runeharlyk/SpotMicroESP32-Leika/docs/software_description.md

# Software description

The firmware runs on ESP-IDF and is built through PlatformIO (`framework = espidf` in `platformio.ini`).
It targets the ESP32, ESP32-S3 and ESP32-P4; the environments are listed in `platformio.ini`.
The sensor drivers, the IMU fusion, the PCA9685 driver and the I2C bus layer are part of the repository (`esp32/include/peripherals`), not external libraries.

The external dependencies are:

- ESP-IDF components from the component manager (`esp32/src/idf_component.yml`): `espressif/mdns`, `joltwallet/littlefs`, `espressif/esp-dsp`, `espressif/led_strip`, and `espressif/esp32-camera` on every target except the ESP32-P4
- `esp_wifi_remote`, `esp_hosted` and `esp_cam_sensor` on the ESP32-P4 only, which reaches WiFi through an ESP32-C6 coprocessor and the camera through MIPI CSI
- [nanopb](https://github.com/nanopb/nanopb), a git submodule, for the protobuf messages in `platform_shared/`

#### Structure

The software runs these FreeRTOS tasks.

| Task | Description | Priority | Core |
| --- | --- | --- | --- |
| Control task | Applies controller input, runs the motion state and inverse kinematics, writes the servos, records telemetry. Runs every 10 ms (100 Hz) | 5 | 1 |
| Sensor task | Reads the IMU on every pass and the slower sensors when due. Paced by a 5 ms timer. Also runs bus work queued by the socket, such as an I2C scan or an IMU calibration | 4 | 1 |
| Service task | Starts WiFi, the access point, mDNS, the camera and the web server, then loops every 100 ms: access point management, periodic broadcasts, telemetry batches | 2 | any |
| HTTP server task | The ESP-IDF `esp_http_server` task: serves the web app, the camera stream and the WebSocket. Stack of 16 KiB | 5 | any |
| DNS server task | Captive portal on the access point | 3 | any |
| CSI capture task | Captures JPEG frames from the MIPI CSI camera (ESP32-P4 only) | 6 | 1 |

An mDNS query (priority 3) and the restart sequence (priority 10) each run in a short-lived task of their own.

The tasks share state in three ways, none of which can stall the control loop:

- The socket's handlers and the handheld controller's receiver post controller input, mode and gait to a mutex-guarded inbox (`motion_inbox.h`) that holds only the newest of each. The control task takes it once per tick, so only the control task touches the motion state.
- The sensor task writes its latest readings under a lock that is held only for the copy. The control and service tasks copy them out.
- The control task pushes telemetry ticks into a lock-free single-producer, single-consumer ring (`telemetry/spsc_ring.h`). A full ring refuses the tick and counts it as dropped; the control task never waits.

#### Control loop

Each 10 ms tick of the control task (`SpotControlLoopEntry` in `esp32/src/main.cpp`) does the following.

1. Copies the latest IMU sample.
1. Runs `MotionService::update`: applies the inbox, then steps the active motion state, solves the inverse kinematics and applies the per-joint sign.
1. On a mode change, activates or deactivates the servo board.
1. Runs `ServoController::update`: limits each joint's speed, converts the angles to PWM and writes all channels to the PCA9685 in one I2C burst.
1. Records a telemetry tick, but only while a client is subscribed to the telemetry stream.
1. Waits for the next tick. A tick that overran restarts the schedule instead of catching up.

The motion states, the command smoothing and the gaits are described in [Motion system](motion_system.md), and the kinematics in [Kinematics](kinematics.md).

#### Sensors

All sensors are optional.
The robot walks without any of them, but the stand mode levels the body only with an IMU.

Every driver is built in, and the sensor task probes the I2C bus at boot.
The IMU is the first chip that answers in the order ICM-20948, BNO055, MPU6050: the ICM-20948 and the MPU6050 share address 0x68, and starting an MPU6050 resets whatever chip is there.
A sensor disabled in the peripheral settings is only identified by its address and chip ID, so the app can show it as detected, and is never configured.
A change of what is disabled probes again, which restarts the fusion; other peripheral saves do not.

| Chip | Rate | Compass | Orientation |
| --- | --- | --- | --- |
| MPU6050 | 200 Hz | None; add an HMC5883L | Madgwick filter |
| ICM-20948 | 200 Hz | Built in (AK09916), 100 Hz | Madgwick filter |
| BNO055 | 100 Hz | Built in, 20 Hz | The chip's own NDOF fusion |

The `Imu` class (`peripherals/imu/imu.h`) turns a chip's readings into body-frame samples (x forward, y left, z up):

- The mounting matrix from the peripheral settings rotates the chip frame into the body frame.
- The gyro bias is measured at boot while the robot is still, over 200 samples. If the robot moves, the bias is left at zero.
- For the MPU6050 and the ICM-20948 a Madgwick filter fuses the gyro and the accelerometer, and the compass when a fresh reading exists. Its gain is an IMU setting that defaults to 0.1, and is 2.5 during the first two seconds so that the first estimate is quick. Without a compass the yaw drifts, and the sample says so with the `YAW_DRIFTS` flag.
- Each sample also carries the gyro's z rate integrated over every read since the IMU started (`gyroYaw`), from which the odometry takes the mean rate between the samples two control ticks find.
- The BNO055 reports its own fused quaternion, which is rotated by the mounting. The Madgwick filter is not used for it.
- A separate HMC5883L compass (75 Hz) supplies the compass for a chip without one. Its alignment, hard-iron offset and soft-iron matrix are IMU settings. A compass that has been silent for three of its periods is ignored. A disabled compass is left out of the fusion, the chip's own as well as a separate one; the BNO055's own fusion keeps using its compass.
- The tilt of a still robot can be folded into the stored mounting from the app, so that a robot on a level surface reads level. The tilt must be under 15 degrees.

The other sensors are read when due:

| Chip | Address | Rate | Reports |
| --- | --- | --- | --- |
| PAJ7620U2 gesture sensor | 0x73 | 100 ms | A gesture, which steps the modes |
| BMP180 barometer | 0x77 | 500 ms | Pressure, temperature and altitude |
| INA219 power sensor | 0x41 by default, 0x41 - 0x4F | 100 ms | The servo rail's voltage and current |

The INA219 sits in the servo rail; 0x40 is the PCA9685's, so its A0 is tied high, and its address is a peripheral setting.
Its calibration follows from the shunt resistance and the largest current expected, both settings (0.1 Ohm and 3.2 A by default): the current's resolution is that current over 2^15, and the shunt range the narrowest of 40 - 320 mV that holds it.
The bus voltage is averaged over 8.5 ms so that a dip shows, the shunt over 68 ms so that the current is the mean between reads.
A chip that reset, by a dip on its own supply, is configured again on the next read.
Below the cut-off voltage (a setting, 0 for off by default) for 2 s, the robot deactivates and logs why, and it is held deactivated until the rail rises 0.2 V above the cut-off; the servos going limp take their load off, so only a battery with charge left recovers that far.
A current above the stall current (3 A by default) for the stall time (1 s) sets a stall flag, which is only reported.
The readings stream as `PowerData`, and each telemetry network sample carries the rail's voltage, its lowest voltage since the previous sample and its current, so a recording shows the supply dips.
A gesture steps along the ladder rest - sit - stand (`esp32/include/gesture_control.h`): down from walk stands, down from stand plays the built-in `sit` clip and holds it, down again rests, and up steps back up to stand; left and right select walk.
From stand or walk, forward and backward walk 10 cm and anticlockwise and clockwise turn a full circle, as [goal moves](motion_system.md#goal-moves) on the odometry.
A gesture that arrives while a clip moves the legs or a goal runs is discarded, not queued.

#### Variant

The variant is a robot setting (`robotSettings.pb`), read in `app_main` before any task starts.
A change is accepted only while the robot is deactivated; it is stored and posted to the control task, which switches the motion code and the joint model in one tick and resets the body to the new variant's default pose.
It selects the leg geometry (`KIN_CONFIG_*` in `kinematics.h`) and the joint model (`joint_model.h`) through `variant.h`.
A robot without a variant has neither: the motion service refuses every mode but deactivated, and the servo board stays asleep.

#### Servo output

The twelve joints are driven by a PCA9685 at 50 Hz from a 27 MHz oscillator.
The board starts asleep with every channel off, so that the legs do not jump to the pose a board kept across a reset.
It wakes when a mode that moves the legs (rest, stand, walk) is selected or the app activates the servos.
Selecting a mode without a motion state (deactivated, idle, calibration) puts it back to sleep.

Each joint's PWM follows from three parts:

1. The joint model of the variant (`joint_model.h`): the sign of each joint, the servo angle at which the joint is at its kinematic zero, and the PWM counts per degree (2.0).
1. The robot's own calibration (`servoSettings.pb`): the centre PWM of each joint (306 by default) and, optionally, which PCA9685 channel each joint uses.
1. A clamp to 125 - 600 counts, the range the servos accept.

The joints do not follow their targets directly.
Each moves toward its target by at most 96 % of the MG92B's rated speed at the servo supply stored in the servo settings (`supply_voltage`, 6 V when never set): 720 degrees per second at 6 V, 443 at 4.8 V, linear in between and held at the nearer rating outside (`servoSpeedLimit` in `peripherals/servo_output.h`).
A tick counts as at most 20 ms long so that a stall does not release a jump.
A new supply holds from the next tick, and the control task hands the same limit to the walk, which caps its joints at three quarters of it.
This limit is the only filtering between the motion state's angles and the servos; the smoothing of the commands is done in the motion states.

#### Settings and communication

Services keep their settings as protobuf files in the `/config` directory of the LittleFS partition: WiFi, access point, camera, servo, peripheral (pins, I2C frequency, IMU, disabled sensors, LED strip) and robot (name and variant).
An invalid settings write is refused and leaves the stored settings unchanged.

Apart from the camera stream (`/api/camera/stream`, MJPEG) and the embedded web app, the robot's API is the WebSocket at `/api/ws`, carrying protobuf messages from `platform_shared/message.proto`.
Commands, periodic broadcasts, settings, file transfer and the per-tick telemetry stream all travel over it, see [WebSocket](websocket.md).
The protocol also travels over the serial link, beside the log, see [Serial link](serial.md): all of it on the USB-Serial-JTAG port, and requests only on the console UART.
A `SerialLink` adapter handles both ports, each as one client, and the log goes out through its writer so a line never splits a frame.
The firmware registers every handler on every link and sends each stream to its subscribers on each.
On the S3 boards with PSRAM, a `NimbleLink` adapter serves the app over a Bluetooth LE Nordic UART Service, with the commands, requests and broadcasts of the WebSocket but no telemetry and no file or firmware transfer, see [Bluetooth link](bluetooth.md).
The service task broadcasts the IMU, the sonars, the servo rail and RSSI every 100 ms and the system analytics every 2 s, to the clients that subscribed on any link.
The analytics include every task's least free stack since it started, tightest first (System metrics), which is what a stack can be trimmed by; the serial link's 8 KB read task is the one the heap budget points at.

The telemetry stream is recorded only while a client is subscribed.
The control task puts one sample per tick in a ring of 64 ticks, and the service task sends them in batches of 10, preceded by a header describing the robot's firmware, variant, IMU and settings.

#### Handheld controller

The robot can be driven without the app by the ESP-NOW handheld controller (the separate `esp-now-controller` firmware, shared with the Hexapod).
The receiver is switched on in the peripheral settings (the Sensors page) and is off by default, since it beacons ten times a second.
ESP-NOW broadcasts have no pairing, so the robot obeys the first controller whose frame it hears after the receiver starts and ignores every other sender; switching the receiver off and on lets another controller take over.
The switch applies at once.
The ESP32-P4 has no radio of its own for ESP-NOW, so it builds without the receiver and reports it unsupported (`espnow_controller_supported` in the features).

The controller broadcasts a 14-byte packet (`communication/controller_packet.h`, kept byte-identical with the controller firmware): a version, a button mask and four sticks in -1000 to 1000.
A frame of another length or version is ignored.
`HandheldController` (`communication/handheld_controller.h`) maps it as the Hexapod does:

| Input | Effect |
| --- | --- |
| Sticks | The app's sticks, scaled to -1 to 1 |
| Left stick button | The next mode of deactivated, rest, stand and walk, and from walk back to deactivated; from idle or calibration it selects rest |
| Right stick button | Toggles trot and crawl, except in stand |
| Right stick button held in stand | The right stick's y sets the body height instead of the pitch: centred is the default 0.7, the ends are the lowest and the highest; the height stays when the button is released |
| Both stick buttons | Deactivates, and does nothing else |
| Buttons A, B and C | Not used |

A button acts when it goes down; a press of both that lands one frame apart first acts as the single button.
The controller has no sliders, so the speed and the step height are the app's defaults of 0.5.
The receiver posts to the motion inbox as the socket's handlers do, so the controller is held to the same rules: no mode change during a firmware update, none but deactivated without a variant, and the dead-man stop when it falls silent while a stick is off centre.
It posts the input with every frame while a stick is off centre, and otherwise only when it changes, so an idle controller does not override the app; whichever of the two moved last is followed.

ESP-NOW hears only the channel the radio is on, and one radio serves the station, the access point and ESP-NOW: the channel is the router's while the station is joined and the access point's otherwise.
The robot broadcasts a beacon with its channel every 100 ms, and the controller hunts the channels until it hears it.
The beacon reads the channel at every send, so it follows every join and drop of the station, and the log reports each change.
Unlike the Hexapod, the robot does not pin the radio to a fixed channel, which would move the access point off its configured channel and drop the app.
While the station retries a network it cannot reach, its scans take the radio off the channel for a moment, and the controller may lose frames.

#### Build-time options

One firmware per PlatformIO environment serves every variant and every combination of sensors, and always embeds the web app.
What the board fixes stays a define in the environment's `build_flags`:

| Define | Description |
| --- | --- |
| USE_CAMERA | Camera and its stream, with the camera model's pins (`CAMERA_MODEL_*`); 0 when undefined |
| SDA_PIN, SCL_PIN | Default I2C pins, until the peripheral settings change them |
| WS2812_PIN | Default LED strip pin, until the peripheral settings change it |
| SD_CMD_PIN, SD_CLK_PIN, SD_D0_PIN | A 1-bit SD card slot (the ESP32-S3-EYE's, in `esp32-wroom-camera`); a card that answers at boot is mounted at `/sdcard` beside LittleFS, and a board without one boots as before |

### 📲 Controller

The controller is a SvelteKit app, which main focus is to calibrate and control the robot.

It is made to be included and hosted by the robot.
Therefore there is placed a lot of thought behind the functionality and dependencies.

The app is built three ways (see `app/README.md`).
The build that the robot serves (`pnpm build:embedded`) is embedded in the firmware image as compressed assets, and leaves out the 3D view and the simulation to save flash.
The hosted build (`pnpm build`) includes both.

The pages are:

| Page | Content |
| --- | --- |
| Connection | Finds and selects a robot, by address or by sweeping the local network. Hosted build only |
| Controller | Touch, keyboard (W A S D) and gamepad controls, sliders for body height, speed and step height, mode and gait selection, and a layout of widgets: 3D view, simulation, camera stream and charts |
| Peripherals | I2C scan, camera stream and settings, servo calibration, IMU view and calibration |
| WiFi | Station, access point and mDNS settings |
| System | Status, metrics and the robot's file system |

#### Development dependencies

For the development dependencies I choose the following

| Dependencies | Description |
| --- | --- |
| SvelteKit | SvelteKit is an application framework built on top of Svelte, enhancing it with features like routing, server-side rendering, and static site generation. It streamlines the development process by integrating server-side capabilities with Svelte's client-side benefits. Furthermore it make the development process fast and enjoyable. |
| Vite | Vite is a frontend tool that is used for building fast and optimized web applications. Is serves code local during development and bundles assets for production |
| Typescript | TypeScript's integration of static typing enhances code reliability and maintainability. |
| Tailwind CSS | Tailwind CSS accelerates web development with its utility-first approach, ensuring rapid styling and consistent design. daisyUI supplies the components. |

#### Libraries

For the app functionality I choose the following:

| Dependencies | Description |
| --- | --- |
| [Three](https://www.npmjs.com/package/three) | Easy to use, lightweight, cross-browser, general purpose 3D library. |
| [Urdf-loader](https://www.npmjs.com/package/urdf-loader) | Utilities for loading URDF files into THREE.js and a Web Component that loads and renders the model. |
| [Xacro-parser](https://www.npmjs.com/package/xacro-parser) | Javascript parser and loader for processing the ROS Xacro file format. |
| [MuJoCo](https://www.npmjs.com/package/@mujoco/mujoco) | The MuJoCo physics engine as WebAssembly, for the simulation in the browser. |
| [Protobuf-ES](https://www.npmjs.com/package/@bufbuild/protobuf) | Runtime for the protobuf messages that ts-proto generates from `platform_shared/`. |
| [NippleJS](https://www.npmjs.com/package/nipplejs) | A vanilla virtual joystick for touch capable interfaces. |
| [Uzip](https://www.npmjs.com/package/uzip) | Simple, tiny and fast ZIP library. |
| [ChartJS](https://www.npmjs.com/package/chart.js) | Simple and flexible charting library. |
