runeharlyk/SpotMicroESP32-Leika/docs/media/circuit.png

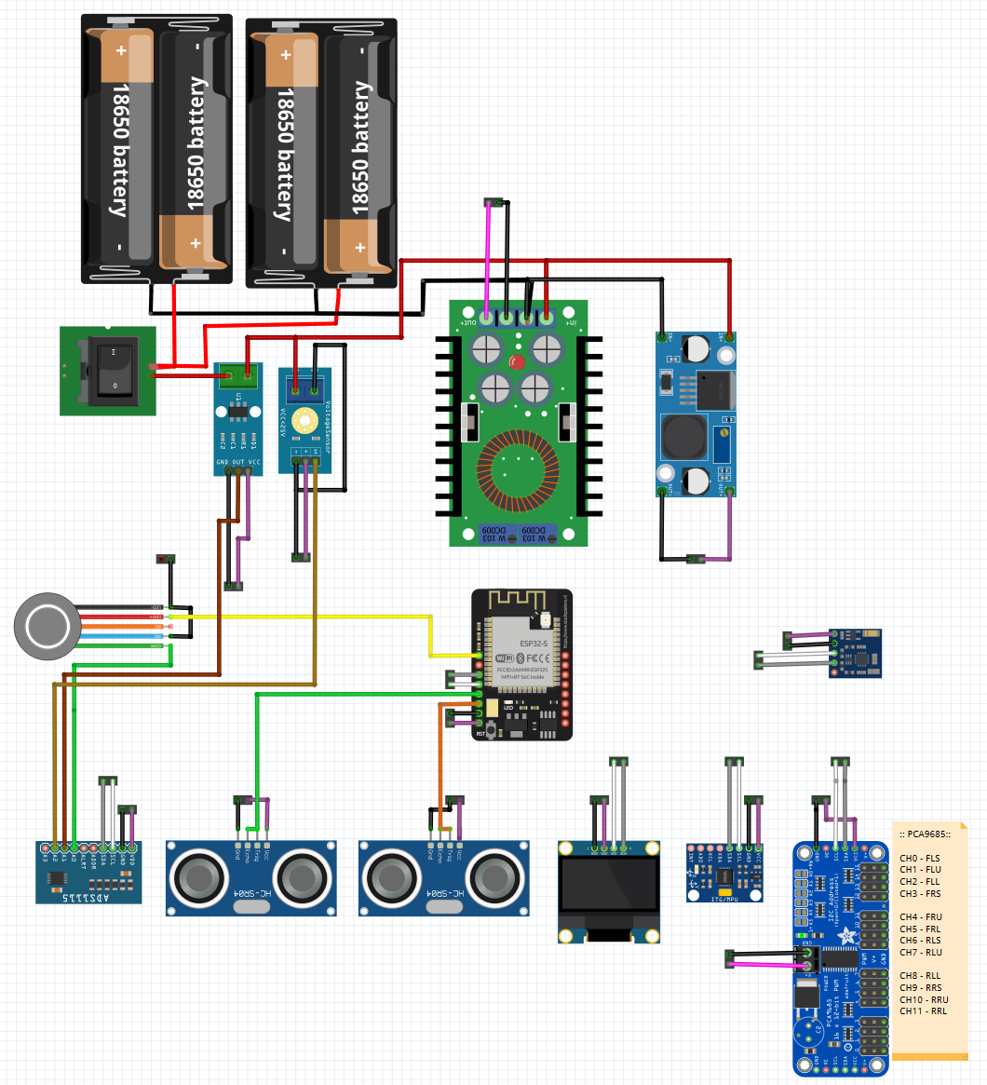
docs/media/circuit.png
