runeharlyk/SpotMicroESP32-Leika/docs/media/controller.png

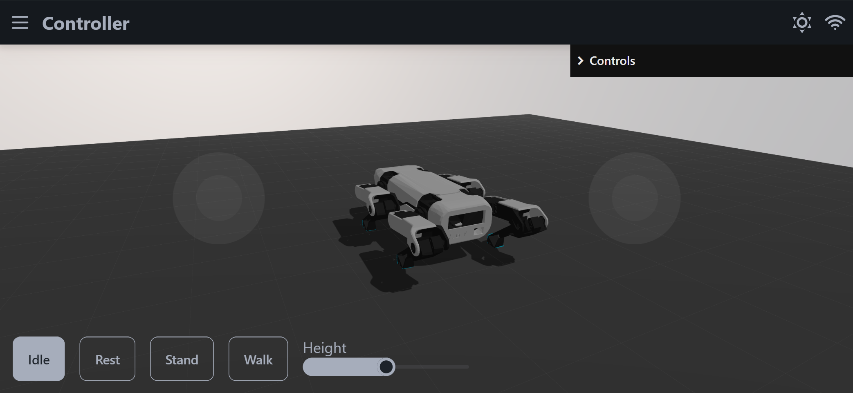
docs/media/controller.png
