runeharlyk/SpotMicroESP32-Leika/docs/media/diagram.png

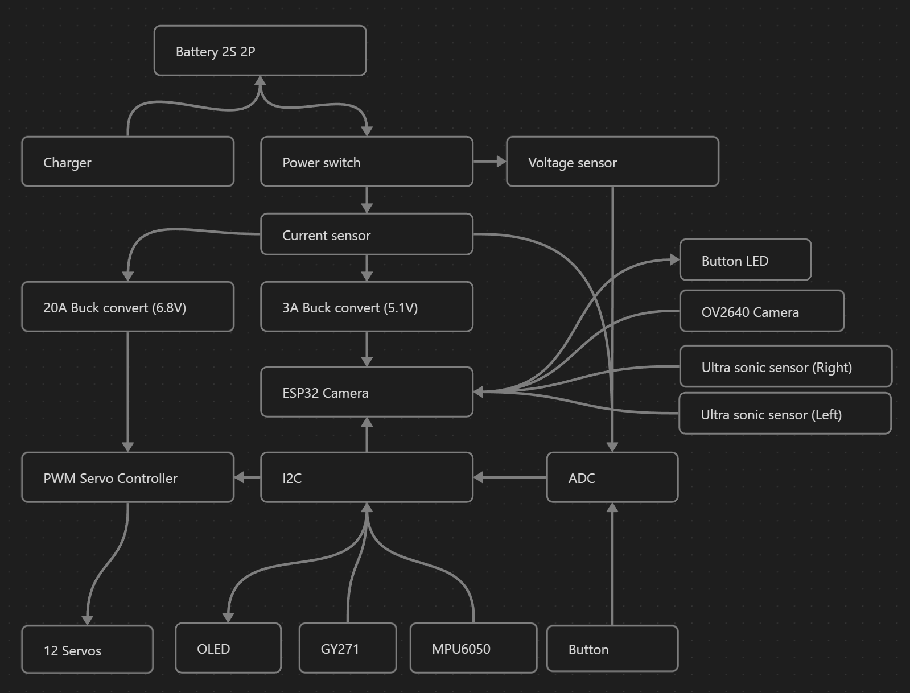
docs/media/diagram.png
