runeharlyk/SpotMicroESP32-Leika/simulation/src/resources/stl/rplidar_main.STL

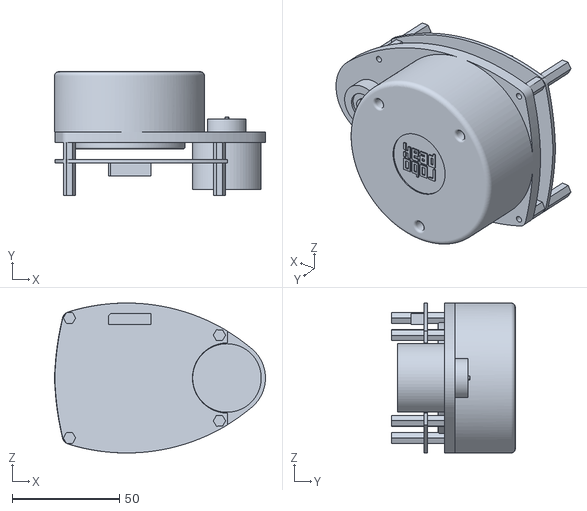
[picture p7: CAD file, 2025-10-10]
simulation/src/resources/stl/rplidar_main.STL
98.5 x 57.7 x 70.0
