runeharlyk/SpotMicroESP32-Leika/simulation/src/resources/stl/mainbody.stl

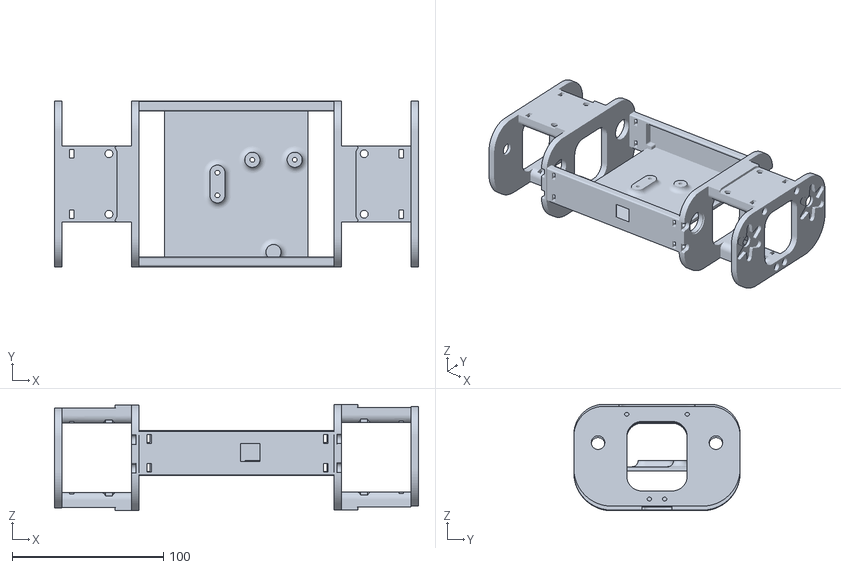
[picture p8: CAD file, 2025-10-10]
simulation/src/resources/stl/mainbody.stl
240.7 x 110.0 x 70.4
