runeharlyk/SpotMicroESP32-Leika/app/static/URDF/tibia.stl

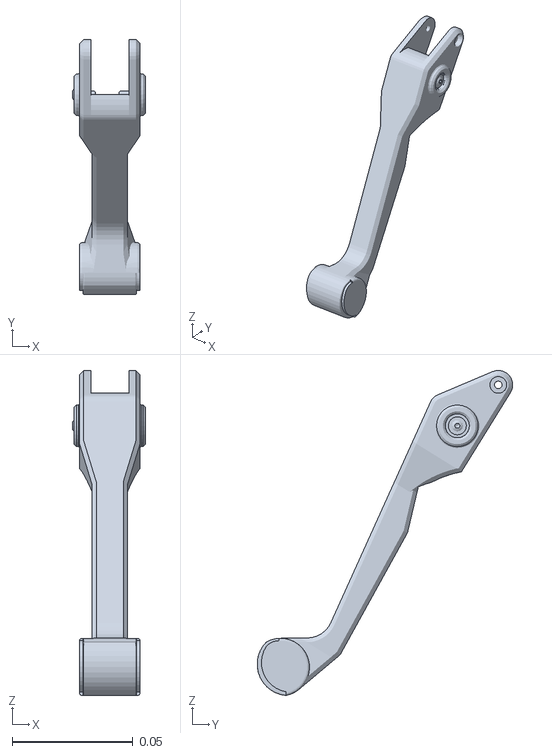
[picture p9: CAD file, 2025-07-11]
app/static/URDF/tibia.stl
0.0304 x 0.106 x 0.135
