runeharlyk/SpotMicroESP32-Leika/hardware/printable/helper_stand/2x_stand_bottom.stl

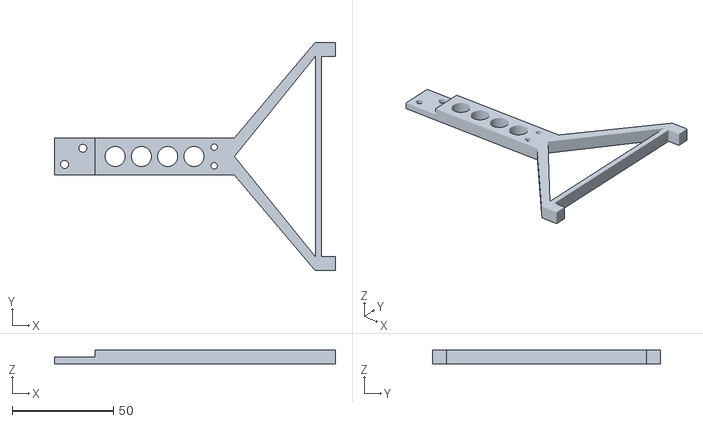
[picture p10: CAD file, 2024-11-04]
hardware/printable/helper_stand/2x_stand_bottom.stl
139.0 x 113.0 x 7.00
