runeharlyk/SpotMicroESP32-Leika/simulation/src/resources/stl/rfoot.stl

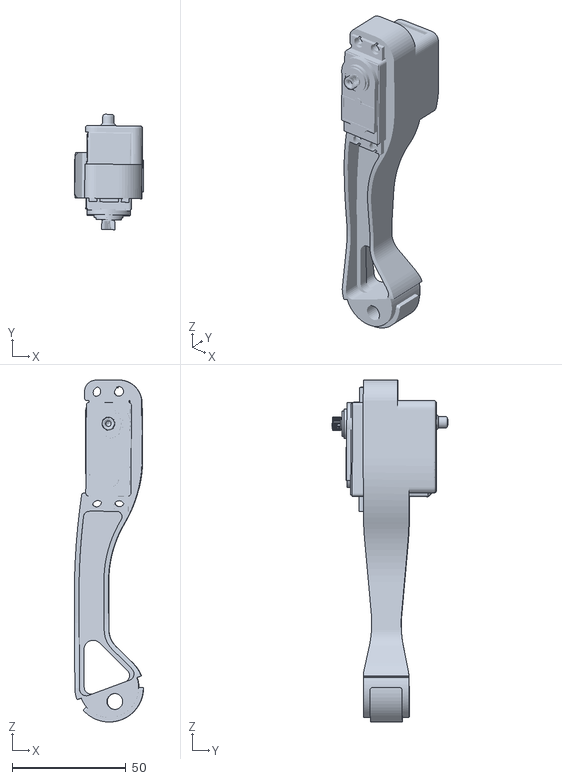
[picture p11: CAD file, 2025-10-10]
simulation/src/resources/stl/rfoot.stl
30.4 x 50.7 x 150.0
