runeharlyk/SpotMicroESP32-Leika/app/static/URDF/lb shoulder.stl

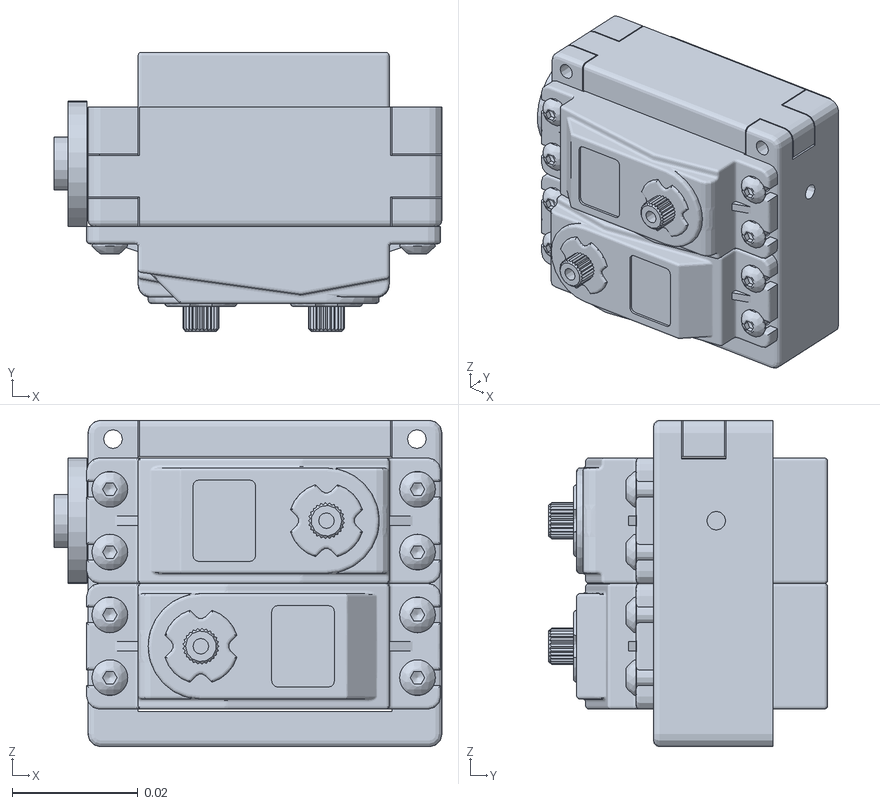
[picture p12: CAD file, 2025-07-11]
app/static/URDF/lb shoulder.stl
0.0618 x 0.0445 x 0.052
