runeharlyk/SpotMicroESP32-Leika/hardware/printable/helper_stand/4x_stand_feet.stl

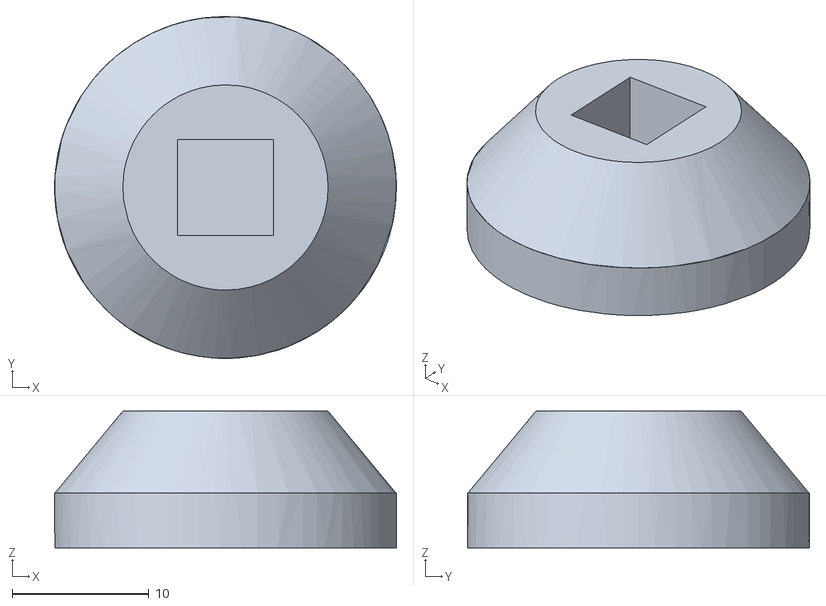
[picture p13: CAD file, 2024-11-04]
hardware/printable/helper_stand/4x_stand_feet.stl
25.0 x 25.0 x 10.0
