runeharlyk/SpotMicroESP32-Leika/simulation/src/resources/stl/larm_cover.stl

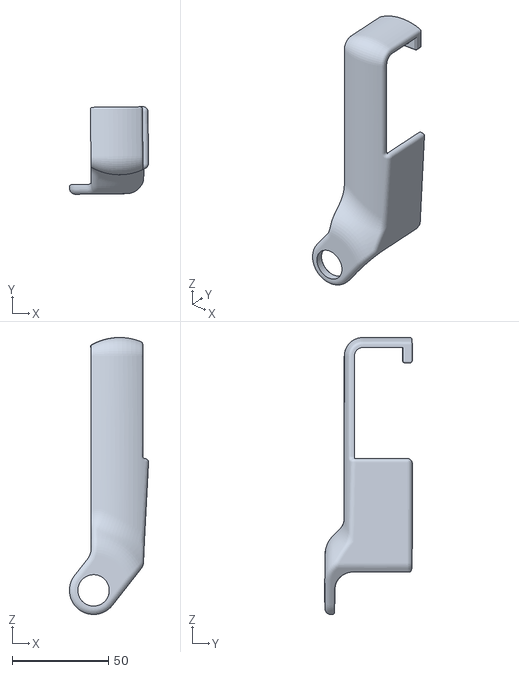
[picture p14: CAD file, 2025-10-10]
simulation/src/resources/stl/larm_cover.stl
41.0 x 45.4 x 143.5
