runeharlyk/SpotMicroESP32-Leika/app/static/URDF/shell.stl

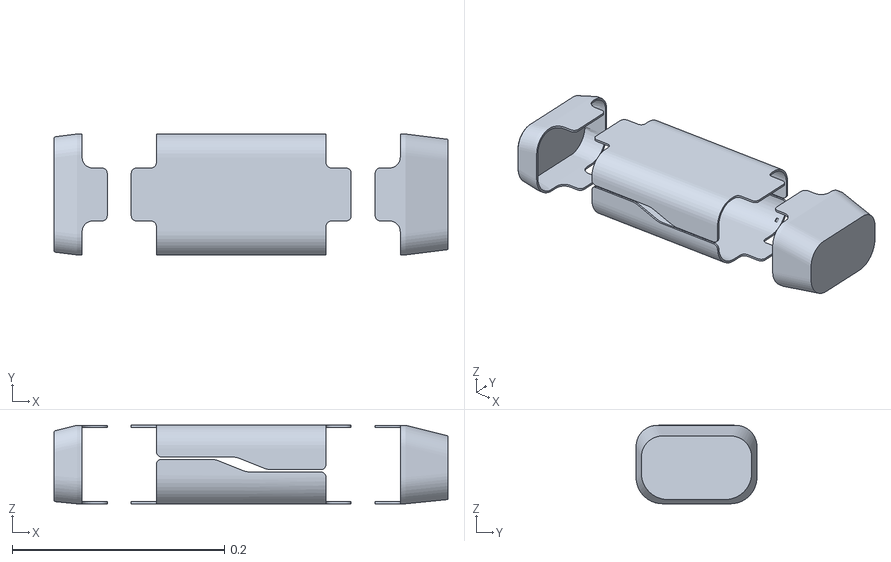
[picture p15: CAD file, 2025-07-11]
app/static/URDF/shell.stl
0.372 x 0.114 x 0.0741
