runeharlyk/SpotMicroESP32-Leika/hardware/printable/helper_stand/2x_stand_top.stl

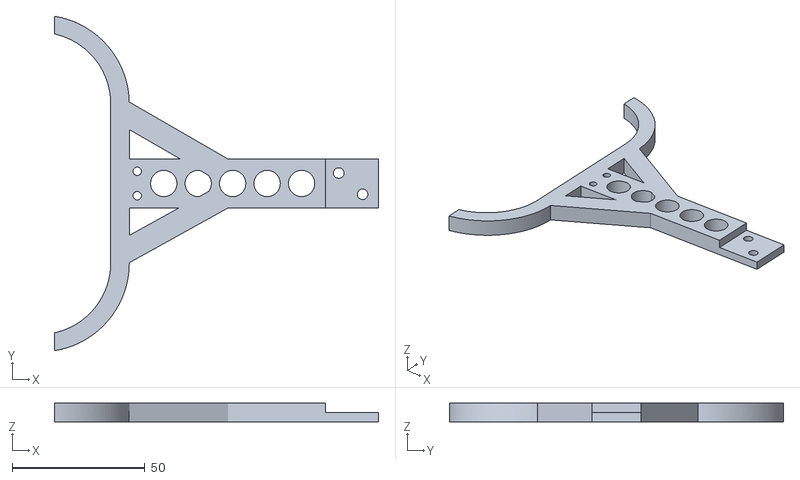
[picture p16: CAD file, 2024-11-04]
hardware/printable/helper_stand/2x_stand_top.stl
122.2 x 126.2 x 7.00
