runeharlyk/SpotMicroESP32-Leika/simulation/src/resources/stl/rarm.stl

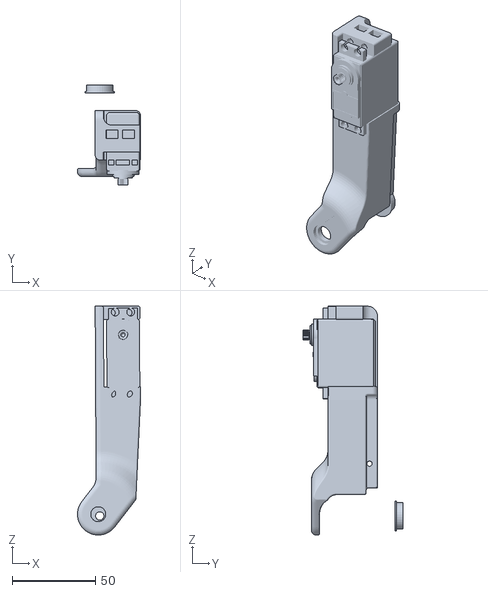
[picture p17: CAD file, 2025-10-10]
simulation/src/resources/stl/rarm.stl
37.9 x 60.2 x 137.5
