runeharlyk/SpotMicroESP32-Leika/app/static/URDF/frame.stl

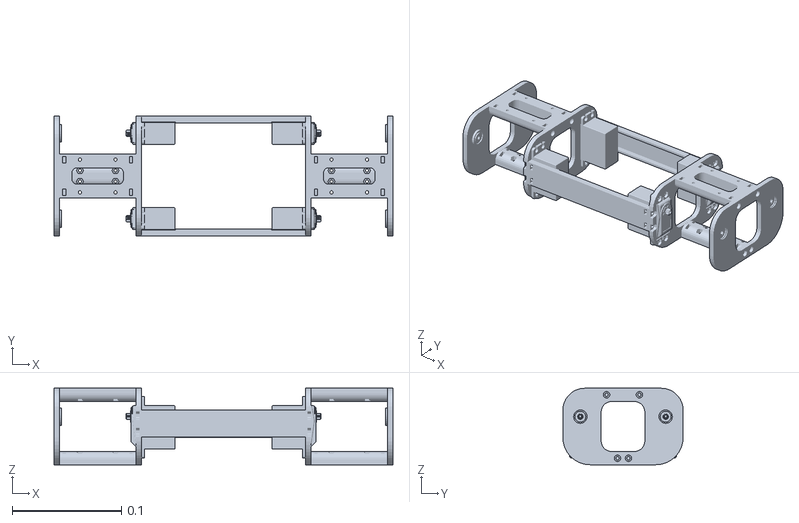
[picture p18: CAD file, 2025-07-11]
app/static/URDF/frame.stl
0.31 x 0.11 x 0.07
