runeharlyk/SpotMicroESP32-Leika/hardware/printable/helper_stand/2x_stand_brace.stl

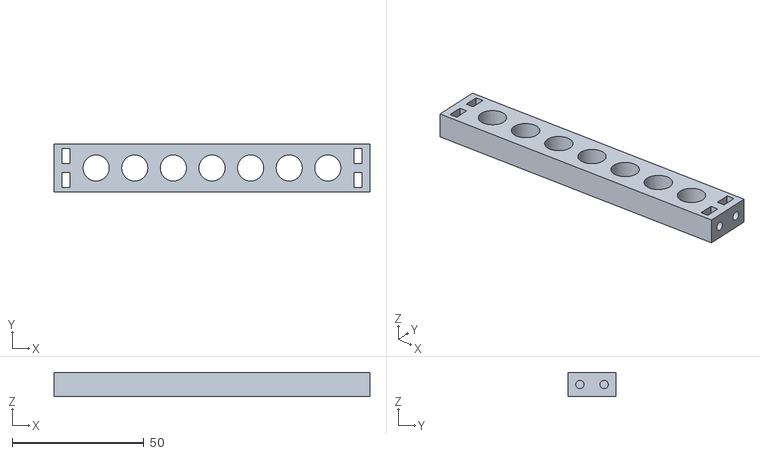
[picture p19: CAD file, 2024-11-04]
hardware/printable/helper_stand/2x_stand_brace.stl
120.0 x 18.4 x 9.20
