runeharlyk/SpotMicroESP32-Leika/simulation/src/resources/stl/lshoulder.stl

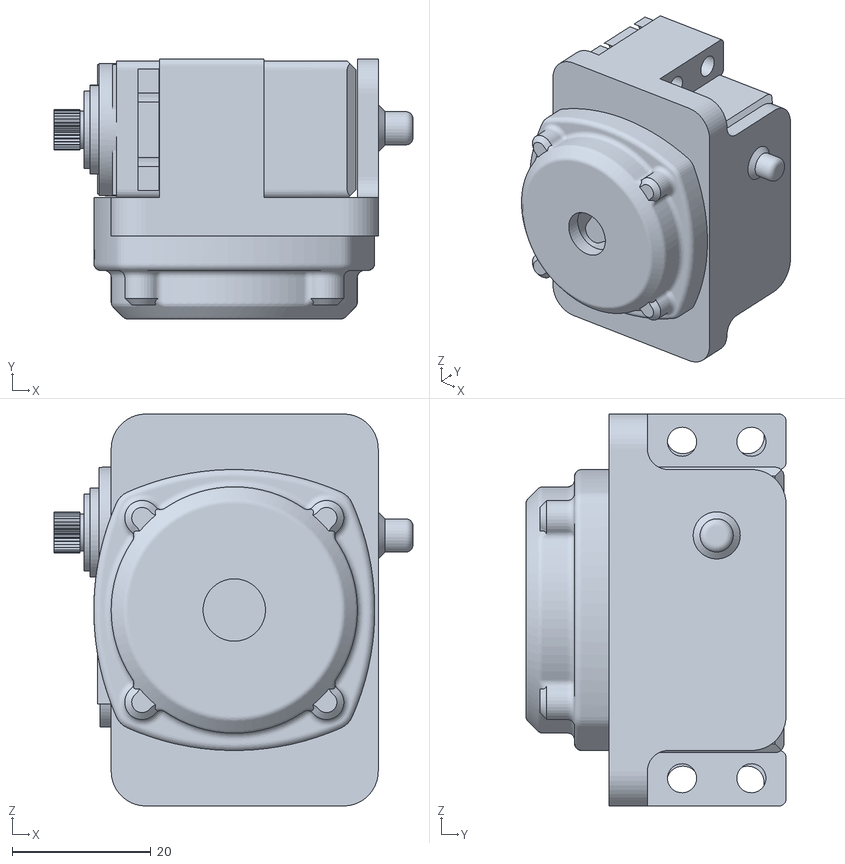
[picture p20: CAD file, 2025-10-10]
simulation/src/resources/stl/lshoulder.stl
51.7 x 37.5 x 56.5
