runeharlyk/SpotMicroESP32-Leika/simulation/src/resources/stl/frontpart.stl

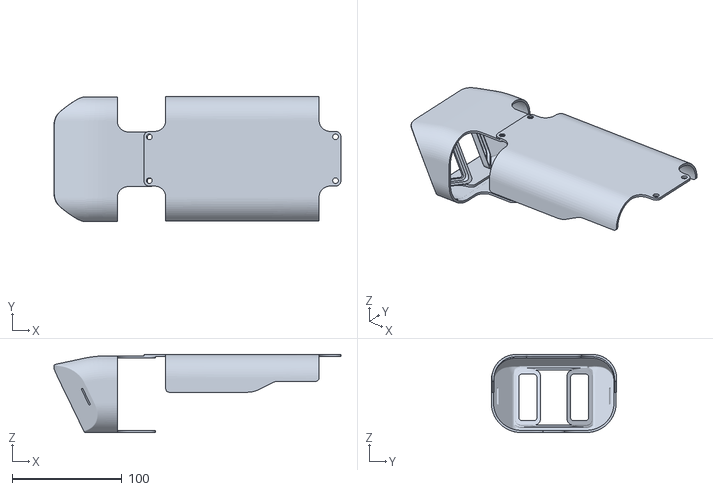
[picture p21: CAD file, 2025-10-10]
simulation/src/resources/stl/frontpart.stl
262.0 x 114.5 x 71.2
