runeharlyk/SpotMicroESP32-Leika/app/static/URDF/femur.stl

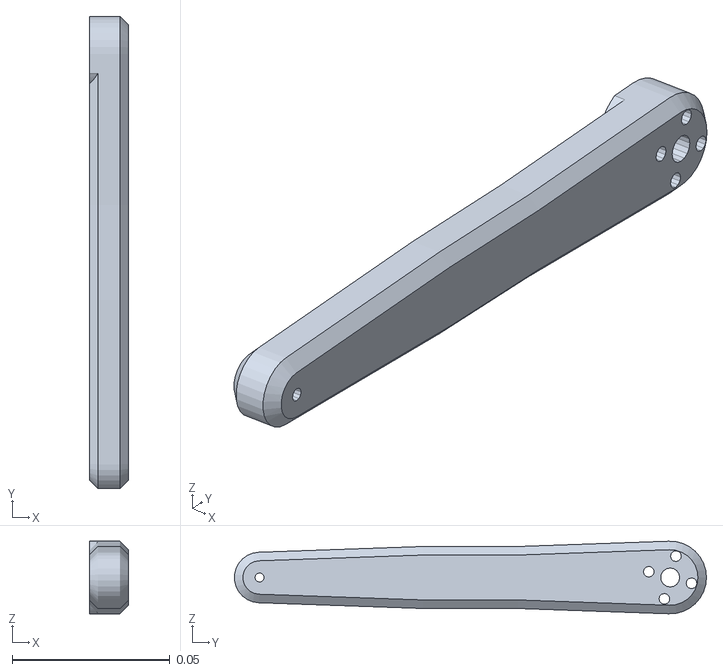
[picture p22: CAD file, 2025-07-11]
app/static/URDF/femur.stl
0.0125 x 0.149 x 0.023
