runeharlyk/SpotMicroESP32-Leika/simulation/src/resources/stl/backpart.stl

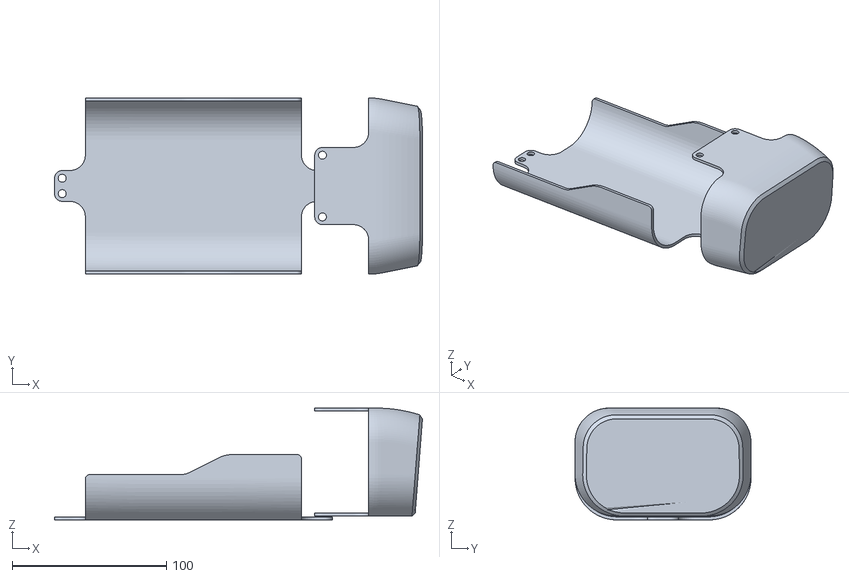
[picture p23: CAD file, 2025-10-10]
simulation/src/resources/stl/backpart.stl
238.4 x 114.1 x 72.5
