runeharlyk/SpotMicroESP32-Leika/simulation/src/resources/stl/foot.stl

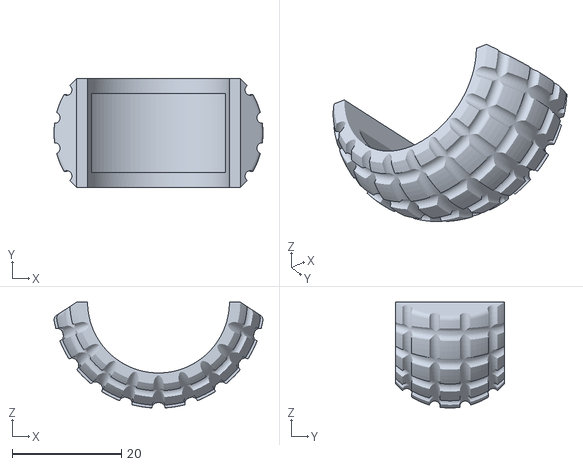
[picture p24: CAD file, 2025-10-10]
simulation/src/resources/stl/foot.stl
38.3 x 20.0 x 19.4
