runeharlyk/SpotMicroESP32-Leika/(list of files, cad)

Other CAD files:
app/static/URDF/lf shoulder.stl
app/static/URDF/rb shoulder.stl
simulation/src/resources/stl/larm.stl
app/static/URDF/rf shoulder.stl
simulation/src/resources/stl/rarm_cover.stl
simulation/src/resources/stl/rshoulder.stl
simulation/src/resources/stl/lfoot.stl
