runeharlyk/SpotMicroESP32-Leika/(threads)

Thread 1 (2023-08-12):

Unable to Test Repository as It Cannot Be Uploaded

robo78, 2023-08-12:
platformio.exe run
Processing esp32cam (board: esp32cam; platform: espressif32; framework: arduino)
------------------------------------------------------------------------------------------------------------------------
Verbose mode can be enabled via `-v, --verbose` option
CONFIGURATION: https://docs.platformio.org/page/boards/espressif32/esp32cam.html
PLATFORM: Espressif 32 (6.3.2) > AI Thinker ESP32-CAM
HARDWARE: ESP32 240MHz, 320KB RAM, 4MB Flash
DEBUG: Current (cmsis-dap) External (cmsis-dap, esp-bridge, esp-prog, iot-bus-jtag, jlink, minimodule, olimex-arm-usb-ocd, olimex-arm-usb-ocd-h, olimex-arm-usb-tiny-h, olimex-jtag-tiny, tumpa)
PACKAGES:
 - framework-arduinoespressif32 @ 3.20009.0 (2.0.9)
 - tool-esptoolpy @ 1.40501.0 (4.5.1)
 - toolchain-xtensa-esp32 @ 8.4.0+2021r2-patch5
LDF: Library Dependency Finder -> https://bit.ly/configure-pio-ldf
LDF Modes: Finder ~ chain, Compatibility ~ soft
Found 47 compatible libraries
Scanning dependencies...
Dependency Graph
|-- ESP Async WebServer @ 1.2.3+sha.f71e3d4
|-- ArduinoJson @ 6.21.3
|-- Bounce2 @ 2.71.0
|-- NewPing @ 1.9.7
|-- Adafruit SSD1306 @ 2.5.7
|-- Adafruit GFX Library @ 1.11.7
|-- Adafruit BusIO @ 1.14.1
|-- Adafruit PWM Servo Driver Library @ 2.4.1
|-- Adafruit ADS1X15 @ 2.4.0
|-- Adafruit HMC5883 Unified @ 1.2.1
|-- Adafruit Unified Sensor @ 1.1.11
|-- UrlEncode @ 1.0.1
|-- MPU6050_light @ 1.1.0
|-- HTTPClient @ 2.0.0
|-- SPIFFS @ 2.0.0
|-- ArduinoOTA @ 2.0.0
|-- DNSServer @ 2.0.0
|-- ESPmDNS @ 2.0.0
|-- WiFi @ 2.0.0
|-- Wire @ 2.0.0
|-- Update @ 2.0.0
Building in release mode
Compiling .pio\build\esp32cam\src\camera.cpp.o
Compiling .pio\build\esp32cam\src\deviceconfig.cpp.o
Compiling .pio\build\esp32cam\src\jsonserializer.cpp.o
Compiling .pio\build\esp32cam\src\main.cpp.o
Compiling .pio\build\esp32cam\src\network.cpp.o
Compiling .pio\build\esp32cam\src\servo.cpp.o
Compiling .pio\build\esp32cam\src\webserver.cpp.o
Compiling .pio\build\esp32cam\lib8da\FS\vfs_api.cpp.o
In file included from src/camera.cpp:2:
include/camera_pins.h:296:2: error: #error "Camera model not selected"
 #error "Camera model not selected"
  ^~~~~
In file included from include/globals.h:80,
                 from include/servo.h:5,
                 from src/camera.cpp:1:
include/webserver.h: In constructor 'CWebServer::CWebServer()':
include/webserver.h:123:19: error: 'HTTP_PORT' was not declared in this scope
         : _server(HTTP_PORT)
                   ^~~~~~~~~
include/webserver.h:123:19: note: suggested alternative: 'HTTP_POST'
         : _server(HTTP_PORT)
                   ^~~~~~~~~
                   HTTP_POST
include/webserver.h:125:15: error: 'WEBSOCKET_PATH' was not declared in this scope
         , _ws(WEBSOCKET_PATH)
               ^~~~~~~~~~~~~~
include/webserver.h:125:15: note: suggested alternative: 'LWIP_SOCKET_POLL'
         , _ws(WEBSOCKET_PATH)
               ^~~~~~~~~~~~~~
               LWIP_SOCKET_POLL
include/webserver.h: In member function 'void CWebServer::begin()':
include/webserver.h:133:56: error: 'HOSTNAME' was not declared in this scope
         DefaultHeaders::Instance().addHeader("Server", HOSTNAME);
                                                        ^~~~~~~~
include/webserver.h:133:56: note: suggested alternative: 'ESTALE'
         DefaultHeaders::Instance().addHeader("Server", HOSTNAME);
                                                        ^~~~~~~~
                                                        ESTALE
src/camera.cpp: In function 'esp_err_t InitializeCamera()':
src/camera.cpp:9:28: error: 'Y2_GPIO_NUM' was not declared in this scope
     camera_config.pin_d0 = Y2_GPIO_NUM;
                            ^~~~~~~~~~~
src/camera.cpp:9:28: note: suggested alternative: 'GPIO_NUM_9'
     camera_config.pin_d0 = Y2_GPIO_NUM;
                            ^~~~~~~~~~~
                            GPIO_NUM_9
src/camera.cpp:10:28: error: 'Y3_GPIO_NUM' was not declared in this scope
     camera_config.pin_d1 = Y3_GPIO_NUM;
                            ^~~~~~~~~~~
src/camera.cpp:10:28: note: suggested alternative: 'GPIO_NUM_9'
     camera_config.pin_d1 = Y3_GPIO_NUM;
                            ^~~~~~~~~~~
                            GPIO_NUM_9
src/camera.cpp:11:28: error: 'Y4_GPIO_NUM' was not declared in this scope
     camera_config.pin_d2 = Y4_GPIO_NUM;
                            ^~~~~~~~~~~
src/camera.cpp:11:28: note: suggested alternative: 'GPIO_NUM_9'
     camera_config.pin_d2 = Y4_GPIO_NUM;
                            ^~~~~~~~~~~
                            GPIO_NUM_9
src/camera.cpp:12:28: error: 'Y5_GPIO_NUM' was not declared in this scope
     camera_config.pin_d3 = Y5_GPIO_NUM;
                            ^~~~~~~~~~~
src/camera.cpp:12:28: note: suggested alternative: 'GPIO_NUM_9'
     camera_config.pin_d3 = Y5_GPIO_NUM;
                            ^~~~~~~~~~~
                            GPIO_NUM_9
src/camera.cpp:13:28: error: 'Y6_GPIO_NUM' was not declared in this scope
     camera_config.pin_d4 = Y6_GPIO_NUM;
                            ^~~~~~~~~~~
src/camera.cpp:13:28: note: suggested alternative: 'GPIO_NUM_9'
     camera_config.pin_d4 = Y6_GPIO_NUM;
                            ^~~~~~~~~~~
                            GPIO_NUM_9
src/camera.cpp:14:28: error: 'Y7_GPIO_NUM' was not declared in this scope
     camera_config.pin_d5 = Y7_GPIO_NUM;
                            ^~~~~~~~~~~
src/camera.cpp:14:28: note: suggested alternative: 'GPIO_NUM_9'
     camera_config.pin_d5 = Y7_GPIO_NUM;
                            ^~~~~~~~~~~
                            GPIO_NUM_9
src/camera.cpp:15:28: error: 'Y8_GPIO_NUM' was not declared in this scope
     camera_config.pin_d6 = Y8_GPIO_NUM;
                            ^~~~~~~~~~~
src/camera.cpp:15:28: note: suggested alternative: 'GPIO_NUM_9'
     camera_config.pin_d6 = Y8_GPIO_NUM;
                            ^~~~~~~~~~~
                            GPIO_NUM_9
src/camera.cpp:16:28: error: 'Y9_GPIO_NUM' was not declared in this scope
     camera_config.pin_d7 = Y9_GPIO_NUM;
                            ^~~~~~~~~~~
src/camera.cpp:16:28: note: suggested alternative: 'GPIO_NUM_9'
     camera_config.pin_d7 = Y9_GPIO_NUM;
                            ^~~~~~~~~~~
                            GPIO_NUM_9
src/camera.cpp:17:30: error: 'XCLK_GPIO_NUM' was not declared in this scope
     camera_config.pin_xclk = XCLK_GPIO_NUM;
                              ^~~~~~~~~~~~~
src/camera.cpp:17:30: note: suggested alternative: 'SPI_CLK_GPIO_NUM'
     camera_config.pin_xclk = XCLK_GPIO_NUM;
                              ^~~~~~~~~~~~~
                              SPI_CLK_GPIO_NUM
src/camera.cpp:18:30: error: 'PCLK_GPIO_NUM' was not declared in this scope
     camera_config.pin_pclk = PCLK_GPIO_NUM;
                              ^~~~~~~~~~~~~
src/camera.cpp:18:30: note: suggested alternative: 'SPI_CLK_GPIO_NUM'
     camera_config.pin_pclk = PCLK_GPIO_NUM;
                              ^~~~~~~~~~~~~
                              SPI_CLK_GPIO_NUM
src/camera.cpp:19:31: error: 'VSYNC_GPIO_NUM' was not declared in this scope
     camera_config.pin_vsync = VSYNC_GPIO_NUM;
                               ^~~~~~~~~~~~~~
In file included from include/servo.h:6,
                 from include/globals.h:72,
                 from src/main.cpp:1:
include/webserver.h: In constructor 'CWebServer::CWebServer()':
include/webserver.h:123:19: error: 'HTTP_PORT' was not declared in this scope
         : _server(HTTP_PORT)
                   ^~~~~~~~~
include/webserver.h:123:19: note: suggested alternative: 'HTTP_POST'
         : _server(HTTP_PORT)
                   ^~~~~~~~~
                   HTTP_POST
include/webserver.h:125:15: error: 'WEBSOCKET_PATH' was not declared in this scope
         , _ws(WEBSOCKET_PATH)
               ^~~~~~~~~~~~~~
In file included from include/servo.h:6,
                 from include/globals.h:72,
                 from src/deviceconfig.cpp:3:
include/webserver.h: In constructor 'CWebServer::CWebServer()':
include/webserver.h:123:19: error: 'HTTP_PORT' was not declared in this scope
         : _server(HTTP_PORT)
                   ^~~~~~~~~
src/camera.cpp:19:31: note: suggested alternative: 'SPI_D_GPIO_NUM'
     camera_config.pin_vsync = VSYNC_GPIO_NUM;
                               ^~~~~~~~~~~~~~
                               SPI_D_GPIO_NUM
src/camera.cpp:20:30: error: 'HREF_GPIO_NUM' was not declared in this scope
     camera_config.pin_href = HREF_GPIO_NUM;
                              ^~~~~~~~~~~~~
include/webserver.h:123:19: note: suggested alternative: 'HTTP_POST'
         : _server(HTTP_PORT)
                   ^~~~~~~~~
                   HTTP_POST
include/webserver.h:125:15: error: 'WEBSOCKET_PATH' was not declared in this scope
         , _ws(WEBSOCKET_PATH)
               ^~~~~~~~~~~~~~
src/camera.cpp:20:30: note: suggested alternative: 'SPI_D_GPIO_NUM'
     camera_config.pin_href = HREF_GPIO_NUM;
                              ^~~~~~~~~~~~~
                              SPI_D_GPIO_NUM
src/camera.cpp:21:19: warning: 'camera_config_t::<unnamed union>::pin_sscb_sda' is deprecated: please use pin_sccb_sda instead [-Wdeprecated-declarations]
     camera_config.pin_sscb_sda = SIOD_GPIO_NUM;
                   ^~~~~~~~~~~~
In file included from include/AsyncJpegStream.h:2,
                 from include/webserver.h:12,
                 from include/globals.h:80,
                 from include/servo.h:5,
                 from src/camera.cpp:1:
C:/Users/rzieb/.platformio/packages/framework-arduinoespressif32/tools/sdk/esp32/include/esp32-camera/driver/include/esp_camera.h:117:87: note: declared here
         int pin_sscb_sda __attribute__((deprecated("please use pin_sccb_sda instead")));           /*!< GPIO pin for camera SDA line (legacy name) */
                                                                                       ^
include/webserver.h:125:15: note: suggested alternative: 'LWIP_SOCKET_POLL'
         , _ws(WEBSOCKET_PATH)
               ^~~~~~~~~~~~~~
               LWIP_SOCKET_POLL
src/camera.cpp:21:19: warning: 'camera_config_t::<unnamed union>::pin_sscb_sda' is deprecated: please use pin_sccb_sda instead [-Wdeprecated-declarations]
     camera_config.pin_sscb_sda = SIOD_GPIO_NUM;
                   ^~~~~~~~~~~~
In file included from include/AsyncJpegStream.h:2,
                 from include/webserver.h:12,
                 from include/globals.h:80,
                 from include/servo.h:5,
                 from src/camera.cpp:1:
C:/Users/rzieb/.platformio/packages/framework-arduinoespressif32/tools/sdk/esp32/include/esp32-camera/driver/include/esp_camera.h:117:87: note: declared here
         int pin_sscb_sda __attribute__((deprecated("please use pin_sccb_sda instead")));           /*!< GPIO pin for camera SDA line (legacy name) */
                                                                                       ^
src/camera.cpp:21:19: warning: 'camera_config_t::<unnamed union>::pin_sscb_sda' is deprecated: please use pin_sccb_sda instead [-Wdeprecated-declarations]
     camera_config.pin_sscb_sda = SIOD_GPIO_NUM;
                   ^~~~~~~~~~~~
In file included from include/AsyncJpegStream.h:2,
                 from include/webserver.h:12,
                 from include/globals.h:80,
                 from include/servo.h:5,
                 from src/camera.cpp:1:
C:/Users/rzieb/.platformio/packages/framework-arduinoespressif32/tools/sdk/esp32/include/esp32-camera/driver/include/esp_camera.h:117:87: note: declared here
         int pin_sscb_sda __attribute__((deprecated("please use pin_sccb_sda instead")));           /*!< GPIO pin for camera SDA line (legacy name) */
                                                                                       ^
src/camera.cpp:21:34: error: 'SIOD_GPIO_NUM' was not declared in this scope
     camera_config.pin_sscb_sda = SIOD_GPIO_NUM;
                                  ^~~~~~~~~~~~~
include/webserver.h:125:15: note: suggested alternative: 'LWIP_SOCKET_POLL'
         , _ws(WEBSOCKET_PATH)
               ^~~~~~~~~~~~~~
               LWIP_SOCKET_POLL
include/webserver.h: In member function 'void CWebServer::begin()':
include/webserver.h:133:56: error: 'HOSTNAME' was not declared in this scope
         DefaultHeaders::Instance().addHeader("Server", HOSTNAME);
                                                        ^~~~~~~~
include/webserver.h: In member function 'void CWebServer::begin()':
include/webserver.h:133:56: error: 'HOSTNAME' was not declared in this scope
         DefaultHeaders::Instance().addHeader("Server", HOSTNAME);
                                                        ^~~~~~~~
include/webserver.h:133:56: note: suggested alternative: 'ESTALE'
         DefaultHeaders::Instance().addHeader("Server", HOSTNAME);
                                                        ^~~~~~~~
                                                        ESTALE
src/camera.cpp:21:34: note: suggested alternative: 'SPI_D_GPIO_NUM'
     camera_config.pin_sscb_sda = SIOD_GPIO_NUM;
                                  ^~~~~~~~~~~~~
                                  SPI_D_GPIO_NUM
src/camera.cpp:22:19: warning: 'camera_config_t::<unnamed union>::pin_sscb_scl' is deprecated: please use pin_sccb_scl instead [-Wdeprecated-declarations]
     camera_config.pin_sscb_scl = SIOC_GPIO_NUM;
                   ^~~~~~~~~~~~
In file included from include/AsyncJpegStream.h:2,
                 from include/webserver.h:12,
                 from include/globals.h:80,
                 from include/servo.h:5,
                 from src/camera.cpp:1:
C:/Users/rzieb/.platformio/packages/framework-arduinoespressif32/tools/sdk/esp32/include/esp32-camera/driver/include/esp_camera.h:121:87: note: declared here
         int pin_sscb_scl __attribute__((deprecated("please use pin_sccb_scl instead")));           /*!< GPIO pin for camera SCL line (legacy name) */
                                                                                       ^
src/camera.cpp:22:19: warning: 'camera_config_t::<unnamed union>::pin_sscb_scl' is deprecated: please use pin_sccb_scl instead [-Wdeprecated-declarations]
     camera_config.pin_sscb_scl = SIOC_GPIO_NUM;
                   ^~~~~~~~~~~~
In file included from include/servo.h:6,
                 from include/globals.h:72,
                 from src/network.cpp:1:
include/webserver.h: In constructor 'CWebServer::CWebServer()':
include/webserver.h:123:19: error: 'HTTP_PORT' was not declared in this scope
         : _server(HTTP_PORT)
                   ^~~~~~~~~
In file included from include/AsyncJpegStream.h:2,
                 from include/webserver.h:12,
                 from include/globals.h:80,
                 from include/servo.h:5,
                 from src/camera.cpp:1:
C:/Users/rzieb/.platformio/packages/framework-arduinoespressif32/tools/sdk/esp32/include/esp32-camera/driver/include/esp_camera.h:121:87: note: declared here
         int pin_sscb_scl __attribute__((deprecated("please use pin_sccb_scl instead")));           /*!< GPIO pin for camera SCL line (legacy name) */
                                                                                       ^
src/camera.cpp:22:19: warning: 'camera_config_t::<unnamed union>::pin_sscb_scl' is deprecated: please use pin_sccb_scl instead [-Wdeprecated-declarations]
     camera_config.pin_sscb_scl = SIOC_GPIO_NUM;
                   ^~~~~~~~~~~~
In file included from include/AsyncJpegStream.h:2,
                 from include/webserver.h:12,
                 from include/globals.h:80,
                 from include/servo.h:5,
                 from src/camera.cpp:1:
C:/Users/rzieb/.platformio/packages/framework-arduinoespressif32/tools/sdk/esp32/include/esp32-camera/driver/include/esp_camera.h:121:87: note: declared here
         int pin_sscb_scl __attribute__((deprecated("please use pin_sccb_scl instead")));           /*!< GPIO pin for camera SCL line (legacy name) */
                                                                                       ^
src/camera.cpp:22:34: error: 'SIOC_GPIO_NUM' was not declared in this scope
     camera_config.pin_sscb_scl = SIOC_GPIO_NUM;
                                  ^~~~~~~~~~~~~
include/webserver.h:133:56: note: suggested alternative: 'ESTALE'
         DefaultHeaders::Instance().addHeader("Server", HOSTNAME);
                                                        ^~~~~~~~
                                                        ESTALE
In file included from include/servo.h:6,
                 from include/globals.h:72,
                 from src/jsonserializer.cpp:1:
include/webserver.h: In constructor 'CWebServer::CWebServer()':
include/webserver.h:123:19: error: 'HTTP_PORT' was not declared in this scope
         : _server(HTTP_PORT)
                   ^~~~~~~~~
include/webserver.h:123:19: note: suggested alternative: 'HTTP_POST'
         : _server(HTTP_PORT)
                   ^~~~~~~~~
                   HTTP_POST
include/webserver.h:125:15: error: 'WEBSOCKET_PATH' was not declared in this scope
         , _ws(WEBSOCKET_PATH)
               ^~~~~~~~~~~~~~
include/webserver.h:123:19: note: suggested alternative: 'HTTP_POST'
         : _server(HTTP_PORT)
                   ^~~~~~~~~
                   HTTP_POST
include/webserver.h:125:15: error: 'WEBSOCKET_PATH' was not declared in this scope
         , _ws(WEBSOCKET_PATH)
               ^~~~~~~~~~~~~~
src/camera.cpp:22:34: note: suggested alternative: 'SPI_D_GPIO_NUM'
     camera_config.pin_sscb_scl = SIOC_GPIO_NUM;
                                  ^~~~~~~~~~~~~
                                  SPI_D_GPIO_NUM
src/camera.cpp:23:30: error: 'PWDN_GPIO_NUM' was not declared in this scope
     camera_config.pin_pwdn = PWDN_GPIO_NUM;
                              ^~~~~~~~~~~~~
src/camera.cpp:23:30: note: suggested alternative: 'SPI_D_GPIO_NUM'
     camera_config.pin_pwdn = PWDN_GPIO_NUM;
                              ^~~~~~~~~~~~~
                              SPI_D_GPIO_NUM
src/camera.cpp:24:31: error: 'RESET_GPIO_NUM' was not declared in this scope
     camera_config.pin_reset = RESET_GPIO_NUM;
                               ^~~~~~~~~~~~~~
In file included from include/globals.h:80,
                 from include/servo.h:5,
                 from src/servo.cpp:1:
include/webserver.h: In constructor 'CWebServer::CWebServer()':
include/webserver.h:123:19: error: 'HTTP_PORT' was not declared in this scope
         : _server(HTTP_PORT)
                   ^~~~~~~~~
include/webserver.h:125:15: note: suggested alternative: 'LWIP_SOCKET_POLL'
         , _ws(WEBSOCKET_PATH)
               ^~~~~~~~~~~~~~
               LWIP_SOCKET_POLL
include/webserver.h:125:15: note: suggested alternative: 'LWIP_SOCKET_POLL'
         , _ws(WEBSOCKET_PATH)
               ^~~~~~~~~~~~~~
               LWIP_SOCKET_POLL
include/webserver.h: In member function 'void CWebServer::begin()':
include/webserver.h:133:56: error: 'HOSTNAME' was not declared in this scope
         DefaultHeaders::Instance().addHeader("Server", HOSTNAME);
                                                        ^~~~~~~~
include/webserver.h: In member function 'void CWebServer::begin()':
include/webserver.h:133:56: error: 'HOSTNAME' was not declared in this scope
         DefaultHeaders::Instance().addHeader("Server", HOSTNAME);
                                                        ^~~~~~~~
include/webserver.h:123:19: note: suggested alternative: 'HTTP_POST'
         : _server(HTTP_PORT)
                   ^~~~~~~~~
                   HTTP_POST
include/webserver.h:125:15: error: 'WEBSOCKET_PATH' was not declared in this scope
         , _ws(WEBSOCKET_PATH)
               ^~~~~~~~~~~~~~
include/webserver.h:133:56: note: suggested alternative: 'ESTALE'
         DefaultHeaders::Instance().addHeader("Server", HOSTNAME);
                                                        ^~~~~~~~
                                                        ESTALE
include/webserver.h:133:56: note: suggested alternative: 'ESTALE'
         DefaultHeaders::Instance().addHeader("Server", HOSTNAME);
                                                        ^~~~~~~~
                                                        ESTALE
src/camera.cpp:24:31: note: suggested alternative: 'SPI_D_GPIO_NUM'
     camera_config.pin_reset = RESET_GPIO_NUM;
                               ^~~~~~~~~~~~~~
                               SPI_D_GPIO_NUM
src/network.cpp: In function 'bool ConnectToWiFi(uint)':
src/network.cpp:18:22: error: 'HOSTNAME' was not declared in this scope
     WiFi.setHostname(HOSTNAME);
                      ^~~~~~~~
include/webserver.h:125:15: note: suggested alternative: 'LWIP_SOCKET_POLL'
         , _ws(WEBSOCKET_PATH)
               ^~~~~~~~~~~~~~
               LWIP_SOCKET_POLL
include/webserver.h: In member function 'void CWebServer::begin()':
include/webserver.h:133:56: error: 'HOSTNAME' was not declared in this scope
         DefaultHeaders::Instance().addHeader("Server", HOSTNAME);
                                                        ^~~~~~~~
src/network.cpp:18:22: note: suggested alternative: 'ESTALE'
     WiFi.setHostname(HOSTNAME);
                      ^~~~~~~~
                      ESTALE
src/network.cpp:61:40: error: 'HTTP_PORT' was not declared in this scope
         MDNS.addService("http", "tcp", HTTP_PORT);
                                        ^~~~~~~~~
src/network.cpp:61:40: note: suggested alternative: 'HTTP_POST'
         MDNS.addService("http", "tcp", HTTP_PORT);
                                        ^~~~~~~~~
                                        HTTP_POST
include/webserver.h:133:56: note: suggested alternative: 'ESTALE'
         DefaultHeaders::Instance().addHeader("Server", HOSTNAME);
                                                        ^~~~~~~~
                                                        ESTALE
In file included from include/servo.h:6,
                 from include/globals.h:72,
                 from src/webserver.cpp:1:
include/webserver.h: In constructor 'CWebServer::CWebServer()':
include/webserver.h:123:19: error: 'HTTP_PORT' was not declared in this scope
         : _server(HTTP_PORT)
                   ^~~~~~~~~
include/webserver.h:123:19: note: suggested alternative: 'HTTP_POST'
         : _server(HTTP_PORT)
                   ^~~~~~~~~
                   HTTP_POST
include/webserver.h:125:15: error: 'WEBSOCKET_PATH' was not declared in this scope
         , _ws(WEBSOCKET_PATH)
               ^~~~~~~~~~~~~~
include/webserver.h:125:15: note: suggested alternative: 'LWIP_SOCKET_POLL'
         , _ws(WEBSOCKET_PATH)
               ^~~~~~~~~~~~~~
               LWIP_SOCKET_POLL
include/webserver.h: In member function 'void CWebServer::begin()':
include/webserver.h:133:56: error: 'HOSTNAME' was not declared in this scope
         DefaultHeaders::Instance().addHeader("Server", HOSTNAME);
                                                        ^~~~~~~~
include/webserver.h:133:56: note: suggested alternative: 'ESTALE'
         DefaultHeaders::Instance().addHeader("Server", HOSTNAME);
                                                        ^~~~~~~~
                                                        ESTALE
*** [.pio\build\esp32cam\src\camera.cpp.o] Error 1
*** [.pio\build\esp32cam\src\deviceconfig.cpp.o] Error 1
*** [.pio\build\esp32cam\src\network.cpp.o] Error 1
*** [.pio\build\esp32cam\src\main.cpp.o] Error 1
*** [.pio\build\esp32cam\src\servo.cpp.o] Error 1
*** [.pio\build\esp32cam\src\jsonserializer.cpp.o] Error 1
*** [.pio\build\esp32cam\src\webserver.cpp.o] Error 1
============================================== [FAILED] Took 7.41 seconds ==============================================

runeharlyk, 2023-08-14:
Hi! Thank you for showing interest in my project.
It seems I forgot to add the example configuration and section in the readme about what to do with it.
I have added both now. To build the project for the first time you have to:
1. Make a copy of *`include/secrets.example.h`* in the same folder
1. Rename the copy to *`secrets.h`*
1. Configure relevant settings

Let me know if you get it to work

robo78, 2023-08-15:
Duplicate data is in config.h and secrets.h. The tile is not visible on the network despite these settings.

runeharlyk, 2023-08-15:
I have remove the duplicated defines 😁
What system are you using? And Is it the device that cant connect to the network or do you mean you cannot see it using the mDNS address?

robo78, 2023-08-15:
npm run dev uruchmia page on localhost but esp32cam does not fire anything and I do not see the connection.I see the IP of the device but I do not know how to connect and on what port, serial monitor does not display any information

robo78, 2023-08-16:
The board was broken, now it works, testing

Closed 2023-09-02.

Thread 2 (2023-08-26):

modules connections

robo78, 2023-08-26:
There are modules in the code:
SSD1306,
ADS1X15,
HMC5883 , MPU6050,
but I can't find my configuration and pin connections, unless the code is incomplete

runeharlyk, 2023-08-27:
The modules you referenced all use I2C for communication. The I2C pins are defined in `include/deviceconfig.h`.
I can section in the readme for connection with a diagram

Closed 2024-03-17.

Thread 12 (2024-02-05):

Captive portal fallback

runeharlyk, 2024-02-05:
# Problem
When the robot can't find or connect to the save wifi, the robot can't be controlled

# Solution
When the robot can't find or connect to wifi, it will start AP and host a captive portal where wifi credentials can be updated. The captive portal can work a fully functional controller interface.

runeharlyk, 2024-04-23:
This will be included when updating to use ESP32SvelteKit template

Closed 2024-04-23.

Thread 13 (2024-02-05):

Stop button

runeharlyk, 2024-02-05:
If the robot is trying to get in an unobtainable position the actuators can be damaged or even burn out.

I want a stop function that disables all servos.

This function should accessible through the API, via websocket and the physical power button. The function should also be called if the power draw limit is exceeded.

The code running the disable function should have the highest priority.

Closed 2024-08-03.

Thread 9 (2024-02-05):

Servo calibration tool

runeharlyk, 2024-02-05:
It can be a very complicated process to assemble and calibrate the robot.
It would be nice to have a tool that can help calibrate the servos to ensure the correct positions of each actuator

I want to be able to control each servo in realtime. I want to control:
* Resolution
* Frequency
* Lower PWN limit
* Upper PWM limit
* Whether a servo is enabled
* Whether a servos direction is inverted

Further i want to find the actual PWN to degree ratio, which make the real robot movement more precise

runeharlyk, 2024-02-05:
I want to be able to control each servo in realtime. I want to control:
* Resolution
* Frequency
* Lower PWN limit
* Upper PWM limit
* Whether a servo is enabled
* Whether a servos direction is inverted

Further i want to find the actual PWN to degree ratio, which make the real robot movement more precise

Closed 2024-09-12.

Thread 24 (2024-02-29):

Camera feed simulation

runeharlyk, 2024-02-29:
When simulation the robot i would like the full experience including see a camera feed.

The camera should be fixed on the robot model if the feature is enabled by the server

runeharlyk, 2024-06-10:
This issue is almost impossible in the current preposed simulation setting as python global interpreter lock makes running the simulation and streaming camera feed to resource intensive. Therefor this issues will be closes for now, and maybe reopened again in the future

Closed 2024-06-10.

Thread 25 (2024-02-29):

Simulation vs visualization

runeharlyk, 2024-02-29:
The app should differentiate between simulation and visualization of the robot.

The user should be able to choose if the robot should be simulated of be a mirror of reality.

For simulation, input should be user generated to test how the robot react.
This includes:
- Camera live feed
- Ultra sonic sensor
- Battery voltage and current draw
- IMU data (Range slider to start, migrate to cannonJS ridged body simulation)

runeharlyk, 2024-07-18:
The app should be purely visualization, as it main function is being a controller. Simulation should be done in an dedicated project/app.

Closed 2024-07-18.

Thread 34 (2024-03-18):

Split robot firmware

runeharlyk, 2024-03-18:
It could be beneficial to split the robot firmware into an interface/planner and a controller. This would give the user a choice for selecting hardware for budgeting etc.

The interface controller could be an esp32(cam), raspberry pi or jetson nano. It purpose would be taking input and planning trajectories.

The controller could be an esp32, teensy 4.0, stm32 or other. The main purpose would be collection sensor data (uss, button, imu, adc etc), calculate inverse kinematics and updating hardware (servos, led, oled)

Ian-cmd-ops, 2024-06-03:
Interesting to see which way you go.

Thread 35 (2024-04-08):

Switch from JSON and uint8 buffers to msgpack

runeharlyk, 2024-04-08:
JSONs overhead is to big for high throughput communication and uint8 buffer are hard to maintain

runeharlyk, 2024-04-17:
JSONs overhead is to big for high throughput communication and uint8 buffer are hard to maintain

runeharlyk, 2024-06-18:
With the new event protocol #57 alot of the overhead has been mitigated. For this reason this issue will be closed, but with the possible of reopening in the future

Closed 2024-06-18.

Thread 36 (2024-04-22):

Issue building with PIO

Ian-cmd-ops, 2024-04-22:
|-- Adafruit SSD1306 @ 2.5.9
|-- Adafruit GFX Library @ 1.11.9
|-- Adafruit BusIO @ 1.16.0
|-- Adafruit PWM Servo Driver Library @ 2.4.1
|-- Adafruit ADS1X15 @ 2.5.0
|-- Adafruit HMC5883 Unified @ 1.2.3
|-- Adafruit Unified Sensor @ 1.1.14
|-- UrlEncode @ 1.0.1
|-- MPU6050_light @ 1.1.0
|-- SPI @ 2.0.0
|-- HTTPClient @ 2.0.0
|-- SPIFFS @ 2.0.0
|-- ArduinoOTA @ 2.0.0
|-- DNSServer @ 2.0.0
|-- ESPmDNS @ 2.0.0
|-- WiFi @ 2.0.0
|-- Wire @ 2.0.0
|-- Update @ 2.0.0
Building in release mode
Compiling .pio\build\esp32cam\src\AsyncJpegStream.cpp.o
Compiling .pio\build\esp32cam\src\camera.cpp.o
Compiling .pio\build\esp32cam\src\deviceconfig.cpp.o
Compiling .pio\build\esp32cam\src\jsonserializer.cpp.o
Compiling .pio\build\esp32cam\src\main.cpp.o
Compiling .pio\build\esp32cam\src\movement.cpp.o
Compiling .pio\build\esp32cam\src\network.cpp.o
Compiling .pio\build\esp32cam\src\servo.cpp.o
Compiling .pio\build\esp32cam\src\webserver.cpp.o
Building .pio\build\esp32cam\bootloader.bin
Generating partitions .pio\build\esp32cam\partitions.bin
esptool.py v4.5.1
Creating esp32 image...
Merged 1 ELF section
Successfully created esp32 image.
Compiling .pio\build\esp32cam\lib81e\AsyncTCP\AsyncTCP.cpp.o
In file included from c:\users\rip_h\.platformio\packages\toolchain-xtensa-esp32@8.4.0+2021r2-patch5\xtensa-esp32-elf\include\sys\reent.h:503,
                 from C:/Users/rip_h/.platformio/packages/framework-arduinoespressif32/tools/sdk/esp32/include/newlib/platform_include/sys/reent.h:17,
                 from c:\users\rip_h\.platformio\packages\toolchain-xtensa-esp32@8.4.0+2021r2-patch5\xtensa-esp32-elf\include\stdio.h:60,
                 from C:/Users/rip_h/.platformio/packages/framework-arduinoespressif32/cores/esp32/Arduino.h:27,
                 from .pio/libdeps/esp32cam/ESP Async WebServer/src/ESPAsyncWebServer.h:24,
                 from include/AsyncJpegStream.h:1,
                 from src/AsyncJpegStream.cpp:1:
C:/Users/rip_h/.platformio/packages/framework-arduinoespressif32/tools/sdk/esp32/include/esp_hw_support/include/soc/spinlock.h: In function 'void spinlock_initialize(spinlock_t*)':
C:/Users/rip_h/.platformio/packages/framework-arduinoespressif32/tools/sdk/esp32/include/esp_hw_support/include/soc/spinlock.h:46:5: error: '__assert_func' was not declared in this scope
     assert(lock);
     ^~~~~~
C:/Users/rip_h/.platformio/packages/framework-arduinoespressif32/tools/sdk/esp32/include/esp_hw_support/include/soc/spinlock.h: In function 'bool spinlock_acquire(spinlock_t*, int32_t)':
C:/Users/rip_h/.platformio/packages/framework-arduinoespressif32/tools/sdk/esp32/include/esp_hw_support/include/soc/spinlock.h:75:5: error: '__assert_func' was not declared in this scope
     assert(lock);
     ^~~~~~
C:/Users/rip_h/.platformio/packages/framework-arduinoespressif32/tools/sdk/esp32/include/esp_hw_support/include/soc/spinlock.h: In function 'void spinlock_release(spinlock_t*)':
C:/Users/rip_h/.platformio/packages/framework-arduinoespressif32/tools/sdk/esp32/include/esp_hw_support/include/soc/spinlock.h:154:5: error: '__assert_func' was not declared in this scope
     assert(lock);
     ^~~~~~
Compiling .pio\build\esp32cam\libc46\FS\FS.cpp.o
Compiling .pio\build\esp32cam\libc46\FS\vfs_api.cpp.o
*** [.pio\build\esp32cam\src\AsyncJpegStream.cpp.o] Error 1
In file included from c:\users\rip_h\.platformio\packages\toolchain-xtensa-esp32@8.4.0+2021r2-patch5\xtensa-esp32-elf\include\sys\reent.h:503,
                 from C:/Users/rip_h/.platformio/packages/framework-arduinoespressif32/tools/sdk/esp32/include/newlib/platform_include/sys/reent.h:17,
                 from c:\users\rip_h\.platformio\packages\toolchain-xtensa-esp32@8.4.0+2021r2-patch5\xtensa-esp32-elf\include\stdio.h:60,
                 from C:/Users/rip_h/.platformio/packages/framework-arduinoespressif32/cores/esp32/Arduino.h:27,
                 from .pio/libdeps/esp32cam/MPU6050_light/src/MPU6050_light.h:16,
                 from src/movement.cpp:3:
C:/Users/rip_h/.platformio/packages/framework-arduinoespressif32/tools/sdk/esp32/include/esp_hw_support/include/soc/spinlock.h: In function 'void spinlock_initialize(spinlock_t*)':
C:/Users/rip_h/.platformio/packages/framework-arduinoespressif32/tools/sdk/esp32/include/esp_hw_support/include/soc/spinlock.h:46:5: error: '__assert_func' was not declared in this scope
     assert(lock);
     ^~~~~~
C:/Users/rip_h/.platformio/packages/framework-arduinoespressif32/tools/sdk/esp32/include/esp_hw_support/include/soc/spinlock.h: In function 'bool spinlock_acquire(spinlock_t*, int32_t)':
C:/Users/rip_h/.platformio/packages/framework-arduinoespressif32/tools/sdk/esp32/include/esp_hw_support/include/soc/spinlock.h:75:5: error: '__assert_func' was not declared in this scope
     assert(lock);
     ^~~~~~
C:/Users/rip_h/.platformio/packages/framework-arduinoespressif32/tools/sdk/esp32/include/esp_hw_support/include/soc/spinlock.h: In function 'void spinlock_release(spinlock_t*)':
C:/Users/rip_h/.platformio/packages/framework-arduinoespressif32/tools/sdk/esp32/include/esp_hw_support/include/soc/spinlock.h:154:5: error: '__assert_func' was not declared in this scope
     assert(lock);
     ^~~~~~
In file included from c:\users\rip_h\.platformio\packages\toolchain-xtensa-esp32@8.4.0+2021r2-patch5\xtensa-esp32-elf\include\sys\reent.h:503,
                 from C:/Users/rip_h/.platformio/packages/framework-arduinoespressif32/tools/sdk/esp32/include/newlib/platform_include/sys/reent.h:17,
                 from c:\users\rip_h\.platformio\packages\toolchain-xtensa-esp32@8.4.0+2021r2-patch5\xtensa-esp32-elf\include\stdio.h:60,
                 from C:/Users/rip_h/.platformio/packages/framework-arduinoespressif32/cores/esp32/Arduino.h:27,
                 from .pio/libdeps/esp32cam/AsyncTCP/src/AsyncTCP.cpp:22:
C:/Users/rip_h/.platformio/packages/framework-arduinoespressif32/tools/sdk/esp32/include/esp_hw_support/include/soc/spinlock.h: In function 'void spinlock_initialize(spinlock_t*)':
C:/Users/rip_h/.platformio/packages/framework-arduinoespressif32/tools/sdk/esp32/include/esp_hw_support/include/soc/spinlock.h:46:5: error: '__assert_func' was not declared in this scope
     assert(lock);
     ^~~~~~
C:/Users/rip_h/.platformio/packages/framework-arduinoespressif32/tools/sdk/esp32/include/esp_hw_support/include/soc/spinlock.h: In function 'bool spinlock_acquire(spinlock_t*, int32_t)':
C:/Users/rip_h/.platformio/packages/framework-arduinoespressif32/tools/sdk/esp32/include/esp_hw_support/include/soc/spinlock.h:75:5: error: '__assert_func' was not declared in this scope
     assert(lock);
     ^~~~~~
C:/Users/rip_h/.platformio/packages/framework-arduinoespressif32/tools/sdk/esp32/include/esp_hw_support/include/soc/spinlock.h: In function 'void spinlock_release(spinlock_t*)':
C:/Users/rip_h/.platformio/packages/framework-arduinoespressif32/tools/sdk/esp32/include/esp_hw_support/include/soc/spinlock.h:154:5: error: '__assert_func' was not declared in this scope
     assert(lock);
     ^~~~~~
*** [.pio\build\esp32cam\src\movement.cpp.o] Error 1
In file included from c:\users\rip_h\.platformio\packages\toolchain-xtensa-esp32@8.4.0+2021r2-patch5\xtensa-esp32-elf\include\sys\reent.h:503,
                 from C:/Users/rip_h/.platformio/packages/framework-arduinoespressif32/tools/sdk/esp32/include/newlib/platform_include/sys/reent.h:17,
                 from c:\users\rip_h\.platformio\packages\toolchain-xtensa-esp32@8.4.0+2021r2-patch5\xtensa-esp32-elf\include\wchar.h:6,
                 from c:\users\rip_h\.platformio\packages\toolchain-xtensa-esp32@8.4.0+2021r2-patch5\xtensa-esp32-elf\include\c++\8.4.0\cwchar:44,
                 from c:\users\rip_h\.platformio\packages\toolchain-xtensa-esp32@8.4.0+2021r2-patch5\xtensa-esp32-elf\include\c++\8.4.0\bits\postypes.h:40,
                 from c:\users\rip_h\.platformio\packages\toolchain-xtensa-esp32@8.4.0+2021r2-patch5\xtensa-esp32-elf\include\c++\8.4.0\iosfwd:40,
                 from c:\users\rip_h\.platformio\packages\toolchain-xtensa-esp32@8.4.0+2021r2-patch5\xtensa-esp32-elf\include\c++\8.4.0\memory:72,
                 from C:/Users/rip_h/.platformio/packages/framework-arduinoespressif32/libraries/HTTPClient/src/HTTPClient.h:34,
                 from src/deviceconfig.cpp:1:
C:/Users/rip_h/.platformio/packages/framework-arduinoespressif32/tools/sdk/esp32/include/esp_hw_support/include/soc/spinlock.h: In function 'void spinlock_initialize(spinlock_t*)':
C:/Users/rip_h/.platformio/packages/framework-arduinoespressif32/tools/sdk/esp32/include/esp_hw_support/include/soc/spinlock.h:46:5: error: '__assert_func' was not declared in this scope
     assert(lock);
     ^~~~~~
C:/Users/rip_h/.platformio/packages/framework-arduinoespressif32/tools/sdk/esp32/include/esp_hw_support/include/soc/spinlock.h: In function 'bool spinlock_acquire(spinlock_t*, int32_t)':
C:/Users/rip_h/.platformio/packages/framework-arduinoespressif32/tools/sdk/esp32/include/esp_hw_support/include/soc/spinlock.h:75:5: error: '__assert_func' was not declared in this scope
     assert(lock);
     ^~~~~~
C:/Users/rip_h/.platformio/packages/framework-arduinoespressif32/tools/sdk/esp32/include/esp_hw_support/include/soc/spinlock.h: In function 'void spinlock_release(spinlock_t*)':
C:/Users/rip_h/.platformio/packages/framework-arduinoespressif32/tools/sdk/esp32/include/esp_hw_support/include/soc/spinlock.h:154:5: error: '__assert_func' was not declared in this scope
     assert(lock);
     ^~~~~~
In file included from c:\users\rip_h\.platformio\packages\toolchain-xtensa-esp32@8.4.0+2021r2-patch5\xtensa-esp32-elf\include\sys\reent.h:503,
                 from C:/Users/rip_h/.platformio/packages/framework-arduinoespressif32/tools/sdk/esp32/include/newlib/platform_include/sys/reent.h:17,
                 from c:\users\rip_h\.platformio\packages\toolchain-xtensa-esp32@8.4.0+2021r2-patch5\xtensa-esp32-elf\include\wchar.h:6,
                 from c:\users\rip_h\.platformio\packages\toolchain-xtensa-esp32@8.4.0+2021r2-patch5\xtensa-esp32-elf\include\c++\8.4.0\cwchar:44,
                 from c:\users\rip_h\.platformio\packages\toolchain-xtensa-esp32@8.4.0+2021r2-patch5\xtensa-esp32-elf\include\c++\8.4.0\bits\postypes.h:40,
                 from c:\users\rip_h\.platformio\packages\toolchain-xtensa-esp32@8.4.0+2021r2-patch5\xtensa-esp32-elf\include\c++\8.4.0\iosfwd:40,
                 from c:\users\rip_h\.platformio\packages\toolchain-xtensa-esp32@8.4.0+2021r2-patch5\xtensa-esp32-elf\include\c++\8.4.0\memory:72,
                 from include/servo.h:3,
                 from src/camera.cpp:1:
C:/Users/rip_h/.platformio/packages/framework-arduinoespressif32/tools/sdk/esp32/include/esp_hw_support/include/soc/spinlock.h: In function 'void spinlock_initialize(spinlock_t*)':
C:/Users/rip_h/.platformio/packages/framework-arduinoespressif32/tools/sdk/esp32/include/esp_hw_support/include/soc/spinlock.h:46:5: error: '__assert_func' was not declared in this scope
     assert(lock);
     ^~~~~~
C:/Users/rip_h/.platformio/packages/framework-arduinoespressif32/tools/sdk/esp32/include/esp_hw_support/include/soc/spinlock.h: In function 'bool spinlock_acquire(spinlock_t*, int32_t)':
C:/Users/rip_h/.platformio/packages/framework-arduinoespressif32/tools/sdk/esp32/include/esp_hw_support/include/soc/spinlock.h:75:5: error: '__assert_func' was not declared in this scope
     assert(lock);
     ^~~~~~
C:/Users/rip_h/.platformio/packages/framework-arduinoespressif32/tools/sdk/esp32/include/esp_hw_support/include/soc/spinlock.h: In function 'void spinlock_release(spinlock_t*)':
C:/Users/rip_h/.platformio/packages/framework-arduinoespressif32/tools/sdk/esp32/include/esp_hw_support/include/soc/spinlock.h:154:5: error: '__assert_func' was not declared in this scope
     assert(lock);
     ^~~~~~
In file included from c:\users\rip_h\.platformio\packages\toolchain-xtensa-esp32@8.4.0+2021r2-patch5\xtensa-esp32-elf\include\sys\reent.h:503,
                 from C:/Users/rip_h/.platformio/packages/framework-arduinoespressif32/tools/sdk/esp32/include/newlib/platform_include/sys/reent.h:17,
                 from c:\users\rip_h\.platformio\packages\toolchain-xtensa-esp32@8.4.0+2021r2-patch5\xtensa-esp32-elf\include\wchar.h:6,
                 from c:\users\rip_h\.platformio\packages\toolchain-xtensa-esp32@8.4.0+2021r2-patch5\xtensa-esp32-elf\include\c++\8.4.0\cwchar:44,
                 from c:\users\rip_h\.platformio\packages\toolchain-xtensa-esp32@8.4.0+2021r2-patch5\xtensa-esp32-elf\include\c++\8.4.0\bits\postypes.h:40,
                 from c:\users\rip_h\.platformio\packages\toolchain-xtensa-esp32@8.4.0+2021r2-patch5\xtensa-esp32-elf\include\c++\8.4.0\iosfwd:40,
                 from c:\users\rip_h\.platformio\packages\toolchain-xtensa-esp32@8.4.0+2021r2-patch5\xtensa-esp32-elf\include\c++\8.4.0\memory:72,
                 from C:/Users/rip_h/.platformio/packages/framework-arduinoespressif32/libraries/FS/src/FS.h:24,
                 from C:/Users/rip_h/.platformio/packages/framework-arduinoespressif32/libraries/SPIFFS/src/SPIFFS.h:17,
                 from include/globals.h:3,
                 from src/jsonserializer.cpp:1:
C:/Users/rip_h/.platformio/packages/framework-arduinoespressif32/tools/sdk/esp32/include/esp_hw_support/include/soc/spinlock.h: In function 'void spinlock_initialize(spinlock_t*)':
C:/Users/rip_h/.platformio/packages/framework-arduinoespressif32/tools/sdk/esp32/include/esp_hw_support/include/soc/spinlock.h:46:5: error: '__assert_func' was not declared in this scope
     assert(lock);
     ^~~~~~
C:/Users/rip_h/.platformio/packages/framework-arduinoespressif32/tools/sdk/esp32/include/esp_hw_support/include/soc/spinlock.h: In function 'bool spinlock_acquire(spinlock_t*, int32_t)':
C:/Users/rip_h/.platformio/packages/framework-arduinoespressif32/tools/sdk/esp32/include/esp_hw_support/include/soc/spinlock.h:75:5: error: '__assert_func' was not declared in this scope
     assert(lock);
     ^~~~~~
C:/Users/rip_h/.platformio/packages/framework-arduinoespressif32/tools/sdk/esp32/include/esp_hw_support/include/soc/spinlock.h: In function 'void spinlock_release(spinlock_t*)':
C:/Users/rip_h/.platformio/packages/framework-arduinoespressif32/tools/sdk/esp32/include/esp_hw_support/include/soc/spinlock.h:154:5: error: '__assert_func' was not declared in this scope
     assert(lock);
     ^~~~~~
In file included from c:\users\rip_h\.platformio\packages\toolchain-xtensa-esp32@8.4.0+2021r2-patch5\xtensa-esp32-elf\include\sys\reent.h:503,
                 from C:/Users/rip_h/.platformio/packages/framework-arduinoespressif32/tools/sdk/esp32/include/newlib/platform_include/sys/reent.h:17,
                 from c:\users\rip_h\.platformio\packages\toolchain-xtensa-esp32@8.4.0+2021r2-patch5\xtensa-esp32-elf\include\wchar.h:6,
                 from c:\users\rip_h\.platformio\packages\toolchain-xtensa-esp32@8.4.0+2021r2-patch5\xtensa-esp32-elf\include\c++\8.4.0\cwchar:44,
                 from c:\users\rip_h\.platformio\packages\toolchain-xtensa-esp32@8.4.0+2021r2-patch5\xtensa-esp32-elf\include\c++\8.4.0\bits\postypes.h:40,
                 from c:\users\rip_h\.platformio\packages\toolchain-xtensa-esp32@8.4.0+2021r2-patch5\xtensa-esp32-elf\include\c++\8.4.0\iosfwd:40,
                 from c:\users\rip_h\.platformio\packages\toolchain-xtensa-esp32@8.4.0+2021r2-patch5\xtensa-esp32-elf\include\c++\8.4.0\memory:72,
                 from C:/Users/rip_h/.platformio/packages/framework-arduinoespressif32/libraries/FS/src/FS.h:24,
                 from C:/Users/rip_h/.platformio/packages/framework-arduinoespressif32/libraries/SPIFFS/src/SPIFFS.h:17,
                 from include/globals.h:3,
                 from src/main.cpp:1:
C:/Users/rip_h/.platformio/packages/framework-arduinoespressif32/tools/sdk/esp32/include/esp_hw_support/include/soc/spinlock.h: In function 'void spinlock_initialize(spinlock_t*)':
C:/Users/rip_h/.platformio/packages/framework-arduinoespressif32/tools/sdk/esp32/include/esp_hw_support/include/soc/spinlock.h:46:5: error: '__assert_func' was not declared in this scope
     assert(lock);
     ^~~~~~
C:/Users/rip_h/.platformio/packages/framework-arduinoespressif32/tools/sdk/esp32/include/esp_hw_support/include/soc/spinlock.h: In function 'bool spinlock_acquire(spinlock_t*, int32_t)':
C:/Users/rip_h/.platformio/packages/framework-arduinoespressif32/tools/sdk/esp32/include/esp_hw_support/include/soc/spinlock.h:75:5: error: '__assert_func' was not declared in this scope
     assert(lock);
     ^~~~~~
C:/Users/rip_h/.platformio/packages/framework-arduinoespressif32/tools/sdk/esp32/include/esp_hw_support/include/soc/spinlock.h: In function 'void spinlock_release(spinlock_t*)':
C:/Users/rip_h/.platformio/packages/framework-arduinoespressif32/tools/sdk/esp32/include/esp_hw_support/include/soc/spinlock.h:154:5: error: '__assert_func' was not declared in this scope
     assert(lock);
     ^~~~~~
In file included from c:\users\rip_h\.platformio\packages\toolchain-xtensa-esp32@8.4.0+2021r2-patch5\xtensa-esp32-elf\include\sys\reent.h:503,
                 from C:/Users/rip_h/.platformio/packages/framework-arduinoespressif32/tools/sdk/esp32/include/newlib/platform_include/sys/reent.h:17,
                 from c:\users\rip_h\.platformio\packages\toolchain-xtensa-esp32@8.4.0+2021r2-patch5\xtensa-esp32-elf\include\wchar.h:6,
                 from c:\users\rip_h\.platformio\packages\toolchain-xtensa-esp32@8.4.0+2021r2-patch5\xtensa-esp32-elf\include\c++\8.4.0\cwchar:44,
                 from c:\users\rip_h\.platformio\packages\toolchain-xtensa-esp32@8.4.0+2021r2-patch5\xtensa-esp32-elf\include\c++\8.4.0\bits\postypes.h:40,
                 from c:\users\rip_h\.platformio\packages\toolchain-xtensa-esp32@8.4.0+2021r2-patch5\xtensa-esp32-elf\include\c++\8.4.0\iosfwd:40,
                 from c:\users\rip_h\.platformio\packages\toolchain-xtensa-esp32@8.4.0+2021r2-patch5\xtensa-esp32-elf\include\c++\8.4.0\memory:72,
                 from C:/Users/rip_h/.platformio/packages/framework-arduinoespressif32/libraries/FS/src/FS.h:24,
                 from C:/Users/rip_h/.platformio/packages/framework-arduinoespressif32/libraries/SPIFFS/src/SPIFFS.h:17,
                 from include/globals.h:3,
                 from src/webserver.cpp:1:
C:/Users/rip_h/.platformio/packages/framework-arduinoespressif32/tools/sdk/esp32/include/esp_hw_support/include/soc/spinlock.h: In function 'void spinlock_initialize(spinlock_t*)':
C:/Users/rip_h/.platformio/packages/framework-arduinoespressif32/tools/sdk/esp32/include/esp_hw_support/include/soc/spinlock.h:46:5: error: '__assert_func' was not declared in this scope
     assert(lock);
     ^~~~~~
C:/Users/rip_h/.platformio/packages/framework-arduinoespressif32/tools/sdk/esp32/include/esp_hw_support/include/soc/spinlock.h: In function 'bool spinlock_acquire(spinlock_t*, int32_t)':
C:/Users/rip_h/.platformio/packages/framework-arduinoespressif32/tools/sdk/esp32/include/esp_hw_support/include/soc/spinlock.h:75:5: error: '__assert_func' was not declared in this scope
     assert(lock);
     ^~~~~~
In file included from c:\users\rip_h\.platformio\packages\toolchain-xtensa-esp32@8.4.0+2021r2-patch5\xtensa-esp32-elf\include\sys\reent.h:503,
                 from C:/Users/rip_h/.platformio/packages/framework-arduinoespressif32/tools/sdk/esp32/include/newlib/platform_include/sys/reent.h:17,
                 from c:\users\rip_h\.platformio\packages\toolchain-xtensa-esp32@8.4.0+2021r2-patch5\xtensa-esp32-elf\include\wchar.h:6,
                 from c:\users\rip_h\.platformio\packages\toolchain-xtensa-esp32@8.4.0+2021r2-patch5\xtensa-esp32-elf\include\c++\8.4.0\cwchar:44,
                 from c:\users\rip_h\.platformio\packages\toolchain-xtensa-esp32@8.4.0+2021r2-patch5\xtensa-esp32-elf\include\c++\8.4.0\bits\postypes.h:40,
                 from c:\users\rip_h\.platformio\packages\toolchain-xtensa-esp32@8.4.0+2021r2-patch5\xtensa-esp32-elf\include\c++\8.4.0\iosfwd:40,
                 from c:\users\rip_h\.platformio\packages\toolchain-xtensa-esp32@8.4.0+2021r2-patch5\xtensa-esp32-elf\include\c++\8.4.0\memory:72,
                 from C:/Users/rip_h/.platformio/packages/framework-arduinoespressif32/libraries/FS/src/FS.h:24,
                 from C:/Users/rip_h/.platformio/packages/framework-arduinoespressif32/libraries/SPIFFS/src/SPIFFS.h:17,
                 from include/globals.h:3,
                 from src/network.cpp:1:
C:/Users/rip_h/.platformio/packages/framework-arduinoespressif32/tools/sdk/esp32/include/esp_hw_support/include/soc/spinlock.h: In function 'void spinlock_initialize(spinlock_t*)':
C:/Users/rip_h/.platformio/packages/framework-arduinoespressif32/tools/sdk/esp32/include/esp_hw_support/include/soc/spinlock.h:46:5: error: '__assert_func' was not declared in this scope
     assert(lock);
     ^~~~~~
C:/Users/rip_h/.platformio/packages/framework-arduinoespressif32/tools/sdk/esp32/include/esp_hw_support/include/soc/spinlock.h: In function 'bool spinlock_acquire(spinlock_t*, int32_t)':
C:/Users/rip_h/.platformio/packages/framework-arduinoespressif32/tools/sdk/esp32/include/esp_hw_support/include/soc/spinlock.h:75:5: error: '__assert_func' was not declared in this scope
     assert(lock);
     ^~~~~~
C:/Users/rip_h/.platformio/packages/framework-arduinoespressif32/tools/sdk/esp32/include/esp_hw_support/include/soc/spinlock.h: In function 'void spinlock_release(spinlock_t*)':
C:/Users/rip_h/.platformio/packages/framework-arduinoespressif32/tools/sdk/esp32/include/esp_hw_support/include/soc/spinlock.h:154:5: error: '__assert_func' was not declared in this scope
     assert(lock);
     ^~~~~~
C:/Users/rip_h/.platformio/packages/framework-arduinoespressif32/tools/sdk/esp32/include/esp_hw_support/include/soc/spinlock.h: In function 'void spinlock_release(spinlock_t*)':
C:/Users/rip_h/.platformio/packages/framework-arduinoespressif32/tools/sdk/esp32/include/esp_hw_support/include/soc/spinlock.h:154:5: error: '__assert_func' was not declared in this scope
     assert(lock);
     ^~~~~~
In file included from c:\users\rip_h\.platformio\packages\toolchain-xtensa-esp32@8.4.0+2021r2-patch5\xtensa-esp32-elf\include\sys\reent.h:503,
                 from C:/Users/rip_h/.platformio/packages/framework-arduinoespressif32/tools/sdk/esp32/include/newlib/platform_include/sys/reent.h:17,
                 from c:\users\rip_h\.platformio\packages\toolchain-xtensa-esp32@8.4.0+2021r2-patch5\xtensa-esp32-elf\include\wchar.h:6,
                 from c:\users\rip_h\.platformio\packages\toolchain-xtensa-esp32@8.4.0+2021r2-patch5\xtensa-esp32-elf\include\c++\8.4.0\cwchar:44,
                 from c:\users\rip_h\.platformio\packages\toolchain-xtensa-esp32@8.4.0+2021r2-patch5\xtensa-esp32-elf\include\c++\8.4.0\bits\postypes.h:40,
                 from c:\users\rip_h\.platformio\packages\toolchain-xtensa-esp32@8.4.0+2021r2-patch5\xtensa-esp32-elf\include\c++\8.4.0\iosfwd:40,
                 from c:\users\rip_h\.platformio\packages\toolchain-xtensa-esp32@8.4.0+2021r2-patch5\xtensa-esp32-elf\include\c++\8.4.0\memory:72,
                 from C:/Users/rip_h/.platformio/packages/framework-arduinoespressif32/libraries/FS/src/FS.h:24,
                 from C:/Users/rip_h/.platformio/packages/framework-arduinoespressif32/libraries/FS/src/FS.cpp:21:
C:/Users/rip_h/.platformio/packages/framework-arduinoespressif32/tools/sdk/esp32/include/esp_hw_support/include/soc/spinlock.h: In function 'void spinlock_initialize(spinlock_t*)':
C:/Users/rip_h/.platformio/packages/framework-arduinoespressif32/tools/sdk/esp32/include/esp_hw_support/include/soc/spinlock.h:46:5: error: '__assert_func' was not declared in this scope
     assert(lock);
     ^~~~~~
C:/Users/rip_h/.platformio/packages/framework-arduinoespressif32/tools/sdk/esp32/include/esp_hw_support/include/soc/spinlock.h: In function 'bool spinlock_acquire(spinlock_t*, int32_t)':
C:/Users/rip_h/.platformio/packages/framework-arduinoespressif32/tools/sdk/esp32/include/esp_hw_support/include/soc/spinlock.h:75:5: error: '__assert_func' was not declared in this scope
     assert(lock);
     ^~~~~~
C:/Users/rip_h/.platformio/packages/framework-arduinoespressif32/tools/sdk/esp32/include/esp_hw_support/include/soc/spinlock.h: In function 'void spinlock_release(spinlock_t*)':
C:/Users/rip_h/.platformio/packages/framework-arduinoespressif32/tools/sdk/esp32/include/esp_hw_support/include/soc/spinlock.h:154:5: error: '__assert_func' was not declared in this scope
     assert(lock);
     ^~~~~~
*** [.pio\build\esp32cam\lib81e\AsyncTCP\AsyncTCP.cpp.o] Error 1
In file included from c:\users\rip_h\.platformio\packages\toolchain-xtensa-esp32@8.4.0+2021r2-patch5\xtensa-esp32-elf\include\sys\reent.h:503,
                 from C:/Users/rip_h/.platformio/packages/framework-arduinoespressif32/tools/sdk/esp32/include/newlib/platform_include/sys/reent.h:17,
                 from c:\users\rip_h\.platformio\packages\toolchain-xtensa-esp32@8.4.0+2021r2-patch5\xtensa-esp32-elf\include\wchar.h:6,
                 from c:\users\rip_h\.platformio\packages\toolchain-xtensa-esp32@8.4.0+2021r2-patch5\xtensa-esp32-elf\include\c++\8.4.0\cwchar:44,
                 from c:\users\rip_h\.platformio\packages\toolchain-xtensa-esp32@8.4.0+2021r2-patch5\xtensa-esp32-elf\include\c++\8.4.0\bits\postypes.h:40,
                 from c:\users\rip_h\.platformio\packages\toolchain-xtensa-esp32@8.4.0+2021r2-patch5\xtensa-esp32-elf\include\c++\8.4.0\iosfwd:40,
                 from c:\users\rip_h\.platformio\packages\toolchain-xtensa-esp32@8.4.0+2021r2-patch5\xtensa-esp32-elf\include\c++\8.4.0\memory:72,
                 from C:/Users/rip_h/.platformio/packages/framework-arduinoespressif32/libraries/FS/src/FS.h:24,
                 from C:/Users/rip_h/.platformio/packages/framework-arduinoespressif32/libraries/FS/src/vfs_api.h:18,
                 from C:/Users/rip_h/.platformio/packages/framework-arduinoespressif32/libraries/FS/src/vfs_api.cpp:15:
C:/Users/rip_h/.platformio/packages/framework-arduinoespressif32/tools/sdk/esp32/include/esp_hw_support/include/soc/spinlock.h: In function 'void spinlock_initialize(spinlock_t*)':
C:/Users/rip_h/.platformio/packages/framework-arduinoespressif32/tools/sdk/esp32/include/esp_hw_support/include/soc/spinlock.h:46:5: error: '__assert_func' was not declared in this scope
     assert(lock);
     ^~~~~~
C:/Users/rip_h/.platformio/packages/framework-arduinoespressif32/tools/sdk/esp32/include/esp_hw_support/include/soc/spinlock.h: In function 'bool spinlock_acquire(spinlock_t*, int32_t)':
C:/Users/rip_h/.platformio/packages/framework-arduinoespressif32/tools/sdk/esp32/include/esp_hw_support/include/soc/spinlock.h:75:5: error: '__assert_func' was not declared in this scope
     assert(lock);
     ^~~~~~
C:/Users/rip_h/.platformio/packages/framework-arduinoespressif32/tools/sdk/esp32/include/esp_hw_support/include/soc/spinlock.h: In function 'void spinlock_release(spinlock_t*)':
C:/Users/rip_h/.platformio/packages/framework-arduinoespressif32/tools/sdk/esp32/include/esp_hw_support/include/soc/spinlock.h:154:5: error: '__assert_func' was not declared in this scope
     assert(lock);
     ^~~~~~
In file included from c:\users\rip_h\.platformio\packages\toolchain-xtensa-esp32@8.4.0+2021r2-patch5\xtensa-esp32-elf\include\sys\reent.h:503,
                 from C:/Users/rip_h/.platformio/packages/framework-arduinoespressif32/tools/sdk/esp32/include/newlib/platform_include/sys/reent.h:17,
                 from c:\users\rip_h\.platformio\packages\toolchain-xtensa-esp32@8.4.0+2021r2-patch5\xtensa-esp32-elf\include\wchar.h:6,
                 from c:\users\rip_h\.platformio\packages\toolchain-xtensa-esp32@8.4.0+2021r2-patch5\xtensa-esp32-elf\include\c++\8.4.0\cwchar:44,
                 from c:\users\rip_h\.platformio\packages\toolchain-xtensa-esp32@8.4.0+2021r2-patch5\xtensa-esp32-elf\include\c++\8.4.0\bits\postypes.h:40,
                 from c:\users\rip_h\.platformio\packages\toolchain-xtensa-esp32@8.4.0+2021r2-patch5\xtensa-esp32-elf\include\c++\8.4.0\iosfwd:40,
                 from c:\users\rip_h\.platformio\packages\toolchain-xtensa-esp32@8.4.0+2021r2-patch5\xtensa-esp32-elf\include\c++\8.4.0\memory:72,
                 from include/servo.h:3,
                 from src/servo.cpp:1:
C:/Users/rip_h/.platformio/packages/framework-arduinoespressif32/tools/sdk/esp32/include/esp_hw_support/include/soc/spinlock.h: In function 'void spinlock_initialize(spinlock_t*)':
C:/Users/rip_h/.platformio/packages/framework-arduinoespressif32/tools/sdk/esp32/include/esp_hw_support/include/soc/spinlock.h:46:5: error: '__assert_func' was not declared in this scope
     assert(lock);
     ^~~~~~
C:/Users/rip_h/.platformio/packages/framework-arduinoespressif32/tools/sdk/esp32/include/esp_hw_support/include/soc/spinlock.h: In function 'bool spinlock_acquire(spinlock_t*, int32_t)':
C:/Users/rip_h/.platformio/packages/framework-arduinoespressif32/tools/sdk/esp32/include/esp_hw_support/include/soc/spinlock.h:75:5: error: '__assert_func' was not declared in this scope
     assert(lock);
     ^~~~~~
C:/Users/rip_h/.platformio/packages/framework-arduinoespressif32/tools/sdk/esp32/include/esp_hw_support/include/soc/spinlock.h: In function 'void spinlock_release(spinlock_t*)':
C:/Users/rip_h/.platformio/packages/framework-arduinoespressif32/tools/sdk/esp32/include/esp_hw_support/include/soc/spinlock.h:154:5: error: '__assert_func' was not declared in this scope
     assert(lock);
     ^~~~~~
*** [.pio\build\esp32cam\libc46\FS\FS.cpp.o] Error 1
*** [.pio\build\esp32cam\libc46\FS\vfs_api.cpp.o] Error 1
src/main.cpp: In function 'void setup()':
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

Thread 37 (2024-04-26):

ESP32 Cam not working

Ian-cmd-ops, 2024-04-26:
I can't get the my ESP32 cam to stream or view after I got my ESP32 Uploaded with via PIO.

Ian-cmd-ops, 2024-04-26:
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
do I need the other modules attached first before it runs

Ian-cmd-ops, 2024-04-26:
#define USE_PSRAM true

#define USE_WIFI true

#define WAIT_FOR_WIFI false

#define USE_WEBSERVER true

#define USE_WEBSERVER_SSL false

#define USE_WEBSOCKET true

#define USE_OAT false

#define USE_NTP false

#define USE_MDNS true

#define USE_DNS_SERVER false

#define USE_REMOTE_SERIAL false

#define USE_LOW_POWER false

#define USE_CAMERA true

#define USE_MPU true

#define USE_POWER_BUTTON true

#define USE_USS true

runeharlyk, 2024-04-30:
The camera stream should work out of the box. Is there anything in the browser console log?

Ian-cmd-ops, 2024-05-22:
Bad ESP32 Cam

Closed 2024-05-22.

Thread 42 (2024-05-22):

Documentation for New Built

Ian-cmd-ops, 2024-05-22:
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

Got this error while trying to built the latest update.

runeharlyk, 2024-05-22:
Thank for notifying me about the problem. I have added a pre build step to ensure the data folder exist. Let me know if it fixes the problem and if you experience other problems

Ian-cmd-ops, 2024-05-23:
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

Ian-cmd-ops, 2024-05-23:
Also can you update the documentation for this new version?

Ian-cmd-ops, 2024-05-23:
```

Processing esp32dev (board: esp32dev; platform: espressif32 @ 6.6.0; framework: arduino)
----------------------------------------------------------------------------------------------------------------------------------------------------
Verbose mode can be enabled via `-v, --verbose` option
running: build_app.py
Newest file: 2024-05-22 21:53:23.498062, output file: 2024-05-22 22:01:20.297650
SSL Cert Store: Certificate bundle downloaded to: ssl_certs\cacert.pem
SSL Cert Store: Parsing certificates from ssl_certs\cacert.pem
SSL Cert Store: Successfully added 48 certificates
SSL Cert Store: Successfully added 48 certificates in total
SSL Cert Store: Successfully created src\certs\x509_crt_bundle.bin
CONFIGURATION: https://docs.platformio.org/page/boards/espressif32/esp32dev.html
PLATFORM: Espressif 32 (6.6.0) > Espressif ESP32 Dev Module
HARDWARE: ESP32 240MHz, 320KB RAM, 4MB Flash
DEBUG: Current (cmsis-dap) External (cmsis-dap, esp-bridge, esp-prog, iot-bus-jtag, jlink, minimodule, olimex-arm-usb-ocd, olimex-arm-usb-ocd-h, olimex-arm-usb-tiny-h, olimex-jtag-tiny, tumpa)
PACKAGES:
 - framework-arduinoespressif32 @ 3.20014.231204 (2.0.14)
 - tool-esptoolpy @ 1.40501.0 (4.5.1)
 - tool-mklittlefs @ 1.203.210628 (2.3)
 - toolchain-xtensa-esp32 @ 8.4.0+2021r2-patch5
LDF: Library Dependency Finder -> https://bit.ly/configure-pio-ldf
LDF Modes: Finder ~ chain, Compatibility ~ strict
Found 46 compatible libraries
Scanning dependencies...
Dependency Graph
|-- ArduinoJson @ 7.0.4
|-- PsychicMqttClient @ 0.1.0+sha.1a26bd1
|-- NewPing @ 1.9.7
|-- Adafruit SSD1306 @ 2.5.10
|-- Adafruit GFX Library @ 1.11.9
|-- Adafruit BusIO @ 1.16.1
|-- MPU6050_light @ 1.1.0
|-- SPI @ 2.0.0
|-- ESP32-sveltekit
|-- PsychicHttp @ 1.0.1
Building in release mode
Building FS image from 'data' directory to .pio\build\esp32dev\littlefs.bin
/connections/mqtt.html
/connections/ntp.html
/connections.html
/controller/stream.html
/controller.html
/favicon.ico
/index.html
/logo512.png
/manifest.json
/peripherals/camera.html
/peripherals.html
/settings.html
/spot_micro.urdf.xacro
/stl.zip
/sw.js
/system/filesystem.html
/system/metrics.html
/system/status.html
/system/update.html
/system.html
/user.html
/wifi/ap.html
/wifi/sta.html
/wifi.html
/_app/env.js
/_app/immutable/assets/0.css
/_app/immutable/assets/20.css
/_app/immutable/assets/logo512.png
/_app/immutable/assets/_layout.css
/_app/immutable/assets/_page.css
/_app/immutable/chunks/24-hours.js
/_app/immutable/chunks/alert-triangle.js
/_app/immutable/chunks/analytics.js
/_app/immutable/chunks/api.js
/_app/immutable/chunks/buffer-utilities.js
/_app/immutable/chunks/camera-outline.js
/_app/immutable/chunks/Collapsible.js
/_app/immutable/chunks/compareVersions.js
/_app/immutable/chunks/ConfirmDialog.js
/_app/immutable/chunks/each.js
/_app/immutable/chunks/entry.js
/_app/immutable/chunks/file-service.js
/_app/immutable/chunks/folder-outline.js
/_app/immutable/chunks/home.js
/_app/immutable/chunks/index.js
/_app/immutable/chunks/index2.js
/_app/immutable/chunks/index3.js
/_app/immutable/chunks/InfoDialog.js
/_app/immutable/chunks/InputPassword.js
/_app/immutable/chunks/model-store.js
/_app/immutable/chunks/model-utilities.js
/_app/immutable/chunks/notifications.js
/_app/immutable/chunks/pencil.js
/_app/immutable/chunks/preload-helper.js
/_app/immutable/chunks/reload.js
/_app/immutable/chunks/result.js
/_app/immutable/chunks/RSSIIndicator.js
/_app/immutable/chunks/scheduler.js
/_app/immutable/chunks/SettingsCard.js
/_app/immutable/chunks/socket.js
/_app/immutable/chunks/Spinner.js
/_app/immutable/chunks/spread.js
/_app/immutable/chunks/stores.js
/_app/immutable/chunks/string-utilities.js
/_app/immutable/chunks/topology-star-3.js
/_app/immutable/chunks/Visualization.js
/_app/immutable/chunks/_commonjsHelpers.js
/_app/immutable/entry/app.js
/_app/immutable/entry/start.js
/_app/immutable/nodes/0.js
/_app/immutable/nodes/1.js
/_app/immutable/nodes/10.js
/_app/immutable/nodes/11.js
/_app/immutable/nodes/12.js
/_app/immutable/nodes/13.js
/_app/immutable/nodes/14.js
/_app/immutable/nodes/15.js
/_app/immutable/nodes/16.js
/_app/immutable/nodes/17.js
/_app/immutable/nodes/18.js
/_app/immutable/nodes/19.js
lfs warn:475: No more free space 520
lfs_write error(-28): File system is full.
/_app/version.json

error adding file!
Error for adding content from nodes!
=========================================================== [SUCCESS] Took 2.89 seconds ===========================================================

Environment    Status    Duration
-------------  --------  ------------
esp32dev       SUCCESS   00:00:02.887
=========================================================== 1 succeeded in 00:00:02.887 ===========================================================
 *  Terminal will be reused by tasks, press any key to close it.
```

made some progress but I keep getting this error

runeharlyk, 2024-05-23:
In the new version the data folder is supposed to be *empty and the app is embedded in the firmware to make OAT easier to manage.
Are you using the default build settings?

Ian-cmd-ops, 2024-05-23:
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
I just cleared the data folder. How do I compile it with Build or with Build Filesystem?

Ian-cmd-ops, 2024-05-25:
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

Ian-cmd-ops, 2024-05-25:
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

runeharlyk, 2024-05-25:
Found a problem with the build output and have merged the fix (#44).
You should now be able to upload the newest firmware with the built app

Ian-cmd-ops, 2024-05-25:
How long should it take to build the file?

Ian-cmd-ops, 2024-05-25:
Got the ESP32CAM broadcast the SSID
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

and I'm able to connect when connecting to 192.168.4.1,
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

I get this error.

Ian-cmd-ops, 2024-05-26:
I got it to work but only after using verbose Build and  verbose Upload

runeharlyk, 2024-05-26:
The camera settings and livestream is accessible from `/peripherals/camera`

Ian-cmd-ops, 2024-05-27:
I'll close this issue. But I need to open another one about assembly and pinouts for the esp32cam pinout

Closed 2024-05-27.

Thread 45 (2024-05-27):

Pin Out documentation

Ian-cmd-ops, 2024-05-27:
I'm looking for better documentation for pin out and better electronics schematics/layout for assembly. Might need an additional part for I2C bus expansion.

Ian-cmd-ops, 2024-05-28:
Also /peripherals/cams doesn't work and I can't connect to my local network. Only the AP works
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

runeharlyk, 2024-05-28:
I have added some [documentation](https://github.com/runeharlyk/SpotMicroESP32-Leika/tree/master/docs) as well as a [circuit digram](https://github.com/runeharlyk/SpotMicroESP32-Leika/blob/master/docs/2_assembly.md) on how to get started. Its still a bit rough, but should contain some useful information.

As for you problems, what does the serial monitor say? Does the esp32 try to connect? Have you added your wifi from `/wifi/sta`?

Ian-cmd-ops, 2024-05-29:
I got the wifi to work. My latest issue is that I get this.
Also Peripherals on the main page have a drop down.
I noticed that you don't have a calibration down or have a settings to PCA9685 for calibration the servos
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

Ian-cmd-ops, 2024-05-31:
> I have added some [documentation](https://github.com/runeharlyk/SpotMicroESP32-Leika/tree/master/docs) as well as a [circuit digram](https://github.com/runeharlyk/SpotMicroESP32-Leika/blob/master/docs/2_assembly.md) on how to get started. Its still a bit rough, but should contain some useful information.
>
> As for you problems, what does the serial monitor say? Does the esp32 try to connect? Have you added your wifi from `/wifi/sta`?

i added it and got it the SSID to connect.

Ian-cmd-ops, 2024-06-02:
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
Still having issues with the camera on this latest build. Using a ESP32 Cam.

Ian-cmd-ops, 2024-06-03:
Marking issue as closed. Didn’t use the correct build environment.

Closed 2024-06-03.

Thread 51 (2024-06-06):

I2C Issues

Ian-cmd-ops, 2024-06-06:
```
--- Available filters and text transformations: colorize, debug, default, direct, esp32_exception_decoder, hexlify, log2file, nocontrol, printable, send_on_enter, time
--- More details at https://bit.ly/pio-monitor-filters
--- Quit: Ctrl+C | Menu: Ctrl+T | Help: Ctrl+T followed by Ctrl+H
[   486][I][esp32-hal-psram.c:96] psramInit(): PSRAM enabled
[   499][I][ESP32SvelteKit.cpp:77] begin(): [Running Firmware Version: %s] 0.0.1
[   729][I][EventSocket.cpp:190] onSubscribe(): [EventSocket] onSubscribe for event: WiFiSettings
[   772][I][EventSocket.cpp:190] onSubscribe(): [EventSocket] onSubscribe for event: angles
[   772][I][CameraService.cpp:86] InitializeCamera(): Initializing camera
[  1007][I][EventSocket.cpp:190] onSubscribe(): [EventSocket] onSubscribe for event: CameraSettings
[  1009][I][EventSocket.cpp:190] onSubscribe(): [EventSocket] onSubscribe for event: ConfigurationSettings
[  1049][I][esp32-hal-i2c.c:75] i2cInit(): Initialising I2C Master: sda=14 scl=15 freq=100000
[  2051][E][Wire.cpp:513] requestFrom(): i2cRead returned Error 263
[  3052][E][Wire.cpp:513] requestFrom(): i2cRead returned Error 263
[  4053][E][Wire.cpp:513] requestFrom(): i2cRead returned Error 263
[  5054][E][Wire.cpp:513] requestFrom(): i2cRead returned Error 263
[  6055][E][Wire.cpp:513] requestFrom(): i2cRead returned Error 263
[  7056][E][Wire.cpp:513] requestFrom(): i2cRead returned Error 263
[  8158][E][Wire.cpp:513] requestFrom(): i2cRead returned Error 263
[  9262][E][Wire.cpp:513] requestFrom(): i2cRead returned Error 263
[  9262][E][IMUService.h:36] begin(): [IMUService] MPU initialize failed
[ 10264][E][Wire.cpp:513] requestFrom(): i2cRead returned Error 263
[ 11265][E][Wire.cpp:513] requestFrom(): i2cRead returned Error 263
[ 12266][E][Wire.cpp:513] requestFrom(): i2cRead returned Error 263
[ 13267][E][Wire.cpp:513] requestFrom(): i2cRead returned Error 263
[ 14268][E][Wire.cpp:513] requestFrom(): i2cRead returned Error 263
[ 14268][E][IMUService.h:52] begin(): [IMUService] BMP initialize failed
[ 14947][E][Wire.cpp:499] requestFrom(): i2cWriteReadNonStop returned Error -1
[ 15447][E][Wire.cpp:499] requestFrom(): i2cWriteReadNonStop returned Error -1
[ 15948][E][Wire.cpp:499] requestFrom(): i2cWriteReadNonStop returned Error -1
[ 16449][E][Wire.cpp:499] requestFrom(): i2cWriteReadNonStop returned Error -1
[ 16952][E][Wire.cpp:499] requestFrom(): i2cWriteReadNonStop returned Error -1
[ 17452][E][Wire.cpp:499] requestFrom(): i2cWriteReadNonStop returned Error -1
[ 17953][E][Wire.cpp:499] requestFrom(): i2cWriteReadNonStop returned Error -1
[ 18454][E][Wire.cpp:499] requestFrom(): i2cWriteReadNonStop returned Error -1
[ 18957][E][Wire.cpp:499] requestFrom(): i2cWriteReadNonStop returned Error -1
[ 19458][E][Wire.cpp:499] requestFrom(): i2cWriteReadNonStop returned Error -1
[ 19959][E][Wire.cpp:499] requestFrom(): i2cWriteReadNonStop returned Error -1
[ 20460][E][Wire.cpp:499] requestFrom(): i2cWriteReadNonStop returned Error -1
[ 20963][E][Wire.cpp:499] requestFrom(): i2cWriteReadNonStop returned Error -1
[ 21464][E][Wire.cpp:499] requestFrom(): i2cWriteReadNonStop returned Error -1
[ 21965][E][Wire.cpp:499] requestFrom(): i2cWriteReadNonStop returned Error -1
[ 22466][E][Wire.cpp:499] requestFrom(): i2cWriteReadNonStop returned Error -1
[ 22969][E][Wire.cpp:499] requestFrom(): i2cWriteReadNonStop returned Error -1
[ 23469][E][Wire.cpp:499] requestFrom(): i2cWriteReadNonStop returned Error -1
[ 23971][E][Wire.cpp:499] requestFrom(): i2cWriteReadNonStop returned Error -1
[ 24471][E][Wire.cpp:499] requestFrom(): i2cWriteReadNonStop returned Error -1
```
I went I upload and monitor, I get this. I've also been getting issues trying to connect I2C to connect to the MPU and GPY.
Do you think adding the multiplexer would help clean up some of the wiring.
[Adafruit TCA9548A I2C Multiplexer](https://www.amazon.com/Adafruit-TCA9548A-I2C-Multiplexer-ADA2717/dp/B017C09ETS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)

Ian-cmd-ops, 2024-06-06:
My other suggest besides the Multiplex I showed is this, https://www.amazon.com/Breakout-Serial-Wombat-PCB_0012-Expansion/dp/B0BW9WVMPV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
I think it should be added to the BOM

Ian-cmd-ops, 2024-06-09:
Got I2C output. It's a breadboard issue. Appreciate the hell out you for your commitment to this project.

Closed 2024-06-10.

Thread 53 (2024-06-10):

GPS and Having Second ESP32 for Sensors,

Ian-cmd-ops, 2024-06-10:
I have enjoyed working with you on this project and having your assistance in making this leg of SpotMicro project a reality. I enjoy the challenge of trying to troubleshoot issues. As I was reading the goal you have outlined, a idea dawned on me about have GPS integrations could be done with the use of ESP32 LoRA  modules for sensor management. They have GPS, ESP32, LoRA for future development (a small mesh of Leika could communicate) . If you need assistance, I can make CAD models for addition ESP32 modules. Cheers Mate

runeharlyk, 2024-06-18:
I'm currently looking on how to connect a neo 6m GPS module to the ESP32 cam, but as most pins are already is in use it poses some issues. Would you like to have the ESP32 Lora module be the main controller or talk to another? I have through about splitting the firmware #34 to make the robots more customizable.

Ian-cmd-ops, 2024-06-22:
An ESP32 LoRA module for controller would be cool. I could look into having the work together and navigate, If it's easier and simpler for you.

Ian-cmd-ops, 2024-06-26:
I think creating a platform to build off would be great. Controlling the robot via the ESP32 have it future capabilities for controlled Pi  control having an ARM and LIDAR would be nice.

Thread 54 (2024-06-11):

Sluggish and Non responsive site.

Ian-cmd-ops, 2024-06-11:
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
I'm having trouble have the latest build load webpages. It's a bit sluggish and slow to respond. I've posted the output for the serial monitor to you.

```
--- Terminal on COM5 | 115200 8-N-1
--- Available filters and text transformations: colorize, debug, default, direct, esp32_exception_decoder, hexlify, log2file, nocontrol, printable, send_on_enter, time
--- More details at https://bit.ly/pio-monitor-filters
--- Quit: Ctrl+C | Menu: Ctrl+T | Help: Ctrl+T followed by Ctrl+H
[332215][I][PsychicHttpServer.cpp:235] openCallback(): [psychic] New client connected 56
[332263][I][PsychicHttpServer.cpp:261] closeCallback(): [psychic] Client disconnected 54
[332263][E][PsychicClient.cpp:67] remoteIP(): [psychic] Error getting client IP
[332263][I][EventSocket.cpp:48] onWSClose(): [EventSocket] ws[0.0.0.0][54] disconnect
[332464][I][PsychicHttpServer.cpp:235] openCallback(): [psychic] New client connected 54
[332469][I][EventSocket.cpp:39] onWSOpen(): [EventSocket] ws[192.168.4.2][54] connect
[345455][I][PsychicHttpServer.cpp:235] openCallback(): [psychic] New client connected 57
[345515][I][PsychicHttpServer.cpp:261] closeCallback(): [psychic] Client disconnected 57
[355922][I][PsychicHttpServer.cpp:261] closeCallback(): [psychic] Client disconnected 54
[355922][I][EventSocket.cpp:48] onWSClose(): [EventSocket] ws[192.168.4.2][54] disconnect
[356935][I][PsychicHttpServer.cpp:235] openCallback(): [psychic] New client connected 54
[356939][I][EventSocket.cpp:39] onWSOpen(): [EventSocket] ws[192.168.4.2][54] connect
[365096][I][PsychicHttpServer.cpp:235] openCallback(): [psychic] New client connected 57
[365106][I][PsychicHttpServer.cpp:235] openCallback(): [psychic] New client connected 58
[365108][I][PsychicHttpServer.cpp:261] closeCallback(): [psychic] Client disconnected 54
[365111][I][EventSocket.cpp:48] onWSClose(): [EventSocket] ws[192.168.4.2][54] disconnect
[365130][I][PsychicHttpServer.cpp:235] openCallback(): [psychic] New client connected 54
[365160][I][PsychicHttpServer.cpp:261] closeCallback(): [psychic] Client disconnected 57
[365164][I][PsychicHttpServer.cpp:235] openCallback(): [psychic] New client connected 57
[365177][I][PsychicHttpServer.cpp:261] closeCallback(): [psychic] Client disconnected 58
[365182][I][PsychicHttpServer.cpp:235] openCallback(): [psychic] New client connected 58
[365197][I][PsychicHttpServer.cpp:261] closeCallback(): [psychic] Client disconnected 54
[365224][I][PsychicHttpServer.cpp:261] closeCallback(): [psychic] Client disconnected 57
[365237][I][PsychicHttpServer.cpp:261] closeCallback(): [psychic] Client disconnected 58
[365387][I][PsychicHttpServer.cpp:235] openCallback(): [psychic] New client connected 54
[365392][I][EventSocket.cpp:39] onWSOpen(): [EventSocket] ws[192.168.4.2][54] connect
[376086][I][PsychicHttpServer.cpp:235] openCallback(): [psychic] New client connected 57
[376092][I][EventSocket.cpp:39] onWSOpen(): [EventSocket] ws[192.168.4.2][57] connect
[376102][I][PsychicHttpServer.cpp:261] closeCallback(): [psychic] Client disconnected 54
[376102][I][EventSocket.cpp:48] onWSClose(): [EventSocket] ws[192.168.4.2][54] disconnect
[386096][E][PsychicResponse.cpp:117] send(): [psychic] Send response failed (ESP_ERR_HTTPD_RESP_SEND)
[386096][I][PsychicHttpServer.cpp:261] closeCallback(): [psychic] Client disconnected 56
[386104][I][PsychicHttpServer.cpp:235] openCallback(): [psychic] New client connected 54
[386114][I][EventSocket.cpp:39] onWSOpen(): [EventSocket] ws[192.168.4.2][54] connect
[386123][I][PsychicHttpServer.cpp:235] openCallback(): [psychic] New client connected 56
[386131][I][PsychicHttpServer.cpp:261] closeCallback(): [psychic] Client disconnected 57
[386133][I][EventSocket.cpp:48] onWSClose(): [EventSocket] ws[192.168.4.2][57] disconnect
[397100][I][PsychicHttpServer.cpp:235] openCallback(): [psychic] New client connected 57
[397107][E][PsychicResponse.cpp:117] send(): [psychic] Send response failed (ESP_ERR_HTTPD_RESP_SEND)
[397107][I][PsychicHttpServer.cpp:261] closeCallback(): [psychic] Client disconnected 57
[397116][I][PsychicHttpServer.cpp:261] closeCallback(): [psychic] Client disconnected 54
[397121][E][PsychicClient.cpp:67] remoteIP(): [psychic] Error getting client IP
[397121][I][EventSocket.cpp:48] onWSClose(): [EventSocket] ws[0.0.0.0][54] disconnect
[420832][I][PsychicHttpServer.cpp:235] openCallback(): [psychic] New client connected 54
[420843][I][PsychicHttpServer.cpp:235] openCallback(): [psychic] New client connected 57
[420850][I][PsychicHttpServer.cpp:235] openCallback(): [psychic] New client connected 58
[446022][D][WiFiGeneric.cpp:1039] _eventCallback(): Arduino Event: 13 - AP_STADISCONNECTED
[456090][E][WiFiUdp.cpp:185] endPacket(): could not send data: -1
[468090][E][WiFiUdp.cpp:185] endPacket(): could not send data: -1
[480090][E][WiFiUdp.cpp:185] endPacket(): could not send data: -1
[492090][E][WiFiUdp.cpp:185] endPacket(): could not send data: -1
[504090][E][WiFiUdp.cpp:185] endPacket(): could not send data: -1
[516090][E][WiFiUdp.cpp:185] endPacket(): could not send data: -1
```

Closed 2024-06-14.

Thread 58 (2024-06-19):

No I2C communication along with Connectivity Issues

Ian-cmd-ops, 2024-06-19:
```
--- Terminal on COM8 | 115200 8-N-1
--- Available filters and text transformations: colorize, debug, default, direct, esp32_exception_decoder, hexlify, log2file, nocontrol, printable, send_on_enter, time
--- More details at https://bit.ly/pio-monitor-filters
--- Quit: Ctrl+C | Menu: Ctrl+T | Help: Ctrl+T followed by Ctrl+H
�x�x�����xx����␀��x␀���xx�x␀�x�x�x�����xx����␀��x␀���xx�x␀�x�x�x�����xx����␀��x␀���xx�x␀�x�x�x�����xx����␀��x␀���xx�x␀�x�x�x�����xx����␀��x␀���xx�x␀�x�x�x�����xx����␀��x␀���xx�x␀�x�x�x�����xx����␀��x␀���xx�x␀�x�x�x�����xx����␀��x␀���xx�x␀�x�x�x�����xx����␀��x␀���xx�x␀�x�x�x�����xx����␀��x␀���xx�x␀�x�x�x�����xx����␀��x␀���xx�x␀�x�x�x�����xx����␀��x␀���xx�x␀�x�x�x�����xx����␀��x␀���xx�x␀�x�x�x�����xx����␀��x␀���xx�x␀�x�x�x�����xx����␀��x␀���xx�x␀�x�x�x�����xx����␀��x␀���xx�x␀�x�x�x�����xx����␀��x␀���xx�x␀�x�x�x�����xx����␀��x␀���xx�x␀�x�x�x�����xx����␀��x␀���xx�x␀�x�x�x�����xx����␀��x␀���xx�x␀�x�x�x�����xx����␀��x␀���xx�x␀�x�x�x�����xx����␀��x␀���xx�x␀�x�x�x�����xx����␀��x␀���xx�x␀�x�x�x�����xx����␀��x␀���xx�x␀�x�x�x�����xx����␀��x␀���xx�x␀�x�x�x�����xx����␀��x␀���xx�x␀�x�x�x�����xx����␀��x␀���xx�x␀�x�x�x�����xx����␀��x␀���xx�x␀�x�x�x�����xx����␀��x␀���xx�x␀�x�x�x�����xx����␀��x␀���xx�x␀�x�x�x�����xx����␀��x␀���xx�x␀�x�x�x�����xx����␀��x␀���xx�x␀�x�x�x�����xx����␀��x␀���xx�x␀�x�x�x�����xx����␀��x␀���xx�x␀�x�x�x�����xx����␀��x␀���xx�x␀�x�x�x�����xx����␀��x␀���xx�x␀�x�x�x�����xx����␀��x␀���xx�x␀�x�x�x�����xx����␀��x␀���xx�x␀�x�x�x�����xx����␀��x␀���xx�x␀�x�x�x�����xx����␀��x␀���xx�x␀�x�x�x�����xx����␀��x␀���xx�x␀�x�x�x�����xx����␀��x␀���xx�x␀�x�x�x�����xx����␀��x␀���xx�x␀�x�x�x�����xx����␀��x␀���xx�x␀�x�x�x�����xx����␀��x␀���xx�x␀�x�x�x�����xx����␀��x␀���xx�x␀�x�x�x�����xx����␀��x␀���xx�x␀�x�x�x�����xx����␀��x␀���xx�x␀�x�x�x�����xx����␀��x␀���xx�x␀�x�x�x�����xx����␀��x␀���xx�x␀�x�x�x�����xx����␀��x␀���xx�x␀�x�x�x�����xx����␀��x␀���xx�x␀�x�x�x�����xx����␀��x␀���xx�x␀�x�x�x�����xx����␀��x␀���xx�x␀�x�x�x�����xx����␀��x␀���xx�x␀�x�x�x�����xx����␀��x␀���xx�x␀�x�x�x�����xx����␀��x␀���xx�x␀�x�x�x�����xx����␀��x␀���xx�x␀�x�x�x�����xx����␀��x␀���xx�x␀�x�x�x�����xx����␀��x␀���xx�x␀�x�x�x�����xx����␀��x␀���xx�x␀�x�x�x�����xx����␀��x␀���xx�x␀�x�x�x�����xx����␀��x␀���xx�x␀�x�x�x�����xx����␀��x␀���xx�x␀�x�x�x�����xx����␀��x␀���xx�x␀�x�x�x�����xx����␀��x␀���xx�x␀�x�x�x�����xx����␀��x␀���xx�x␀�x�x�x�����xx����␀��x␀���xx�x␀�x�x�x�����xx����␀��x␀���xx�x␀�x�x�x�����xx����␀��x␀���xx�x␀�x�x�x�����xx����␀��x␀���xx�x␀�x�x�x�����xx����␀��x␀���xx�x␀�x�x�x�����xx����␀��x␀���xx�x␀�x�x�x�����xx����␀��x␀���xx�x␀�x�x�x�����xx����␀��x␀���xx�x␀�x�x�x�����xx����␀��x␀���xx�x␀�x�x�x�����xx����␀��x␀���xx�x␀�x�x�x�����xx����␀��x␀���xx�x␀�x�x�x�����xx����␀��x␀���xx�x␀�x�x�x�����xx����␀��x␀���xx

rst:ets Jul 29 2019 12:21:46

rst:ets Jul 29 2019 12:21:46

rst:ets Jul 29 2019 12:21:46

rst:ets Jul 29 2019 12:21:46

rst:ets Jul 29 2019 12:21:46

rst:ets Jul 29 2019 12:21:46

rst:ets Jul 29 2019 12:21:46

rst:ets Jul 29 2019 12:21:46

rst:ets Jul 29 2019 12:21:46

rst:ets Jul 29 2019 12:21:46

rst:ets Jul 29 2019 12:21:46

rst:ets Jul 29 2019 12:21:46

rst:ets Jul 29 2019 12:21:46

rst:ets Jul 29 2019 12:21:46

rst:ets Jul 29 2019 12:21:46

rst:ets Jul 29 2019 12:21:46

rst:ets Jul 29 2019 12:21:46

rst:ets Jul 29 2019 12:21:46

rst:ets Jul 29 2019 12:21:46

rst:ets Jul 29 2019 12:21:46

rst:ets Jul 29 2019 12:21:46

rst:ets Jul 29 2019 12:21:46

rst:ets Jul 29 2019 12:21:46

rst:ets Jul 29 2019 12:21:46

rst:ets Jul 29 2019 12:21:46

rst:ets Jul 29 2019 12:21:46

rst:ets Jul 29 2019 12:21:46

rst:ets Jul 29 2019 12:21:46

rst:ets Jul 29 2019 12:21:46

rst:ets Jul 29 2019 12:21:46

rst:ets Jul 29 2019 12:21:46

rst:ets Jul 29 2019 12:21:46

rst:ets Jul 29 2019 12:21:46

rst:ets Jul 29 2019 12:21:46

rst:ets Jul 29 2019 12:21:46

rst:ets Jul 29 2019 12:21:46

rst:0x1 (POWERON_RESET),boot:0x13 (S0x1 (POWERON_RESET),boot:0x13 (S0x1 (POWERON_RESET),boot:0x13 (S0x1 (POWERON_RESET),boot:0x13 (S0x1 (POWERON_RESET),boot:0x13 (S0x1 (POWERON_RESET),boot:0x13 (S0x1 (POWERON_RESET),boot:0x13 (S0x1 (POWERON_RESET),boot:0x13 (S0x1 (POWERON_RESET),boot:0x13 (S0x1 (POWERON_RESET),boot:0x13 (S0x1 (POWERON_RESET),boot:0x13 (S0x1 (POWERON_RESET),boot:0x13 (S0x1 (POWERON_RESET),boot:0x13 (S0x1 (POWERON_RESET),boot:0x13 (S0x1 (POWERON_RESET),boot:0x13 (S0x1 (POWERON_RESET),boot:0x13 (S0x1 (POWERON_RESET),boot:0x13 (S0x1 (POWERON_RESET),boot:0x13 (S0x1 (POWERON_RESET),boot:0x13 (S0x1 (POWERON_RESET),boot:0x13 (S0x1 (POWERON_RESET),boot:0x13 (S0x1 (POWERON_RESET),boot:0x13 (S0x1 (POWERON_RESET),boot:0x13 (S0x1 (POWERON_RESET),boot:0x13 (S0x1 (POWERON_RESET),boot:0x13 (S0x1 (POWERON_RESET),boot:0x13 (S0x1 (POWERON_RESET),boot:0x13 (S0x1 (POWERON_RESET),boot:0x13 (S0x1 (POWERON_RESET),boot:0x13 (S0x1 (POWERON_RESET),boot:0x13 (S0x1 (POWERON_RESET),boot:0x13 (S0x1 (POWERON_RESET),boot:0x13 (S0x1 (POWERON_RESET),boot:0x13 (SPI_FAST_FLASH_BOOT)
configsip: 0, SPIWP:0xee
clk_drv:0x00,q_drv:0x00,d_drv:0x00,cs0_drv:0x00,hd_drv:0x00,wp_drv:0x00
mode:DIO, clock div:2
load:0x3fff0030,len:1184
load:0x40078000,len:13232
load:0x40080400,len:3028
entry 0x400805e4
[     9][D][esp32-hal-cpu.c:244] setCpuFrequencyMhz(): PLL: 480 / 2 = 240 Mhz, APB: 80000000 Hz
[    23][I][ESP32SvelteKit.cpp:81] begin(): [Running Firmware Version: %s] 0.0.1
[    38][D][WiFiGeneric.cpp:1039] _eventCallback(): Arduino Event: 0 - WIFI_READY
[   117][D][WiFiGeneric.cpp:1039] _eventCallback(): Arduino Event: 2 - STA_START
[   153][D][WiFiGeneric.cpp:1039] _eventCallback(): Arduino Event: 3 - STA_STOP
[   245][D][EventSocket.cpp:203] onSubscribe(): [EventSocket] onSubscribe for event: WiFiSettings
[   275][D][EventSocket.cpp:203] onSubscribe(): [EventSocket] onSubscribe for event: angles
[   276][D][EventSocket.cpp:203] onSubscribe(): [EventSocket] onSubscribe for event: ConfigurationSettings
[   300][I][esp32-hal-i2c.c:75] i2cInit(): Initialising I2C Master: sda=14 scl=15 freq=100000
[  1303][E][Wire.cpp:513] requestFrom(): i2cRead returned Error 263
[  2304][E][Wire.cpp:513] requestFrom(): i2cRead returned Error 263
[  3305][E][Wire.cpp:513] requestFrom(): i2cRead returned Error 263
[  4306][E][Wire.cpp:513] requestFrom(): i2cRead returned Error 263
[  5307][E][Wire.cpp:513] requestFrom(): i2cRead returned Error 263
[  6308][E][Wire.cpp:513] requestFrom(): i2cRead returned Error 263
[  7410][E][Wire.cpp:513] requestFrom(): i2cRead returned Error 263
[  8514][E][Wire.cpp:513] requestFrom(): i2cRead returned Error 263
[  8514][E][IMUService.h:35] begin(): [IMUService] MPU initialize failed
[  9516][E][Wire.cpp:513] requestFrom(): i2cRead returned Error 263
[ 10517][E][Wire.cpp:513] requestFrom(): i2cRead returned Error 263
[ 11518][E][Wire.cpp:513] requestFrom(): i2cRead returned Error 263
[ 12519][E][Wire.cpp:513] requestFrom(): i2cRead returned Error 263
[ 12520][W][Wire.cpp:301] begin(): Bus already started in Master Mode.
[ 13532][E][Wire.cpp:513] requestFrom(): i2cRead returned Error 263
[ 13539][D][EventSocket.cpp:203] onSubscribe(): [EventSocket] onSubscribe for event: servoConfiguration
[ 14569][E][Wire.cpp:513] requestFrom(): i2cRead returned Error 263
[ 15577][E][Wire.cpp:513] requestFrom(): i2cRead returned Error 263
[ 15583][I][ServoController.h:169] configure(): [ServoController] Configured with oscillator frequency 27000000 and PWM frequency 50
[ 15585][I][APSettingsService.cpp:89] startAP(): [APSettingsService] Starting software access point
[ 15600][D][WiFiGeneric.cpp:1039] _eventCallback(): Arduino Event: 0 - WIFI_READY
[ 15605][D][WiFiGeneric.cpp:1039] _eventCallback(): Arduino Event: 10 - AP_START
[ 16178][D][WiFiGeneric.cpp:1039] _eventCallback(): Arduino Event: 11 - AP_STOP
[ 16178][D][WiFiGeneric.cpp:1039] _eventCallback(): Arduino Event: 10 - AP_START
[ 16181][I][APSettingsService.cpp:98] startAP(): [APSettingsService] Starting captive portal on 192.168.4.1
[ 29979][D][WiFiGeneric.cpp:1039] _eventCallback(): Arduino Event: 12 - AP_STACONNECTED
[ 30085][D][WiFiGeneric.cpp:1039] _eventCallback(): Arduino Event: 14 - AP_STAIPASSIGNED
[ 52308][I][PsychicHttpServer.cpp:235] openCallback(): [psychic] New client connected 52
[ 52376][I][PsychicHttpServer.cpp:261] closeCallback(): [psychic] Client disconnected 52
[ 52408][I][PsychicHttpServer.cpp:235] openCallback(): [psychic] New client connected 52
[ 52478][I][PsychicHttpServer.cpp:261] closeCallback(): [psychic] Client disconnected 52
[ 66240][I][PsychicHttpServer.cpp:235] openCallback(): [psychic] New client connected 52
[ 66298][I][PsychicHttpServer.cpp:261] closeCallback(): [psychic] Client disconnected 52
[ 67796][I][PsychicHttpServer.cpp:235] openCallback(): [psychic] New client connected 52
[ 67858][I][PsychicHttpServer.cpp:261] closeCallback(): [psychic] Client disconnected 52
[ 68103][I][PsychicHttpServer.cpp:235] openCallback(): [psychic] New client connected 52
[ 68163][I][PsychicHttpServer.cpp:261] closeCallback(): [psychic] Client disconnected 52
[ 73209][I][PsychicHttpServer.cpp:235] openCallback(): [psychic] New client connected 52
[ 73295][I][PsychicHttpServer.cpp:261] closeCallback(): [psychic] Client disconnected 52
[ 73974][I][PsychicHttpServer.cpp:235] openCallback(): [psychic] New client connected 52
[ 74120][I][PsychicHttpServer.cpp:235] openCallback(): [psychic] New client connected 53
[ 75150][I][PsychicHttpServer.cpp:235] openCallback(): [psychic] New client connected 54
[ 75152][I][PsychicHttpServer.cpp:235] openCallback(): [psychic] New client connected 55
[ 75496][I][PsychicHttpServer.cpp:235] openCallback(): [psychic] New client connected 56
[ 75504][I][EventSocket.cpp:69] onWSOpen(): [EventSocket] ws[192.168.4.2][56] connect

abort() was called at PC 0x4015a737 on core 1

Backtrace: 0x4008390d:0x3ffbc160 0x4008ee35:0x3ffbc180 0x40094401:0x3ffbc1a0 0x4015a737:0x3ffbc220 0x4015a77e:0x3ffbc240 0x4015a6df:0x3ffbc260 0x400e2fe3:0x3ffbc280 0x400e4067:0x3ffbc2a0 0x40189575:0x3ffbc390 0x400d9726:0x3ffbc3b0 0x400d9f39:0x3ffbc470 0x401175c1:0x3ffbc4f0 0x40117e56:0x3ffbc590 0x40116b24:0x3ffbc5b0 0x4018a782:0x3ffbc5d0 0x40116c49:0x3ffbc5f0

  #0  0x4008390d:0x3ffbc160 in panic_abort at /Users/ficeto/Desktop/ESP32/ESP32S2/esp-idf-public/components/esp_system/panic.c:408
  #1  0x4008ee35:0x3ffbc180 in esp_system_abort at /Users/ficeto/Desktop/ESP32/ESP32S2/esp-idf-public/components/esp_system/esp_system.c:137
  #2  0x40094401:0x3ffbc1a0 in abort at /Users/ficeto/Desktop/ESP32/ESP32S2/esp-idf-public/components/newlib/abort.c:46
  #3  0x4015a737:0x3ffbc220 in __cxxabiv1::__terminate(void (*)()) at /builds/idf/crosstool-NG/.build/HOST-x86_64-w64-mingw32/xtensa-esp32-elf/src/gcc/libstdc++-v3/libsupc++/eh_terminate.cc:47
  #4  0x4015a77e:0x3ffbc240 in std::terminate() at /builds/idf/crosstool-NG/.build/HOST-x86_64-w64-mingw32/xtensa-esp32-elf/src/gcc/libstdc++-v3/libsupc++/eh_terminate.cc:57
  #5  0x4015a6df:0x3ffbc260 in __cxa_throw at /builds/idf/crosstool-NG/.build/HOST-x86_64-w64-mingw32/xtensa-esp32-elf/src/gcc/libstdc++-v3/libsupc++/eh_throw.cc:95
  #6  0x400e2fe3:0x3ffbc280 in char_to_message_type(char) at lib/ESP32-sveltekit/EventSocket.cpp:13 (discriminator 2)
  #7  0x400e4067:0x3ffbc2a0 in EventSocket::onFrame(PsychicWebSocketRequest*, httpd_ws_frame*) at lib/ESP32-sveltekit/EventSocket.cpp:91
  #8  0x40189575:0x3ffbc390 in int std::__invoke_impl<int, int (EventSocket::*&)(PsychicWebSocketRequest*, httpd_ws_frame*), EventSocket*&, PsychicWebSocketRequest*, httpd_ws_frame*>(std::__invoke_memfun_deref, int (EventSocket::*&)(PsychicWebSocketRequest*, httpd_ws_frame*), EventSocket*&, PsychicWebSocketRequest*&&, httpd_ws_frame*&&) at c:\users\rip_h\.platformio\packages\toolchain-xtensa-esp32\xtensa-esp32-elf\include\c++\8.4.0\bits/invoke.h:73
      (inlined by) std::__invoke_result<int (EventSocket::*&)(PsychicWebSocketRequest*, httpd_ws_frame*), EventSocket*&, PsychicWebSocketRequest*, httpd_ws_frame*>::type std::__invoke<int (EventSocket::*&)(PsychicWebSocketRequest*, httpd_ws_frame*), EventSocket*&, PsychicWebSocketRequest*, httpd_ws_frame*>(int (EventSocket::*&)(PsychicWebSocketRequest*, httpd_ws_frame*), EventSocket*&, PsychicWebSocketRequest*&&, httpd_ws_frame*&&) at c:\users\rip_h\.platformio\packages\toolchain-xtensa-esp32\xtensa-esp32-elf\include\c++\8.4.0\bits/invoke.h:95
      (inlined by) int std::_Bind<int (EventSocket::*(EventSocket*, std::_Placeholder<1>, std::_Placeholder<2>))(PsychicWebSocketRequest*, httpd_ws_frame*)>::__call<int, PsychicWebSocketRequest*&&, httpd_ws_frame*&&, 0u, 1u, 2u>(std::tuple<PsychicWebSocketRequest*&&, httpd_ws_frame*&&>&&, std::_Index_tuple<0u, 1u, 2u>) at c:\users\rip_h\.platformio\packages\toolchain-xtensa-esp32\xtensa-esp32-elf\include\c++\8.4.0/functional:400
      (inlined by) int std::_Bind<int (EventSocket::*(EventSocket*, std::_Placeholder<1>, std::_Placeholder<2>))(PsychicWebSocketRequest*, httpd_ws_frame*)>::operator()<PsychicWebSocketRequest*, httpd_ws_frame*, int>(PsychicWebSocketRequest*&&, httpd_ws_frame*&&) at c:\users\rip_h\.platformio\packages\toolchain-xtensa-esp32\xtensa-esp32-elf\include\c++\8.4.0/functional:484
      (inlined by) std::_Function_handler<int (PsychicWebSocketRequest*, httpd_ws_frame*), std::_Bind<int (EventSocket::*(EventSocket*, std::_Placeholder<1>, std::_Placeholder<2>))(PsychicWebSocketRequest*, httpd_ws_frame*)> >::_M_invoke(std::_Any_data const&, PsychicWebSocketRequest*&&, httpd_ws_frame*&&) at c:\users\rip_h\.platformio\packages\toolchain-xtensa-esp32\xtensa-esp32-elf\include\c++\8.4.0\bits/std_function.h:282
  #9  0x400d9726:0x3ffbc3b0 in std::function<int (PsychicWebSocketRequest*, httpd_ws_frame*)>::operator()(PsychicWebSocketRequest*, httpd_ws_frame*) const at c:\users\rip_h\.platformio\packages\toolchain-xtensa-esp32\xtensa-esp32-elf\include\c++\8.4.0\bits/std_function.h:687
      (inlined by) PsychicWebSocketHandler::handleRequest(PsychicRequest*) at lib/PsychicHttp/src/PsychicWebSocket.cpp:208
  #10 0x400d9f39:0x3ffbc470 in PsychicEndpoint::requestCallback(httpd_req*) at lib/PsychicHttp/src/PsychicEndpoint.cpp:72
  #11 0x401175c1:0x3ffbc4f0 in httpd_req_new at /Users/ficeto/Desktop/ESP32/ESP32S2/esp-idf-public/components/esp_http_server/src/httpd_parse.c:776
  #12 0x40117e56:0x3ffbc590 in httpd_sess_process at /Users/ficeto/Desktop/ESP32/ESP32S2/esp-idf-public/components/esp_http_server/src/httpd_sess.c:419 (discriminator 15)
  #13 0x40116b24:0x3ffbc5b0 in httpd_process_session at /Users/ficeto/Desktop/ESP32/ESP32S2/esp-idf-public/components/esp_http_server/src/httpd_main.c:178
      (inlined by) httpd_process_session at /Users/ficeto/Desktop/ESP32/ESP32S2/esp-idf-public/components/esp_http_server/src/httpd_main.c:163
  #14 0x4018a782:0x3ffbc5d0 in httpd_sess_enum at /Users/ficeto/Desktop/ESP32/ESP32S2/esp-idf-public/components/esp_http_server/src/httpd_sess.c:50 (discriminator 1)
  #15 0x40116c49:0x3ffbc5f0 in httpd_server at /Users/ficeto/Desktop/ESP32/ESP32S2/esp-idf-public/components/esp_http_server/src/httpd_main.c:228
      (inlined by) httpd_thread at /Users/ficeto/Desktop/ESP32/ESP32S2/esp-idf-public/components/esp_http_server/src/httpd_main.c:250

ELF file SHA256: a047969d52ee0992

Rebooting...
ets Jul 29 2019 12:21:46

rst:0xc (SW_CPU_RESET),boot:0x13 (SPI_FAST_FLASH_BOOT)
configsip: 0, SPIWP:0xee
clk_drv:0x00,q_drv:0x00,d_drv:0x00,cs0_drv:0x00,hd_drv:0x00,wp_drv:0x00
mode:DIO, clock div:2
load:0x3fff0030,len:1184
load:0x40078000,len:13232
load:0x40080400,len:3028
entry 0x400805e4
[    36][D][esp32-hal-cpu.c:244] setCpuFrequencyMhz(): PLL: 480 / 2 = 240 Mhz, APB: 80000000 Hz
[    50][I][ESP32SvelteKit.cpp:81] begin(): [Running Firmware Version: %s] 0.0.1
[    65][D][WiFiGeneric.cpp:1039] _eventCallback(): Arduino Event: 0 - WIFI_READY
[   144][D][WiFiGeneric.cpp:1039] _eventCallback(): Arduino Event: 2 - STA_START
[   180][D][WiFiGeneric.cpp:1039] _eventCallback(): Arduino Event: 3 - STA_STOP
[   271][D][EventSocket.cpp:203] onSubscribe(): [EventSocket] onSubscribe for event: WiFiSettings
[   301][D][EventSocket.cpp:203] onSubscribe(): [EventSocket] onSubscribe for event: angles
[   303][D][EventSocket.cpp:203] onSubscribe(): [EventSocket] onSubscribe for event: ConfigurationSettings
[   326][I][esp32-hal-i2c.c:75] i2cInit(): Initialising I2C Master: sda=14 scl=15 freq=100000
[  1329][E][Wire.cpp:513] requestFrom(): i2cRead returned Error 263
[  2330][E][Wire.cpp:513] requestFrom(): i2cRead returned Error 263
[  3331][E][Wire.cpp:513] requestFrom(): i2cRead returned Error 263
[  4332][E][Wire.cpp:513] requestFrom(): i2cRead returned Error 263
[  5333][E][Wire.cpp:513] requestFrom(): i2cRead returned Error 263
[  6334][E][Wire.cpp:513] requestFrom(): i2cRead returned Error 263
[  7436][E][Wire.cpp:513] requestFrom(): i2cRead returned Error 263
[  8540][E][Wire.cpp:513] requestFrom(): i2cRead returned Error 263
[  8541][E][IMUService.h:35] begin(): [IMUService] MPU initialize failed
[  9542][E][Wire.cpp:513] requestFrom(): i2cRead returned Error 263
[ 10543][E][Wire.cpp:513] requestFrom(): i2cRead returned Error 263
[ 11544][E][Wire.cpp:513] requestFrom(): i2cRead returned Error 263
[ 12545][E][Wire.cpp:513] requestFrom(): i2cRead returned Error 263
[ 12546][W][Wire.cpp:301] begin(): Bus already started in Master Mode.
[ 13558][E][Wire.cpp:513] requestFrom(): i2cRead returned Error 263
[ 13565][D][EventSocket.cpp:203] onSubscribe(): [EventSocket] onSubscribe for event: servoConfiguration
[ 14596][E][Wire.cpp:513] requestFrom(): i2cRead returned Error 263
[ 15603][E][Wire.cpp:513] requestFrom(): i2cRead returned Error 263
[ 15609][I][ServoController.h:169] configure(): [ServoController] Configured with oscillator frequency 27000000 and PWM frequency 50
[ 15611][I][APSettingsService.cpp:89] startAP(): [APSettingsService] Starting software access point
[ 15626][D][WiFiGeneric.cpp:1039] _eventCallback(): Arduino Event: 0 - WIFI_READY
[ 15631][D][WiFiGeneric.cpp:1039] _eventCallback(): Arduino Event: 10 - AP_START
[ 16204][D][WiFiGeneric.cpp:1039] _eventCallback(): Arduino Event: 11 - AP_STOP
[ 16205][D][WiFiGeneric.cpp:1039] _eventCallback(): Arduino Event: 10 - AP_START
[ 16208][I][APSettingsService.cpp:98] startAP(): [APSettingsService] Starting captive portal on 192.168.4.1
```
I wanted to let know that the AP connectivity is a bit dodgy. I can't get the I2C communication for any number of reasons but I think I was suppose to put the 4.7k resistor inline for the SDA and SCL connections.

runeharlyk, 2024-06-19:
I will look into the connectivity. For the I2C, there should not be anything between SCL and SDA connections.

Ian-cmd-ops, 2024-06-20:
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

> I will look into the connectivity. For the I2C, there should not be anything between SCL and SDA connections.

https://a.co/d/037ObbSe
I'm using this serial wombat as an I2C bus. I can't get read any serial data off the board when it's connected. do you have diagram to read the info from the board if I have a USB to TTL adapter.

runeharlyk, 2024-06-20:
The Serial Wombat you linked to is not a device in of it self, the description mentions *Board contains no electronics*. Its only made to make it simpler to hook up other devices - like a breadboard. You have to connect the board to the esp32, and then the I2C devices (MPU6050, PCA9685 etc) to the "Serial Wombat".

Ian-cmd-ops, 2024-06-20:
For clarification, I have connected that i2c and connected the pins in the same order as the silk screen. I'm unable to verify i2c data when it was connected. I had no comms with IMU when connected to the AP with the IMU connected to the Serial Wombat. Additional I couldn't verify comms with PCA9685. I thought it was my wiring was the issue but I triple checked it. I've exhausted most possible troubleshooting issues from my end. I'll attempt to see it the issue continues on my breadboard. Cheers mate.

runeharlyk, 2024-07-18:
Does the issue persist or can i close it?

Closed 2024-07-30.

Thread 98 (2024-10-15):

.Rebooting...

Mark11200, 2024-10-15:
rst:0xc (SW_CPU_RESET),boot:0x13 (SPI_FAST_FLASH_BOOT)
configsip: 0, SPIWP:0xee
clk_drv:0x00,q_drv:0x00,d_drv:0x00,cs0_drv:0x00,hd_drv:0x00,wp_drv:0x00
mode:DIO, clock div:2
load:0x3fff0030,len:1184
load:0x40078000,len:13232
load:0x40080400,len:3028
entry 0x400805e4
[    32][D][esp32-hal-cpu.c:244] setCpuFrequencyMhz(): PLL: 480 / 2 = 240 Mhz, APB: 80000000 Hz
[   481][I][esp32-hal-psram.c:96] psramInit(): PSRAM enabled
[   512][I][ESP32SvelteKit.cpp:67] begin(): [Running Firmware Version: %s] 0.0.1
[   535][D][WiFiGeneric.cpp:1039] _eventCallback(): Arduino Event: 0 - WIFI_READY
[   602][D][WiFiGeneric.cpp:1039] _eventCallback(): Arduino Event: 2 - STA_START
[   633][D][WiFiGeneric.cpp:1039] _eventCallback(): Arduino Event: 3 - STA_STOP
[   633][I][wifi_service.cpp:202] onStationModeStop(): [WiFiStatus] WiFi Connected.
[   794][I][esp32-hal-i2c.c:75] i2cInit(): Initialising I2C Master: sda=15 scl=13 freq=100000
[   796][W][Wire.cpp:301] begin(): Bus already started in Master Mode.
[  1813][E][Wire.cpp:513] requestFrom(): i2cRead returned Error 263
[  2826][E][Wire.cpp:513] requestFrom(): i2cRead returned Error 263
[  3839][E][Wire.cpp:513] requestFrom(): i2cRead returned Error 263
[  4849][E][Wire.cpp:513] requestFrom(): i2cRead returned Error 263
[  5853][E][Wire.cpp:513] requestFrom(): i2cRead returned Error 263
[  6857][E][Wire.cpp:513] requestFrom(): i2cRead returned Error 263
[  7861][E][Wire.cpp:513] requestFrom(): i2cRead returned Error 263
[  8865][E][Wire.cpp:513] requestFrom(): i2cRead returned Error 263
[  9868][E][Wire.cpp:513] requestFrom(): i2cRead returned Error 263
[ 10973][E][Wire.cpp:513] requestFrom(): i2cRead returned Error 263
[ 12091][E][Wire.cpp:513] requestFrom(): i2cRead returned Error 263
[ 12091][E][Peripherals.h:157] begin(): [IMUService] MPU initialize failed
[ 13096][E][Wire.cpp:513] requestFrom(): i2cRead returned Error 263
[ 14100][E][Wire.cpp:513] requestFrom(): i2cRead returned Error 263
[ 15104][E][Wire.cpp:513] requestFrom(): i2cRead returned Error 263
[ 16108][E][Wire.cpp:513] requestFrom(): i2cRead returned Error 263
[ 16109][W][Wire.cpp:301] begin(): Bus already started in Master Mode.
[ 17112][E][Wire.cpp:513] requestFrom(): i2cRead returned Error 263
[ 17113][E][Peripherals.h:173] begin(): [IMUService] BMP initialize failed
[ 17202][I][ServoController.h:64] update(): [ServoController] Updating servo data
[ 17205][I][CameraService.cpp:84] InitializeCamera(): Initializing camera
E (17222) camera: Camera probe failed with error 0x105(ESP_ERR_NOT_FOUND)
[ 17253][E][CameraService.cpp:89] InitializeCamera(): [CameraService] Camera probe failed with error 0x105
Guru Meditation Error: Core  1 panic'ed (LoadProhibited). Exception was unhandled.

Core  1 register dump:
PC      : 0x400e3fc2  PS      : 0x00060330  A0      : 0x800e410a  A1      : 0x3ffb2210
A2      : 0x3ffc0838  A3      : 0x3ffc18ac  A4      : 0xd16497a4  A5      : 0x00000001
A6      : 0x00000000  A7      : 0x3f401cc0  A8      : 0x800e3fc2  A9      : 0x3ffb21f0
A10     : 0x00000000  A11     : 0xd16497a4  A12     : 0x3ffc6b88  A13     : 0x3ffc09bc
A14     : 0x3f40184d  A15     : 0x400e82ac  SAR     : 0x00000012  EXCCAUSE: 0x0000001c
EXCVADDR: 0x00000008  LBEG    : 0x4008be7c  LEND    : 0x4008be87  LCOUNT  : 0xffffffff

Backtrace: 0x400e3fbf:0x3ffb2210 0x400e4107:0x3ffb2230 0x400d2e9f:0x3ffb2260 0x400f0b96:0x3ffb2290

ELF file SHA256: 8e35e413a967a0f2
.Rebooting...
ets Jul 29 2019 12:21:46

Closed 2024-10-15.

Thread 117 (2025-01-05):

[QUESTION] How to calibrate servos?

kami4ka, 2025-01-05:
I've build a spot micro and decided to start with ESP32 firmware first. Still, I can't find out how to calibrate servos. I'm using 120 degrees ones, so I would appreciate any information on this topic.

Closed 2025-01-05.

Thread 119 (2025-01-07):

Servo switch button has inverted action

runeharlyk, 2025-01-07:

Closed 2025-01-07.

Thread 132 (2025-03-21):

HTTP over websocket

runeharlyk, 2025-03-21:
The http request seem to be pretty slow on the esp32, especially when hosting an AP. By fetching dynamic svelte components over the already active websocket connection, we can speed up the initial load time.

There need to be done some testing and the issue of caching need to be done correctly.

The event socket command pallet has to be expanded for the new command type, which be include a binary buffer
