runeharlyk/SpotMicroESP32-Leika/esp32/include/motion_states/walk_state.h

#pragma once

#include <motion_states/state.h>
#include <odometry.h>
#include <peripherals/servo_output.h>
#include <utils/math_utils.h>
#include <algorithm>
#include <array>
#include <functional>
#include <optional>

struct gait_state_t {
    float step_height {0};
    float step_x {0};
    float step_z {0};
    float step_angle {0};
    float step_velocity {0.5};
    float step_depth {0};
};

// A degree-11 Bezier curve with these control points, at this phase.
constexpr float bezierAt(const float (&points)[12], const float phase) {
    float value = 0;
    for (int i = 0; i < 12; i++) {
        float b = combinatorial_constexpr(11, i);
        for (int power = 0; power < i; power++) b *= phase;
        for (int power = 0; power < 11 - i; power++) b *= 1 - phase;
        value += b * points[i];
    }
    return value;
}

// The furthest the curve gets from zero, sampled.
constexpr float bezierPeak(const float (&points)[12]) {
    constexpr int SAMPLES = 1024;
    float peak = 0;
    for (int sample = 0; sample <= SAMPLES; sample++) {
        const float value = bezierAt(points, float(sample) / SAMPLES);
        peak = std::max(peak, value < 0 ? -value : value);
    }
    return peak;
}

// The curve at SAMPLES + 1 evenly spaced phases.
template <int SAMPLES>
constexpr std::array<float, SAMPLES + 1> bezierSamples(const float (&points)[12]) {
    std::array<float, SAMPLES + 1> samples {};
    for (int sample = 0; sample <= SAMPLES; sample++) samples[sample] = bezierAt(points, float(sample) / SAMPLES);
    return samples;
}

enum class WALK_GAIT { TROT, CRAWL };

// The two schedules: each gait's clock rate factor and the share of the cycle a foot stands. A stance sweeps the foot
// through the stroke, so a stroke walks the body at stroke x factor / duty per cycle of the clock.
inline constexpr float CRAWL_FACTOR = 0.5f, CRAWL_DUTY = 0.85f, TROT_FACTOR = 2, TROT_DUTY = 0.75f;

// AUTO asks the body for the stick's share of the trot's top speed, whichever gait walks it: the crawl walks
// AUTO_CRAWL_STROKE (about 4.5) times the stroke the stick asks, where at the same stroke the crawl walked that much
// slower and AUTO's swap changed the speed by as much. AUTO picks the gait from that share, the larger of the stroke and
// the turn a full stick asks: the crawl up to AUTO_CRAWL_MAX, its own full stroke, and the trot above. The trot in
// force keeps its band AUTO_HYSTERESIS further down, so a stick held at the boundary does not swap the schedules back
// and forth.
inline constexpr float AUTO_CRAWL_STROKE = (TROT_FACTOR / TROT_DUTY) / (CRAWL_FACTOR / CRAWL_DUTY);
inline constexpr float AUTO_CRAWL_MAX = 1 / AUTO_CRAWL_STROKE, AUTO_HYSTERESIS = 0.06f;
constexpr WALK_GAIT selectAutoGait(float demand, WALK_GAIT current) {
    const float crawl_max = current == WALK_GAIT::CRAWL ? AUTO_CRAWL_MAX : AUTO_CRAWL_MAX - AUTO_HYSTERESIS;
    return demand <= crawl_max ? WALK_GAIT::CRAWL : WALK_GAIT::TROT;
}

class WalkState : public MotionState {
  private:
    WALK_GAIT mode = WALK_GAIT::TROT;
    std::optional<WALK_GAIT> requested_gait; // chosen mid-stride, taken at the next standstill (select_gait)
    bool auto_gait = false;
    float auto_settled_s = 0; // how long AUTO has held a standstill against a command
    float phase_time = 0.0f;
    float phase_offset[4] = {0.f, 0.5f, 0.5f, 0.f};
    float stand_offset = TROT_DUTY;
    float speed_factor = TROT_FACTOR;
    gait_state_t gait_state;
    gait_state_t target_gait_state;

    struct GaitDampers {
        CriticalDamper step_x, step_z, step_angle, step_depth, step_height;
    } gait_dampers;

    struct ShiftState {
        float start_x = 0.0f;
        float start_z = 0.0f;
        float target_x = 0.0f;
        float target_z = 0.0f;
        float start_time = 0.0f;
        int current_shift_leg = -1;
    } shift_state;

    struct LegStates {
        std::array<int, 4> stance;
        std::array<int, 4> swing;
        int stance_count = 0;
        int swing_count = 0;
        int next_swing = -1;
        float time_to_lift = INFINITY;
    };

    static constexpr uint8_t BEZIER_POINTS = 12;
    static constexpr std::array<float, BEZIER_POINTS> COMBINATORIAL_VALUES = {
        combinatorial_constexpr(11, 0),  // 1
        combinatorial_constexpr(11, 1),  // 11
        combinatorial_constexpr(11, 2),  // 55
        combinatorial_constexpr(11, 3),  // 165
        combinatorial_constexpr(11, 4),  // 330
        combinatorial_constexpr(11, 5),  // 462
        combinatorial_constexpr(11, 6),  // 462
        combinatorial_constexpr(11, 7),  // 330
        combinatorial_constexpr(11, 8),  // 165
        combinatorial_constexpr(11, 9),  // 55
        combinatorial_constexpr(11, 10), // 11
        combinatorial_constexpr(11, 11)  // 1
    };

    alignas(32) static constexpr float BEZIER_STEPS[12] = {-1.0f, -1.4f, -1.5f, -1.5f, -1.5f, 0.0f,
                                                           0.0f,  0.0f,  1.5f,  1.5f,  1.4f,  1.0f};

    alignas(32) static constexpr float BEZIER_HEIGHTS[12] = {0.0f, 0.0f, 0.9f, 0.9f, 0.9f, 0.9f,
                                                             0.9f, 1.1f, 1.1f, 1.1f, 0.0f, 0.0f};

    // The swing's furthest reach along the stroke, in half strokes: its control points overshoot the stroke's ends, so
    // it reaches 1.37. And the swing at SWING_SAMPLES + 1 phases: how far along the stroke, in half strokes, and how
    // high, in step heights.
    static constexpr float SWING_OVERSHOOT = bezierPeak(BEZIER_STEPS);
    static constexpr int SWING_SAMPLES = 64;
    static constexpr auto SWING_ALONG = bezierSamples<SWING_SAMPLES>(BEZIER_STEPS);
    static constexpr auto SWING_LIFT = bezierSamples<SWING_SAMPLES>(BEZIER_HEIGHTS);

    // Per variant, from its leg (configure): the squared distances from a leg's mount within which a foot is reachable
    // with the knee bent at least MIN_KNEE_BEND_DEG, and beyond which with it bent at most MAX_KNEE_BEND_DEG; and how
    // far the crawl shifts the body.
    float reach_out_sq = 0, reach_in_sq = 0, crawl_shift = 0;
    // This tick's share of the commanded stroke and crawl shift, and its step height, that keep every foot in reach.
    float reach_scale = 1, swing_height = 0;
    float max_joint_speed_deg_s = MAX_JOINT_SPEED_DEG_S;

  public:
    WalkState() = default;

    void configure(const KinConfig &config) override {
        MotionState::configure(config);
        gait_state.step_height = target_gait_state.step_height = config.default_step_height;
        gait_state.step_depth = target_gait_state.step_depth = config.default_step_depth;
        // Kinematics::legIK's femur sits coxa_offset along the leg's plane, which lies coxa from the mount, so the
        // femur-to-foot distance H keeps sqrt(|foot - mount|^2 - coxa^2) - coxa_offset <= H <= sqrt(|foot - mount|^2 -
        // coxa^2), the upper bound while the foot lies more than half the coxa offset along that plane, as a standing
        // leg's does: these spheres bound the reach on the safe side, and exactly where coxa_offset is 0. The crawl
        // shifts the body to the middle of three feet: a third of the way from the centre away from the fourth.
        const auto femur_to_foot = [&](float knee_bend_deg) {
            return std::sqrt(config.femur * config.femur + config.tibia * config.tibia +
                             2 * config.femur * config.tibia * std::cos(knee_bend_deg * DEG2RAD_F));
        };
        const float outer = femur_to_foot(MIN_KNEE_BEND_DEG);
        const float inner = femur_to_foot(MAX_KNEE_BEND_DEG) + config.coxa_offset;
        reach_out_sq = config.coxa * config.coxa + outer * outer;
        reach_in_sq = config.coxa * config.coxa + inner * inner;
        crawl_shift = 0;
        for (int leg = 0; leg < 4; leg++)
            crawl_shift = std::max(crawl_shift, std::hypot(config.default_feet_positions[leg][0],
                                                           config.default_feet_positions[leg][2]) / 3);
    }

    void resetSmoothing() override {
        MotionState::resetSmoothing();
        gait_dampers = {};
    }
    const char *name() const override { return "Bezier"; }

    // A walk starts from the stand's feet, every one down on its spot: with no stroke, at the start of the cycle.
    void begin() override {
        MotionState::begin();
        gait_state.step_x = gait_state.step_z = gait_state.step_angle = 0;
        restartCycle();
        if (requested_gait) takeRequestedGait();
    }

    void set_mode_crawl(float duty = CRAWL_DUTY, std::array<int, 4> order = {3, 0, 2, 1}) {
        std::array<float, 4> offsets;
        const float base[4] = {0.f, 0.25f, 0.5f, 0.75f};
        for (int i = 0; i < 4; ++i) offsets[order[i]] = base[i];
        schedule(WALK_GAIT::CRAWL, CRAWL_FACTOR, duty, offsets);
    }

    void set_mode_trot(float duty = TROT_DUTY, std::array<float, 4> offsets = {0.f, 0.5f, 0.5f, 0.f}) {
        for (float &offset : offsets) offset = std::fmod(std::fabs(offset), 1.f);
        schedule(WALK_GAIT::TROT, TROT_FACTOR, duty, offsets);
    }

    /**
     * AUTO: the walk picks its gait from the command (selectAutoGait). It swaps the schedule only at a standstill on
     * all four feet, since a swap reassigns every leg's phase, which mid-stride lifts a loaded foot or drops a swinging
     * one; a command that leaves the band of the gait in force mid-walk brings the walk to a stop first, and it walks
     * on in the other gait. A start waits AUTO_SETTLE_S, as a stick pushed from the centre passes through the crawl's
     * band on its way.
     */
    void set_auto_gait(bool on) {
        auto_gait = on;
        if (on) requested_gait.reset();
    }

    /**
     * The gait the app chose: taken at once while every foot is down and the stroke is zero, and otherwise, for the
     * same reason as AUTO's swap, the walk comes to a stop on all four feet first, takes it and walks on. The gait in
     * force chosen again keeps the step and drops a swap still waiting.
     * Whichever way the trot was chosen, it centres the body and walks only once it is within TROT_CENTRED_M: the
     * crawl leaves the body over three feet, and the trot's reach bound leaves no room for a shift.
     */
    void select_gait(WALK_GAIT gait) {
        requested_gait = gait;
        if (gait == mode || standsStill()) takeRequestedGait();
    }
    static constexpr float AUTO_SETTLE_S = 0.25f, TROT_CENTRED_M = 0.001f;
    /** The schedule the legs walk, also the one AUTO picked. */
    WALK_GAIT gait() const { return mode; }

    /**
     * The gait's phase, 0 to 1, its steps after the command smoothing, and the share of the stroke and the step height
     * the legs' reach left this tick.
     */
    float phase() const { return phase_time; }
    const gait_state_t &steps() const { return gait_state; }
    float strokeShare() const { return reach_scale; }
    float swingHeight() const { return swing_height; }

    /** Which feet are in stance at the current phase, so on the floor. */
    std::array<bool, 4> stance() const { return stanceAt(phase_time); }

    /** Whether the walk stands still: no stroke, and every foot down. It holds its phase from then on. */
    bool standsStill() const { return !moving(gait_state) && !swinging(phase_time); }

    // The period the stop is stepped ahead at, and the longest stop it follows: the host test's trots stop in 0.9 s.
    static constexpr float STOP_PREDICTION_DT_S = 0.02f;
    static constexpr int STOP_PREDICTION_STEPS = 100;

    /**
     * The step the body would still take, in the frame it faces now, were the sticks centred now: the stroke eases out
     * through the gait's dampers and the cycle walks on until the walk stands still, as advance() would take them,
     * stepped ahead every STOP_PREDICTION_DT_S, and the odometry's fit of the feet on the floor gives the body's
     * motion. A planted foot slides home with the stroke as it eases out, and carries the body back with it; one that
     * lifts before the walk stands steps on. The stroke keeps within the length the legs' reach allows it now, as
     * boundToReach() keeps one that eases out the way it points; the body's own shift, the crawl's sway, is left out.
     */
    BodyStep stopStep(const body_state_t &body) const {
        GaitDampers dampers = gait_dampers;
        gait_state_t gait = gait_state;
        float phase = phase_time;
        body_state_t feet = body;
        const auto longest = [&] {
            float stroke = 0;
            for (int leg = 0; leg < 4; leg++) {
                const auto [stroke_x, stroke_z] = strokeOf(gait, leg);
                stroke = std::max(stroke, std::hypot(stroke_x, stroke_z));
            }
            return stroke;
        };
        const float reach = reach_scale * longest();
        const auto planted = [&] {
            const std::array<bool, 4> down = stanceAt(phase);
            const float stroke = longest(), scale = stroke > reach ? reach / stroke : 1;
            for (int leg = 0; leg < 4; leg++) {
                if (!down[leg]) continue;
                const auto [stroke_x, stroke_z] = strokeOf(gait, leg);
                const float along = scale * (0.5f - std::fmod(phase + phase_offset[leg], 1.0f) / stand_offset);
                feet.feet[leg][0] = kin->default_feet_positions[leg][0] + along * stroke_x;
                feet.feet[leg][1] = kin->default_feet_positions[leg][1];
                feet.feet[leg][2] = kin->default_feet_positions[leg][2] + along * stroke_z;
            }
            return down;
        };
        KinematicOdometry odometry;
        odometry.update(feet, planted());
        const float dt = STOP_PREDICTION_DT_S;
        for (int i = 0; i < STOP_PREDICTION_STEPS && (moving(gait) || swinging(phase)); i++) {
            gait.step_x = dampers.step_x.step(gait.step_x, 0, dt, smoothing_omega);
            gait.step_z = dampers.step_z.step(gait.step_z, 0, dt, smoothing_omega);
            gait.step_angle = dampers.step_angle.step(gait.step_angle, 0, dt, smoothing_omega);
            if (moving(gait) || swinging(phase))
                phase = std::fmod(phase + dt * std::max(gait.step_velocity, 0.5f) * speed_factor, 1.0f);
            odometry.update(feet, planted());
        }
        const OdometryEstimate &rest = odometry.estimate();
        return {rest.x, rest.y, rest.yaw};
    }

    /**
     * Stances per second at the command's speed `s`. A stance sweeps a foot through the whole stroke, so a full stick
     * moves the body max_step_length per stance, and turns it by about a radian.
     */
    float stanceRate(float s) const { return std::max(s, 0.5f) * speed_factor / stand_offset; }

    // The fastest the walk turns a joint: a quarter below the servos' limit, which follows their supply
    // (servo_output.h). The MG92B's ratings are unloaded; it slows under load, and the steps must not hit the servos'
    // own limit. MAX_JOINT_SPEED_DEG_S is the cap at the default supply, which the walk keeps until told another.
    static constexpr float JOINT_SPEED_SHARE = 0.75f;
    static constexpr float MAX_JOINT_SPEED_DEG_S = JOINT_SPEED_SHARE * SERVO_MAX_SPEED_DEG_S;

    /** Caps the joints at JOINT_SPEED_SHARE of the servos' speed limit (deg/s); from the next tick on. */
    void useServoSpeedLimit(float limit) { max_joint_speed_deg_s = JOINT_SPEED_SHARE * limit; }
    float maxJointSpeed() const { return max_joint_speed_deg_s; }

    // The bends the walk keeps every knee between: short of straight, where the kinematics clamp a foot beyond reach,
    // and a degree short of the full-size robot's tibia folding onto its femur (its URDF's 2.6 rad, 149 degrees), the
    // tightest knee of the variants.
    static constexpr float MIN_KNEE_BEND_DEG = 10, MAX_KNEE_BEND_DEG = 148;

    /**
     * One tick of the walk, slowed where it would turn a joint faster than maxJointSpeed(): the walk's own clock
     * (its phase and its command smoothing) then runs only the most 64ths of the tick the joints can follow, found by
     * bisection. A long or high step so keeps its shape and takes longer, while a step the servos can follow is walked
     * as commanded. A jump that even a 64th of the tick does not keep under the limit (a foot lifted to its hip) is
     * walked at full time: creeping up to it would freeze the walk.
     */
    void step(body_state_t &body_state, float dt = 0.02f) override {
        if (!holdsForGait(body_state, dt)) return limitedStep(body_state, dt);
        const gait_state_t commanded = target_gait_state;
        target_gait_state.step_x = target_gait_state.step_z = target_gait_state.step_angle = 0;
        limitedStep(body_state, dt);
        target_gait_state.step_x = commanded.step_x;
        target_gait_state.step_z = commanded.step_z;
        target_gait_state.step_angle = commanded.step_angle;
    }

  protected:
    static constexpr int SLOWDOWN_PARTS = 64;

    void limitedStep(body_state_t &body_state, float dt) {
        Kinematics kinematics(*kin);
        float before[12];
        kinematics.calculate_inverse_kinematics(body_state, before);
        const WalkState start = *this;
        const body_state_t start_body = body_state;
        const auto followable = [&](int parts) {
            *this = start;
            body_state = start_body;
            advance(body_state, dt * parts / SLOWDOWN_PARTS);
            float after[12];
            kinematics.calculate_inverse_kinematics(body_state, after);
            for (int joint = 0; joint < 12; joint++)
                if (std::fabs(after[joint] - before[joint]) > max_joint_speed_deg_s * dt) return false;
            return true;
        };
        if (followable(SLOWDOWN_PARTS)) return;
        int fast_enough = 0, too_fast = SLOWDOWN_PARTS;
        while (too_fast - fast_enough > 1) {
            const int parts = (fast_enough + too_fast) / 2;
            (followable(parts) ? fast_enough : too_fast) = parts;
        }
        followable(fast_enough > 0 ? fast_enough : SLOWDOWN_PARTS);
    }

    // A new schedule restarts the cycle: the phase the walk held, read with the new offsets, can put a foot in the air,
    // which then went up in one tick. The same schedule again keeps its phase.
    void schedule(WALK_GAIT gait, float factor, float duty, const std::array<float, 4> &offsets) {
        const bool changed =
            gait != mode || duty != stand_offset || !std::equal(offsets.begin(), offsets.end(), phase_offset);
        mode = gait;
        speed_factor = factor;
        stand_offset = duty;
        std::copy(offsets.begin(), offsets.end(), phase_offset);
        if (changed) restartCycle();
    }

    // Phase 0 has every foot of either gait down (no offset passes its duty), and no crawl shift is under way.
    void restartCycle() {
        phase_time = 0;
        shift_state = {};
    }

    void advance(body_state_t &body_state, float dt) {
        follow(body_dampers.ym, body_state.ym, target_body_state.ym, dt);
        if (mode != WALK_GAIT::CRAWL) {
            follow(body_dampers.xm, body_state.xm, 0, dt);
            follow(body_dampers.zm, body_state.zm, 0, dt);
        }
        follow(body_dampers.psi, body_state.psi, target_body_state.psi, dt);
        followStepHeight(dt);
        const float stroke = auto_gait && mode == WALK_GAIT::CRAWL ? AUTO_CRAWL_STROKE : 1;
        follow(gait_dampers.step_x, gait_state.step_x, stroke * target_gait_state.step_x, dt);
        follow(gait_dampers.step_z, gait_state.step_z, stroke * target_gait_state.step_z, dt);
        gait_state.step_velocity = target_gait_state.step_velocity;
        follow(gait_dampers.step_angle, gait_state.step_angle, stroke * target_gait_state.step_angle, dt);
        follow(gait_dampers.step_depth, gait_state.step_depth, target_gait_state.step_depth, dt);

        updatePhase(dt);
        boundToReach(body_state.ym);
        updateBodyPosition(body_state, dt);
        updateFeetPositions(body_state);
    }

    // A new step height moves only the feet in the air: taken in one tick, it moved a raised foot by the whole change,
    // so it eases while one is up, and is taken at once while every foot is down.
    void followStepHeight(float dt) {
        if (getLegStates().swing_count > 0)
            return follow(gait_dampers.step_height, gait_state.step_height, target_gait_state.step_height, dt);
        gait_state.step_height = target_gait_state.step_height;
        gait_dampers.step_height = {};
    }

    // A foot's stroke: the rigid-body velocity field at its stance position, the commanded translation plus the
    // rotational contribution omega x r about the body centre.
    std::array<float, 2> strokeOf(const gait_state_t &gait, const int index) const {
        const float rx = kin->default_feet_positions[index][0];
        const float rz = kin->default_feet_positions[index][2];
        return {gait.step_x + gait.step_angle * -rz, gait.step_z + gait.step_angle * rx};
    }

    std::array<bool, 4> stanceAt(float phase) const {
        std::array<bool, 4> feet;
        for (int i = 0; i < 4; ++i) feet[i] = std::fmod(phase + phase_offset[i], 1.0f) <= stand_offset;
        return feet;
    }

    bool swinging(float phase) const {
        const std::array<bool, 4> down = stanceAt(phase);
        return !std::all_of(down.begin(), down.end(), [](bool foot) { return foot; });
    }

    /**
     * The share of the commanded stroke and crawl shift, and the step height, that keep every foot of the stance and
     * the swing within reach at this body height: between the spheres about each mount that configure() derives, and
     * below the hip. The crawl's shift moves the mount by up to crawl_shift, any way.
     * The stroke and the shift shrink together until every foot's path, up to SWING_OVERSHOOT half strokes either side
     * of its default spot, keeps inside the outer sphere at the stance's dip. On a body so low that a foot right under
     * its mount would be inside the inner sphere, they also shrink until the foot keeps from passing in under the
     * mount; no variant's lowest body is that low, and a body sinking past that height would cut a sideways stroke at
     * once.
     * Then the step height drops until the swing, at each of its SWING_SAMPLES phases, keeps outside the inner sphere.
     * That also keeps a foot that passes in under its mount more than a coxa below it, where the hip turns past 90
     * degrees. Against the inner sphere only the foot's sideways offset from the mount counts.
     * A command that fits is walked as given.
     */
    void boundToReach(const float body_height) {
        const float coxa = kin->coxa;
        const float shift = mode == WALK_GAIT::CRAWL ? crawl_shift : 0;
        const float deepest = body_height + gait_state.step_depth;
        const float room = std::sqrt(std::max(0.f, reach_out_sq - deepest * deepest));
        // The least sideways offset from the mount that keeps a foot on the ground outside the inner sphere.
        const float least_offset = std::sqrt(std::max(0.f, reach_in_sq - body_height * body_height));
        // Per leg, the half stroke and the share of it that points away from the body.
        float half[4], outward[4];
        reach_scale = coxa < room && least_offset <= coxa ? 1 : 0;
        for (int leg = 0; leg < 4; leg++) {
            const auto [stroke_x, stroke_z] = strokeOf(gait_state, leg);
            const float stroke = std::hypot(stroke_x, stroke_z);
            const float side = kin->default_feet_positions[leg][2] > 0 ? 1 : -1;
            half[leg] = stroke / 2;
            outward[leg] = stroke > 0 ? side * stroke_z / stroke : 0;
            const float reach = SWING_OVERSHOOT * half[leg], sideways = std::fabs(outward[leg]);
            // The largest share k with sqrt(coxa^2 + 2 coxa sideways k reach + (k reach)^2) + k shift <= room.
            const float a = reach * reach - shift * shift, b = coxa * sideways * reach + room * shift;
            const float c = coxa * coxa - room * room;
            const float discriminant = b * b - a * c;
            if (c < 0 && (reach > 0 || shift > 0) && discriminant >= 0)
                reach_scale = std::min(reach_scale, -c / (b + std::sqrt(discriminant)));
            const float inward = sideways * reach + shift;
            if (least_offset > 0 && inward > 0)
                reach_scale = std::min(reach_scale, (coxa - least_offset) / inward);
        }
        swing_height = gait_state.step_height;
        for (int leg = 0; leg < 4; leg++)
            for (int sample = 1; sample < SWING_SAMPLES; sample++) {
                const float offset =
                    coxa + reach_scale * (half[leg] * SWING_ALONG[sample] * outward[leg] - shift);
                const float clear = std::sqrt(std::max(0.f, reach_in_sq - (offset > 0 ? offset * offset : 0)));
                swing_height = std::min(swing_height, std::max(0.f, body_height - clear) / SWING_LIFT[sample]);
            }
    }

    void handleCommand(const CommandMsg &cmd) override {
        target_body_state.ym = kin->min_body_height + cmd.h * kin->body_height_range;
        target_body_state.psi = cmd.ry * kin->max_pitch;
        target_gait_state.step_height = cmd.s1 * kin->max_step_height;
        target_gait_state.step_x = cmd.ly * kin->max_step_length;
        target_gait_state.step_z = -cmd.lx * kin->max_step_length;
        target_gait_state.step_velocity = cmd.s;
        target_gait_state.step_angle = cmd.rx;
        target_gait_state.step_depth = kin->default_step_depth;
    }

    static inline bool isZero(float num) { return std::fabs(num) < 0.001; }

    static bool moving(const gait_state_t &gait) {
        return !isZero(gait.step_x) || !isZero(gait.step_z) || !isZero(gait.step_angle);
    }

    void takeRequestedGait() {
        if (*requested_gait == WALK_GAIT::CRAWL)
            set_mode_crawl();
        else
            set_mode_trot();
        requested_gait.reset();
    }

    // Whether the walk is held to a standstill this tick: for a gait chosen mid-stride (select_gait), by AUTO, or for a
    // trot's body to centre.
    bool holdsForGait(const body_state_t &body_state, float dt) {
        if (requested_gait) {
            if (!standsStill()) return true;
            takeRequestedGait();
        }
        return auto_gait ? autoHolds(body_state, dt) : offCentreForTrot(body_state);
    }

    bool offCentreForTrot(const body_state_t &body_state) const {
        return mode == WALK_GAIT::TROT && std::hypot(body_state.xm, body_state.zm) > TROT_CENTRED_M;
    }

    // Whether AUTO holds the walk to a standstill this tick (set_auto_gait), swapping the schedule once it stands.
    // The new schedule restarts the cycle (schedule), and a foot stands on its own spot while the stroke is zero.
    bool autoHolds(const body_state_t &body_state, float dt) {
        const float demand =
            std::max(std::hypot(target_gait_state.step_x, target_gait_state.step_z) / kin->max_step_length,
                     std::fabs(target_gait_state.step_angle));
        if (demand == 0) {
            auto_settled_s = 0;
            return false;
        }
        const WALK_GAIT next = selectAutoGait(demand, mode);
        if (!standsStill()) return next != mode;
        if (auto_settled_s < AUTO_SETTLE_S) {
            auto_settled_s += dt;
            return true;
        }
        if (next != mode) {
            if (next == WALK_GAIT::CRAWL)
                set_mode_crawl();
            else
                set_mode_trot();
        }
        return offCentreForTrot(body_state);
    }

    // A stopped walk holds its phase once every foot is down; a foot still in the air lands along the rest of its
    // swing first, where resetting the phase dropped it from its full height in one tick.
    void updatePhase(float dt) {
        if (standsStill()) return;
        const float velocity = std::max(gait_state.step_velocity, 0.5f);
        phase_time = std::fmod(phase_time + dt * velocity * speed_factor, 1.0f);
    }

    LegStates getLegStates() {
        LegStates states;
        float min_time_to_swing = INFINITY;

        for (int i = 0; i < 4; i++) {
            float phase = std::fmod(phase_time + phase_offset[i], 1.0f);

            if (phase <= stand_offset) {
                states.stance[states.stance_count++] = i;
                float time_to_swing = stand_offset - phase;
                if (time_to_swing < min_time_to_swing) {
                    min_time_to_swing = time_to_swing;
                    states.next_swing = i;
                }
            } else {
                states.swing[states.swing_count++] = i;
            }
        }

        states.time_to_lift = min_time_to_swing;
        return states;
    }

    std::array<float, 3> stanceCentroid(const LegStates &states) {
        if (states.stance_count == 0) {
            return {0.0f, 0.0f, 0.0f};
        }

        float sx = 0.0f, sz = 0.0f;
        int remaining_count = 0;

        for (int i = 0; i < states.stance_count; i++) {
            int leg = states.stance[i];
            if (leg != states.next_swing) {
                sx += kin->default_feet_positions[leg][0];
                sz += kin->default_feet_positions[leg][2];
                remaining_count++;
            }
        }

        if (remaining_count > 0) {
            return {sx / remaining_count, 0.0f, sz / remaining_count};
        }

        return {0.0f, 0.0f, 0.0f};
    }

    static float lerp(float a, float b, float t) { return a + (b - a) * t; }

    void updateBodyPosition(body_state_t &body_state, float dt) {
        if (mode != WALK_GAIT::CRAWL) return;
        shiftTowardsSupport(body_state);
        // A shift the bound has shrunk since shrinks with it, also while a foot is in the air.
        const float shifted = std::hypot(body_state.xm, body_state.zm), allowed = reach_scale * crawl_shift;
        if (shifted > allowed) {
            body_state.xm *= allowed / shifted;
            body_state.zm *= allowed / shifted;
        }
    }

    void shiftTowardsSupport(body_state_t &body_state) {
        if (!moving(gait_state)) return;

        LegStates leg_states = getLegStates();

        if (leg_states.stance_count >= 3 && leg_states.swing_count == 0 && leg_states.next_swing != -1) {
            if (shift_state.current_shift_leg != leg_states.next_swing) {
                shift_state.current_shift_leg = leg_states.next_swing;
                shift_state.start_x = body_state.xm;
                shift_state.start_z = body_state.zm;

                auto target = stanceCentroid(leg_states);
                shift_state.target_x = target[0];
                shift_state.target_z = target[2];

                shift_state.start_time = leg_states.time_to_lift;
            }

            float total_time = shift_state.start_time;
            float progress = total_time > 0 ? 1.0f - (leg_states.time_to_lift / total_time) : 1.0f;
            float smooth_progress = smoothstep01(std::clamp(progress, 0.0f, 1.0f));

            body_state.xm = lerp(shift_state.start_x, reach_scale * shift_state.target_x, smooth_progress);
            body_state.zm = lerp(shift_state.start_z, reach_scale * shift_state.target_z, smooth_progress);
        }
    }

    static float smoothstep01(float t) {
        const float x = std::clamp(t, 0.f, 1.f);
        return x * x * (3.f - 2.f * x);
    }

    void updateFeetPositions(body_state_t &body_state) {
        for (int i = 0; i < 4; ++i) updateFootPosition(body_state, i);
    }

    void updateFootPosition(body_state_t &body_state, const int index) {
        body_state.feet[index][0] = kin->default_feet_positions[index][0];
        body_state.feet[index][1] = kin->default_feet_positions[index][1];
        body_state.feet[index][2] = kin->default_feet_positions[index][2];
        const float leg_phase = std::fmod(phase_time + phase_offset[index], 1.0f);
        const bool contact = leg_phase <= stand_offset;
        if (contact)
            standController(body_state, index, leg_phase / stand_offset);
        else
            swingController(body_state, index, (leg_phase - stand_offset) / (1.f - stand_offset));
    }

    void standController(body_state_t &body_state, const int index, const float phase) {
        controller(index, body_state, phase, stanceCurve, &gait_state.step_depth);
    }

    void swingController(body_state_t &body_state, const int index, const float phase) {
        controller(index, body_state, phase, bezierCurve, &swing_height);
    }

    void controller(const int index, body_state_t &body_state, const float phase,
                    std::function<void(float, float, float *, float, float *)> curve, float *arg) {
        float delta[3] = {0};

        // Composing the translation and the rotation into one stroke means a single curve, so the swing/stance profile
        // is applied once.
        const auto [stroke_x, stroke_z] = strokeOf(gait_state, index);
        const float stroke = reach_scale * std::hypot(stroke_x, stroke_z);

        curve(stroke * 0.5f, std::atan2(stroke_z, stroke_x), arg, phase, delta);

        body_state.feet[index][0] += delta[0];
        body_state.feet[index][1] += delta[1];
        body_state.feet[index][2] += delta[2];
    }

    static void stanceCurve(const float length, const float angle, const float *depth, const float phase,
                            float *point) {
        float step = length * (1.0f - 2.0f * phase);
        point[0] += step * std::cos(angle);
        point[2] += step * std::sin(angle);
        // Deepest mid-stance and level at both ends, along the stroke whatever its direction.
        if (length != 0.0f) point[1] = -*depth * std::cos((M_PI * step) / (2.f * length));
    }

    static void bezierCurve(const float length, const float angle, const float *height, const float phase,
                            float *point) {
        const float X_POLAR = std::cos(angle);
        const float Z_POLAR = std::sin(angle);

        // The powers by multiplication only: (1 - t)^11 divided back up underflows near the end of a swing (to zero
        // with -Ofast), which put the foot back on its stance spot for a tick.
        float phase_powers[BEZIER_POINTS], rest_powers[BEZIER_POINTS];
        phase_powers[0] = rest_powers[0] = 1.0f;
        for (int i = 1; i < BEZIER_POINTS; i++) {
            phase_powers[i] = phase_powers[i - 1] * phase;
            rest_powers[i] = rest_powers[i - 1] * (1.0f - phase);
        }

        for (int i = 0; i < BEZIER_POINTS; i++) {
            float b = COMBINATORIAL_VALUES[i] * phase_powers[i] * rest_powers[BEZIER_POINTS - 1 - i];
            point[0] += b * BEZIER_STEPS[i] * length * X_POLAR;
            point[1] += b * BEZIER_HEIGHTS[i] * *height;
            point[2] += b * BEZIER_STEPS[i] * length * Z_POLAR;
        }
    }
};
