runeharlyk/SpotMicroESP32-Leika/esp32/include/settings/camera_settings.h

#pragma once

#include <sdkconfig.h>
#include <platform_shared/api.pb.h>

#if !CONFIG_IDF_TARGET_ESP32P4
#include <esp_camera.h>
#else
#define PIXFORMAT_JPEG 0
#define FRAMESIZE_VGA 0
#define GAINCEILING_2X 0
#endif

namespace Camera {

using CameraSettings = api_CameraSettings;

inline CameraSettings CameraSettings_defaults() {
    CameraSettings settings = api_CameraSettings_init_zero;
    settings.pixformat = PIXFORMAT_JPEG;
    settings.framesize = FRAMESIZE_VGA;
    settings.quality = 12;
    settings.brightness = 0;
    settings.contrast = 0;
    settings.saturation = 0;
    settings.sharpness = 0;
    settings.denoise = 0;
    settings.gainceiling = GAINCEILING_2X;
    settings.whitebal = 1;
    settings.special_effect = 0;
    settings.wb_mode = 0;
    settings.awb = 1;
    settings.exposure_ctrl = 1;
    settings.awb_gain = 1;
    settings.gain_ctrl = 1;
    settings.aec = 1;
    settings.aec2 = 0;
    settings.ae_level = 0;
    settings.aec_value = 300;
    settings.agc = 1;
    settings.agc_gain = 0;
    settings.bpc = 0;
    settings.wpc = 1;
    settings.raw_gma = 1;
    settings.lenc = 1;
    settings.hmirror = 0;
    settings.vflip = 0;
    settings.dcw = 1;
    settings.colorbar = 0;
    return settings;
}

// Proto read/update are identity functions since type is the same
inline void CameraSettings_read(const CameraSettings& settings, CameraSettings& proto) {
    proto = settings;
}

inline StateUpdateResult CameraSettings_update(const CameraSettings& proto, CameraSettings& settings) {
    settings = proto;
    return StateUpdateResult::CHANGED;
}

} // namespace Camera
