runeharlyk/SpotMicroESP32-Leika/esp32/include/robot_service.h

#pragma once

#include <template/stateful_service.h>
#include <template/stateful_persistence.h>
#include <settings/robot_settings.h>

class RobotService : public StatefulService<RobotSettings> {
  public:
    RobotService();

    void begin();

    std::string name() const {
        std::string name;
        read([&name](const RobotSettings &settings) { name = settings.name; });
        return name;
    }

    KinematicsVariant variant() const {
        KinematicsVariant variant;
        read([&variant](const RobotSettings &settings) { variant = settings.variant; });
        return variant;
    }

    /** Returns false when the name is invalid; the stored name is then unchanged. */
    bool rename(const char *name);

    /** Stores a variant this firmware drives; returns false for any other, which leaves the stored one. */
    bool chooseVariant(KinematicsVariant variant);

  private:
    FSPersistencePB<RobotSettings> _persistence;
};
