runeharlyk/SpotMicroESP32-Leika/esp32/src/peripherals/camera_service.cpp

#include <peripherals/camera_service.h>
#include <communication/webserver.h>
#include <esp_heap_caps.h>
#include <freertos/queue.h>
#include <atomic>

namespace Camera {

static const char *const TAG = "CameraService";

#if USE_DVP_CAMERA || USE_CSI_CAMERA
static constexpr const char *_STREAM_CONTENT_TYPE = "multipart/x-mixed-replace;boundary=" PART_BOUNDARY;
static constexpr const char *_STREAM_BOUNDARY = "\r\n--" PART_BOUNDARY "\r\n";
static constexpr const char *_STREAM_PART = "Content-Type: image/jpeg\r\nContent-Length: %u\r\n\r\n";

// A JPEG frame from the camera, held until giveFrame(); each camera below defines the pair. takeFrame fails when the
// camera gives no frame, which ends every stream; a frame of no bytes is skipped.
struct Frame {
    const uint8_t *data = nullptr;
    size_t len = 0;
};
static bool takeFrame(Frame &frame);
static void giveFrame();

// esp_http_server serves every socket from one task, so a stream looping in its handler held that task for as long as
// anyone watched and left every other request unread, the WebSocket's commands among them (Hexapod f79fb2f, 71eaaa7).
// The handler hands each viewer to one worker instead, which takes each frame once and writes it to all of them; a
// viewer past MAX_VIEWERS is refused. A viewer whose send fails, or stalls past the server's send timeout, is dropped,
// and holds the others back until then.
static constexpr int MAX_VIEWERS = 3;
static QueueHandle_t s_new_viewers = nullptr;
static std::atomic<int> s_viewers {0};

static esp_err_t sendFrame(httpd_req_t *viewer, const char *part, int partLen, const Frame &frame) {
    esp_err_t res = httpd_resp_send_chunk(viewer, part, partLen);
    if (res == ESP_OK) res = httpd_resp_send_chunk(viewer, (const char *)frame.data, frame.len);
    if (res == ESP_OK) res = httpd_resp_send_chunk(viewer, _STREAM_BOUNDARY, strlen(_STREAM_BOUNDARY));
    return res;
}

static void streamWorker(void *) {
    httpd_req_t *watching[MAX_VIEWERS];
    int count = 0;
    const auto drop = [&](int i) {
        httpd_req_async_handler_complete(watching[i]);
        watching[i] = watching[--count];
        s_viewers--;
    };
    char part[64];
    for (;;) {
        httpd_req_t *viewer = nullptr;
        // Asleep while nobody watches; a newcomer joins at the next frame.
        while (xQueueReceive(s_new_viewers, &viewer, count == 0 ? portMAX_DELAY : 0) == pdTRUE) {
            watching[count++] = viewer;
            if (httpd_resp_set_type(viewer, _STREAM_CONTENT_TYPE) != ESP_OK) drop(count - 1);
        }
        if (count == 0) continue;
        Frame frame;
        if (!takeFrame(frame)) {
            ESP_LOGW(TAG, "Camera capture failed; the streams end");
            while (count > 0) drop(count - 1);
            continue;
        }
        if (frame.len > 0) {
            const int partLen = snprintf(part, sizeof(part), _STREAM_PART, (unsigned)frame.len);
            for (int i = 0; i < count;) {
                if (sendFrame(watching[i], part, partLen, frame) == ESP_OK)
                    ++i;
                else
                    drop(i);
            }
        }
        giveFrame();
    }
}

static void startStreamWorker() {
    s_new_viewers = xQueueCreate(MAX_VIEWERS, sizeof(httpd_req_t *));
    // On core 0 with the web server and lwIP: it only waits on frames and sockets.
    if (!s_new_viewers || xTaskCreatePinnedToCore(streamWorker, "camstream", 4096, nullptr, 5, nullptr, 0) != pdPASS) {
        ESP_LOGE(TAG, "Camera stream worker not started");
        s_new_viewers = nullptr;
    }
}

esp_err_t CameraService::cameraStream(httpd_req_t *request) {
    if (!s_new_viewers) return WebServer::sendError(request, 503, "The camera stream is not running");
    int count = s_viewers.load();
    while (count < MAX_VIEWERS && !s_viewers.compare_exchange_weak(count, count + 1)) {
    }
    if (count >= MAX_VIEWERS) return WebServer::sendError(request, 503, "The camera stream is at its viewer limit");
    httpd_req_t *async = nullptr;
    if (httpd_req_async_handler_begin(request, &async) != ESP_OK) {
        s_viewers--;
        return ESP_FAIL;
    }
    if (xQueueSend(s_new_viewers, &async, 0) != pdTRUE) {
        httpd_req_async_handler_complete(async);
        s_viewers--;
        return ESP_FAIL;
    }
    return ESP_OK;
}
#endif

#if USE_DVP_CAMERA

SemaphoreHandle_t cameraMutex = xSemaphoreCreateMutex();

camera_fb_t *safe_camera_fb_get() {
    camera_fb_t *fb = NULL;
    if (xSemaphoreTakeRecursive(cameraMutex, portMAX_DELAY) == pdTRUE) {
        fb = esp_camera_fb_get();
        xSemaphoreGiveRecursive(cameraMutex);
    }
    return fb;
}

sensor_t *safe_sensor_get() {
    sensor_t *s = NULL;
    if (xSemaphoreTakeRecursive(cameraMutex, portMAX_DELAY) == pdTRUE) {
        s = esp_camera_sensor_get();
    }
    return s;
}

void safe_sensor_return() { xSemaphoreGiveRecursive(cameraMutex); }

CameraService::CameraService()
    : protoHandler(CameraSettings_read, CameraSettings_update, this, api_CameraSettings_fields),
      _persistence(CameraSettings_read, CameraSettings_update, this, CAMERA_SETTINGS_FILE, api_CameraSettings_fields,
                   api_CameraSettings_size, CameraSettings_defaults()) {
    addUpdateHandler([&](const std::string &originId) { updateCamera(); }, false);
}

static_assert(CAMERA_PIXFORMAT_JPEG == PIXFORMAT_JPEG && CAMERA_FRAMESIZE_VGA == FRAMESIZE_VGA &&
                  CAMERA_FRAMESIZE_SVGA == FRAMESIZE_SVGA && CAMERA_GAINCEILING_2X == GAINCEILING_2X,
              "settings/camera_settings.h names pixformat_t's, framesize_t's and gainceiling_t's values");
static_assert(CAMERA_OV2640_PID == OV2640_PID && CAMERA_MEGA_CCM_PID == MEGA_CCM_PID,
              "settings/camera_settings.h names camera_pid_t's values");

esp_err_t CameraService::begin() {
    _persistence.readFromFS();
    camera_config_t camera_config;
    camera_config.ledc_channel = LEDC_CHANNEL_0;
    camera_config.ledc_timer = LEDC_TIMER_0;
    camera_config.pin_d0 = Y2_GPIO_NUM;
    camera_config.pin_d1 = Y3_GPIO_NUM;
    camera_config.pin_d2 = Y4_GPIO_NUM;
    camera_config.pin_d3 = Y5_GPIO_NUM;
    camera_config.pin_d4 = Y6_GPIO_NUM;
    camera_config.pin_d5 = Y7_GPIO_NUM;
    camera_config.pin_d6 = Y8_GPIO_NUM;
    camera_config.pin_d7 = Y9_GPIO_NUM;
    camera_config.pin_xclk = XCLK_GPIO_NUM;
    camera_config.pin_pclk = PCLK_GPIO_NUM;
    camera_config.pin_vsync = VSYNC_GPIO_NUM;
    camera_config.pin_href = HREF_GPIO_NUM;
    camera_config.pin_sccb_sda = SIOD_GPIO_NUM;
    camera_config.pin_sccb_scl = SIOC_GPIO_NUM;
    camera_config.pin_pwdn = PWDN_GPIO_NUM;
    camera_config.pin_reset = RESET_GPIO_NUM;
    camera_config.xclk_freq_hz = 20000000;
    camera_config.pixel_format = PIXFORMAT_JPEG;

    // The frame buffers are sized for this frame size, which bounds every stored one (CameraSettings_problem).
    camera_config.frame_size = static_cast<framesize_t>(CAMERA_BUFFER_FRAMESIZE);
    if (heap_caps_get_total_size(MALLOC_CAP_SPIRAM) > 0) {
        camera_config.jpeg_quality = 10;
        camera_config.fb_location = CAMERA_FB_IN_PSRAM;
        camera_config.fb_count = 2;
        camera_config.grab_mode = CAMERA_GRAB_LATEST;
    } else {
        camera_config.jpeg_quality = 12;
        camera_config.fb_count = 1;
    }

    ESP_LOGI(TAG, "Initializing camera");
    esp_err_t err = esp_camera_init(&camera_config);
    if (err == ESP_OK) {
        ESP_LOGI(TAG, "Camera probe successful");
        // The stored settings were read before the sensor was up, which their update handler needs.
        updateCamera();
        startStreamWorker();
    } else {
        ESP_LOGE(TAG, "Camera probe failed with error 0x%x", err);
    }

    return err;
}

void CameraService::release() {
    if (xSemaphoreTakeRecursive(cameraMutex, portMAX_DELAY) != pdTRUE) return;
    if (esp_camera_deinit() == ESP_OK) ESP_LOGI(TAG, "Camera released");
    xSemaphoreGiveRecursive(cameraMutex);
}

static camera_fb_t *s_fb = nullptr;
static uint8_t *s_converted = nullptr; // a frame in a pixel format other than JPEG, as the settings may choose

static bool takeFrame(Frame &frame) {
    s_fb = safe_camera_fb_get();
    if (!s_fb) return false;
    if (s_fb->format == PIXFORMAT_JPEG) {
        frame = {s_fb->buf, s_fb->len};
        return true;
    }
    size_t len = 0;
    if (!frame2jpg(s_fb, 80, &s_converted, &len)) {
        esp_camera_fb_return(s_fb);
        s_fb = nullptr;
        return false;
    }
    frame = {s_converted, len};
    return true;
}

// The camera grabs the latest frame at once, so the stream takes one every 30 ms at most.
static void giveFrame() {
    free(s_converted);
    s_converted = nullptr;
    esp_camera_fb_return(s_fb);
    s_fb = nullptr;
    vTaskDelay(pdMS_TO_TICKS(30));
}

// Sets each value the sensor does not hold already (sensor_t::status, which every setter updates when it succeeds), so
// an unchanged frame size does not reset the sensor's window and a sensor without sharpness keeps the zero it reports.
// A value the sensor refuses is logged; it stays stored, as the update that stored it passed CameraSettings_refusal.
void CameraService::updateCamera() {
    sensor_t *s = safe_sensor_get();
    if (!s) {
        safe_sensor_return();
        return;
    }
    const CameraSettings settings = snapshot();
    const auto refused = [](const char *name, int value) { ESP_LOGW(TAG, "The sensor refused %s %d", name, value); };
    const auto set = [&](const char *name, int held, int wanted, int (*setter)(sensor_t *, int)) {
        if (held != wanted && setter(s, wanted) != 0) refused(name, wanted);
    };
    const auto pixformat = static_cast<pixformat_t>(settings.pixformat);
    if (s->pixformat != pixformat && s->set_pixformat(s, pixformat) != 0) refused("pixformat", pixformat);
    const auto framesize = static_cast<framesize_t>(settings.framesize);
    if (s->status.framesize != framesize && s->set_framesize(s, framesize) != 0) refused("framesize", framesize);
    const auto gainceiling = static_cast<gainceiling_t>(settings.gainceiling);
    if (s->status.gainceiling != gainceiling && s->set_gainceiling(s, gainceiling) != 0)
        refused("gainceiling", gainceiling);
    set("brightness", s->status.brightness, settings.brightness, s->set_brightness);
    set("contrast", s->status.contrast, settings.contrast, s->set_contrast);
    set("saturation", s->status.saturation, settings.saturation, s->set_saturation);
    set("sharpness", s->status.sharpness, settings.sharpness, s->set_sharpness);
    set("denoise", s->status.denoise, settings.denoise, s->set_denoise);
    set("quality", s->status.quality, settings.quality, s->set_quality);
    set("colorbar", s->status.colorbar, settings.colorbar, s->set_colorbar);
    set("awb_gain", s->status.awb_gain, settings.awb_gain, s->set_awb_gain);
    set("wb_mode", s->status.wb_mode, settings.wb_mode, s->set_wb_mode);
    set("aec2", s->status.aec2, settings.aec2, s->set_aec2);
    set("ae_level", s->status.ae_level, settings.ae_level, s->set_ae_level);
    set("aec_value", s->status.aec_value, settings.aec_value, s->set_aec_value);
    set("agc_gain", s->status.agc_gain, settings.agc_gain, s->set_agc_gain);
    set("bpc", s->status.bpc, settings.bpc, s->set_bpc);
    set("wpc", s->status.wpc, settings.wpc, s->set_wpc);
    set("special_effect", s->status.special_effect, settings.special_effect, s->set_special_effect);
    set("raw_gma", s->status.raw_gma, settings.raw_gma, s->set_raw_gma);
    set("lenc", s->status.lenc, settings.lenc, s->set_lenc);
    set("hmirror", s->status.hmirror, settings.hmirror, s->set_hmirror);
    set("vflip", s->status.vflip, settings.vflip, s->set_vflip);
    set("dcw", s->status.dcw, settings.dcw, s->set_dcw);
    safe_sensor_return();
}

const char *CameraService::refusal(const CameraSettings &settings) {
    const sensor_t *s = safe_sensor_get();
    const char *reason = CameraSettings_refusal(s ? s->id.PID : 0, settings);
    safe_sensor_return();
    return reason;
}

#elif USE_CSI_CAMERA
}

extern "C" {
#include "esp_cam_ctlr.h"
#include "esp_cam_ctlr_csi.h"
#include "esp_cam_ctlr_types.h"
#include "driver/isp.h"
#include "driver/jpeg_encode.h"
#include "esp_sccb_intf.h"
#include "esp_sccb_i2c.h"
#include "esp_cam_sensor.h"
#include "ov5647.h"
#include "esp_ldo_regulator.h"
#include "driver/isp_demosaic.h"
#include "driver/isp_bf.h"
#include "driver/isp_sharpen.h"
}

#include <peripherals/i2c_bus.h>

namespace Camera {

#ifndef MIPI_CSI_HRES
#define MIPI_CSI_HRES 640
#endif
#ifndef MIPI_CSI_VRES
#define MIPI_CSI_VRES 480
#endif
#ifndef MIPI_CSI_LANE_BITRATE_MBPS
#define MIPI_CSI_LANE_BITRATE_MBPS 200
#endif
#ifndef MIPI_CSI_DATA_LANES
#define MIPI_CSI_DATA_LANES 2
#endif
#ifndef CAM_SCCB_FREQ_HZ
#define CAM_SCCB_FREQ_HZ 100000
#endif
#ifndef CAM_SENSOR_ADDR
#define CAM_SENSOR_ADDR 0x36
#endif
#ifndef CAM_XCLK_PIN
#define CAM_XCLK_PIN -1
#endif
#ifndef CAM_XCLK_FREQ_HZ
#define CAM_XCLK_FREQ_HZ 25000000
#endif
#ifndef CAM_RESET_PIN
#define CAM_RESET_PIN -1
#endif
#ifndef CAM_PWDN_PIN
#define CAM_PWDN_PIN -1
#endif
#ifndef CSI_JPEG_QUALITY
#define CSI_JPEG_QUALITY 80
#endif

#define NUM_FRAME_BUFS 2
static constexpr size_t CACHE_LINE_SIZE = 64;
#define ALIGN_UP(n, a) (((n) + ((a) - 1)) & ~((a) - 1))

static esp_cam_ctlr_handle_t s_cam_handle = NULL;
static isp_proc_handle_t s_isp_proc = NULL;
static jpeg_encoder_handle_t s_jpeg_enc = NULL;

static uint8_t *s_frame_bufs[NUM_FRAME_BUFS] = {};
static size_t s_frame_buf_size = 0;
static uint8_t *s_jpeg_bufs[NUM_FRAME_BUFS] = {};
static size_t s_jpeg_buf_alloc = 0;

static bool s_cam_initialized = false;
static uint16_t s_frame_hres = MIPI_CSI_HRES;
static uint16_t s_frame_vres = MIPI_CSI_VRES;

static SemaphoreHandle_t s_frame_done = NULL;
static SemaphoreHandle_t s_jpeg_lock = NULL;
static SemaphoreHandle_t s_jpeg_ready = NULL;
static TaskHandle_t s_capture_task = NULL;
static volatile bool s_capture_running = false;

static int s_write_idx = 0;
static int s_ready_idx = -1;
static size_t s_ready_jpeg_len = 0;

static uint8_t *s_send_buf = NULL;
static size_t s_send_buf_size = 0;

static bool on_trans_finished(esp_cam_ctlr_handle_t handle, esp_cam_ctlr_trans_t *trans, void *user_data) {
    BaseType_t woken = pdFALSE;
    xSemaphoreGiveFromISR(s_frame_done, &woken);
    return (woken == pdTRUE);
}

static void capture_task_fn(void *arg) {
    while (s_capture_running) {
        int idx = s_write_idx;

        esp_cam_ctlr_trans_t trans = {};
        trans.buffer = s_frame_bufs[idx];
        trans.buflen = s_frame_buf_size;

        if (esp_cam_ctlr_receive(s_cam_handle, &trans, 2000) != ESP_OK) {
            vTaskDelay(pdMS_TO_TICKS(5));
            continue;
        }

        if (xSemaphoreTake(s_frame_done, pdMS_TO_TICKS(2000)) != pdTRUE) {
            continue;
        }

        jpeg_encode_cfg_t enc_cfg = {};
        enc_cfg.src_type = JPEG_ENCODE_IN_FORMAT_RGB565;
        enc_cfg.sub_sample = JPEG_DOWN_SAMPLING_YUV420;
        enc_cfg.image_quality = CSI_JPEG_QUALITY;
        enc_cfg.width = s_frame_hres;
        enc_cfg.height = s_frame_vres;

        uint32_t out_size = 0;
        esp_err_t err = jpeg_encoder_process(s_jpeg_enc, &enc_cfg, s_frame_bufs[idx], trans.received_size,
                                             s_jpeg_bufs[idx], s_jpeg_buf_alloc, &out_size);
        if (err != ESP_OK) {
            continue;
        }

        xSemaphoreTake(s_jpeg_lock, portMAX_DELAY);
        s_ready_idx = idx;
        s_ready_jpeg_len = out_size;
        xSemaphoreGive(s_jpeg_lock);

        s_write_idx = (idx + 1) % NUM_FRAME_BUFS;

        xSemaphoreGive(s_jpeg_ready);
    }
    vTaskDelete(NULL);
}

CameraService::CameraService() {
    s_frame_done = xSemaphoreCreateBinary();
    s_jpeg_lock = xSemaphoreCreateMutex();
    s_jpeg_ready = xSemaphoreCreateBinary();
}

esp_err_t CameraService::begin() {
    ESP_LOGI(TAG, "Initializing MIPI-CSI camera for ESP32-P4");

    esp_ldo_channel_handle_t ldo_mipi_phy = NULL;
    esp_ldo_channel_config_t ldo_cfg = {};
    ldo_cfg.chan_id = 3;
    ldo_cfg.voltage_mv = 2500;
    esp_err_t ldo_err = esp_ldo_acquire_channel(&ldo_cfg, &ldo_mipi_phy);
    if (ldo_err != ESP_OK) {
        ESP_LOGE(TAG, "Failed to acquire MIPI PHY LDO: %s", esp_err_to_name(ldo_err));
        return ldo_err;
    }

    i2c_master_bus_handle_t i2c_bus = I2CBus::instance().busHandle();
    if (!i2c_bus) {
        ESP_LOGE(TAG, "I2C bus not initialized, cannot init camera SCCB");
        return ESP_ERR_INVALID_STATE;
    }

    esp_sccb_io_handle_t sccb_io = NULL;
    sccb_i2c_config_t sccb_cfg = {};
    sccb_cfg.scl_speed_hz = CAM_SCCB_FREQ_HZ;
    sccb_cfg.device_address = CAM_SENSOR_ADDR;
    sccb_cfg.dev_addr_length = I2C_ADDR_BIT_LEN_7;

    esp_err_t err = sccb_new_i2c_io(i2c_bus, &sccb_cfg, &sccb_io);
    if (err != ESP_OK) {
        ESP_LOGE(TAG, "Failed to create SCCB I/O handle: %s", esp_err_to_name(err));
        return err;
    }

    esp_cam_sensor_config_t cam_sensor_cfg = {};
    cam_sensor_cfg.sccb_handle = sccb_io;
    cam_sensor_cfg.reset_pin = static_cast<gpio_num_t>(CAM_RESET_PIN);
    cam_sensor_cfg.pwdn_pin = static_cast<gpio_num_t>(CAM_PWDN_PIN);
    cam_sensor_cfg.xclk_pin = static_cast<gpio_num_t>(CAM_XCLK_PIN);
    cam_sensor_cfg.xclk_freq_hz = CAM_XCLK_FREQ_HZ;
    cam_sensor_cfg.sensor_port = ESP_CAM_SENSOR_MIPI_CSI;

    esp_cam_sensor_device_t *cam_sensor = ov5647_detect(&cam_sensor_cfg);
    if (!cam_sensor) {
        ESP_LOGE(TAG, "OV5647 detection failed");
        return ESP_FAIL;
    }
    ESP_LOGI(TAG, "OV5647 camera sensor detected");

    esp_cam_sensor_format_array_t fmt_array = {};
    err = esp_cam_sensor_query_format(cam_sensor, &fmt_array);
    if (err != ESP_OK) {
        ESP_LOGE(TAG, "Failed to query sensor formats: %s", esp_err_to_name(err));
        return err;
    }

    const esp_cam_sensor_format_t *selected_format = NULL;
    uint32_t best_area = 0;
    for (uint32_t i = 0; i < fmt_array.count; i++) {
        const auto &f = fmt_array.format_array[i];
        ESP_LOGI(TAG, "Sensor format[%u]: %dx%d mipi_clk=%uHz lanes=%d", (unsigned)i, f.width, f.height,
                 (unsigned)f.mipi_info.mipi_clk, f.mipi_info.lane_num);
    }
    for (uint32_t i = 0; i < fmt_array.count; i++) {
        const uint16_t w = fmt_array.format_array[i].width;
        const uint16_t h = fmt_array.format_array[i].height;
        if (w <= MIPI_CSI_HRES && h <= MIPI_CSI_VRES) {
            const uint32_t area = (uint32_t)w * (uint32_t)h;
            if (!selected_format || area > best_area) {
                selected_format = &fmt_array.format_array[i];
                best_area = area;
            }
        }
    }
    if (!selected_format && fmt_array.count > 0) {
        uint32_t min_area = UINT32_MAX;
        for (uint32_t i = 0; i < fmt_array.count; i++) {
            const uint32_t area =
                (uint32_t)fmt_array.format_array[i].width * (uint32_t)fmt_array.format_array[i].height;
            if (area < min_area) {
                selected_format = &fmt_array.format_array[i];
                min_area = area;
            }
        }
    }
    if (!selected_format) {
        ESP_LOGE(TAG, "No sensor formats available");
        return ESP_FAIL;
    }

    err = esp_cam_sensor_set_format(cam_sensor, selected_format);
    if (err != ESP_OK) {
        ESP_LOGE(TAG, "Failed to set sensor format: %s", esp_err_to_name(err));
        return err;
    }

    s_frame_hres = selected_format->width;
    s_frame_vres = selected_format->height;
    ESP_LOGI(TAG, "Sensor format set: %dx%d", s_frame_hres, s_frame_vres);

    esp_cam_sensor_format_t cur_fmt = {};
    if (esp_cam_sensor_get_format(cam_sensor, &cur_fmt) == ESP_OK) {
        ESP_LOGI(TAG, "Active format: %dx%d, mipi_clk=%uHz, lanes=%d", cur_fmt.width, cur_fmt.height,
                 (unsigned)cur_fmt.mipi_info.mipi_clk, cur_fmt.mipi_info.lane_num);
    }

    int stream_on = 1;
    err = esp_cam_sensor_ioctl(cam_sensor, ESP_CAM_SENSOR_IOC_S_STREAM, &stream_on);
    if (err != ESP_OK) {
        ESP_LOGE(TAG, "Failed to start sensor stream: %s", esp_err_to_name(err));
        return err;
    }

    esp_isp_processor_cfg_t isp_cfg = {};
    isp_cfg.clk_src = static_cast<isp_clk_src_t>(0);
    isp_cfg.clk_hz = 80 * 1000 * 1000;
    isp_cfg.input_data_source = ISP_INPUT_DATA_SOURCE_CSI;
    isp_cfg.input_data_color_type = ISP_COLOR_RAW8;
    isp_cfg.output_data_color_type = ISP_COLOR_RGB565;
    isp_cfg.has_line_start_packet = false;
    isp_cfg.has_line_end_packet = false;
    isp_cfg.h_res = s_frame_hres;
    isp_cfg.v_res = s_frame_vres;
    isp_cfg.bayer_order = COLOR_RAW_ELEMENT_ORDER_GBRG;

    err = esp_isp_new_processor(&isp_cfg, &s_isp_proc);
    if (err != ESP_OK) {
        ESP_LOGE(TAG, "ISP processor init failed: %s", esp_err_to_name(err));
        return err;
    }

    err = esp_isp_enable(s_isp_proc);
    if (err != ESP_OK) {
        ESP_LOGE(TAG, "ISP enable failed: %s", esp_err_to_name(err));
        return err;
    }

    esp_isp_demosaic_config_t demosaic_cfg = {};
    demosaic_cfg.grad_ratio.val = 16;
    demosaic_cfg.padding_mode = ISP_DEMOSAIC_EDGE_PADDING_MODE_SRND_DATA;
    esp_isp_demosaic_configure(s_isp_proc, &demosaic_cfg);
    esp_isp_demosaic_enable(s_isp_proc);

    esp_isp_bf_config_t bf_cfg = {};
    bf_cfg.denoising_level = 10;
    bf_cfg.padding_mode = ISP_BF_EDGE_PADDING_MODE_SRND_DATA;
    uint8_t bf_tpl[ISP_BF_TEMPLATE_X_NUMS][ISP_BF_TEMPLATE_Y_NUMS] = {{1, 2, 1}, {2, 4, 2}, {1, 2, 1}};
    memcpy(bf_cfg.bf_template, bf_tpl, sizeof(bf_tpl));
    esp_isp_bf_configure(s_isp_proc, &bf_cfg);
    esp_isp_bf_enable(s_isp_proc);

    esp_isp_sharpen_config_t sharp_cfg = {};
    sharp_cfg.h_thresh = 255;
    sharp_cfg.l_thresh = 20;
    sharp_cfg.padding_mode = ISP_SHARPEN_EDGE_PADDING_MODE_SRND_DATA;
    uint8_t sharp_m[ISP_SHARPEN_TEMPLATE_X_NUMS][ISP_SHARPEN_TEMPLATE_Y_NUMS] = {{1, 2, 1}, {2, 4, 2}, {1, 2, 1}};
    memcpy(sharp_cfg.sharpen_template, sharp_m, sizeof(sharp_m));
    sharp_cfg.h_freq_coeff.integer = 1;
    sharp_cfg.h_freq_coeff.decimal = 0;
    sharp_cfg.m_freq_coeff.integer = 1;
    sharp_cfg.m_freq_coeff.decimal = 0;
    esp_isp_sharpen_configure(s_isp_proc, &sharp_cfg);
    esp_isp_sharpen_enable(s_isp_proc);

    esp_cam_ctlr_csi_config_t csi_cfg = {};
    csi_cfg.ctlr_id = 0;
    csi_cfg.h_res = s_frame_hres;
    csi_cfg.v_res = s_frame_vres;
    csi_cfg.lane_bit_rate_mbps = MIPI_CSI_LANE_BITRATE_MBPS;
    csi_cfg.input_data_color_type = CAM_CTLR_COLOR_RAW8;
    csi_cfg.output_data_color_type = CAM_CTLR_COLOR_RGB565;
    csi_cfg.data_lane_num = MIPI_CSI_DATA_LANES;
    csi_cfg.byte_swap_en = false;
    csi_cfg.queue_items = NUM_FRAME_BUFS;

    err = esp_cam_new_csi_ctlr(&csi_cfg, &s_cam_handle);
    if (err != ESP_OK) {
        ESP_LOGE(TAG, "CSI controller init failed: %s", esp_err_to_name(err));
        return err;
    }

    esp_cam_ctlr_evt_cbs_t cbs = {};
    cbs.on_trans_finished = on_trans_finished;
    err = esp_cam_ctlr_register_event_callbacks(s_cam_handle, &cbs, NULL);
    if (err != ESP_OK) {
        ESP_LOGE(TAG, "CSI register callbacks failed: %s", esp_err_to_name(err));
        return err;
    }

    s_frame_buf_size = ALIGN_UP((size_t)s_frame_hres * s_frame_vres * 2, CACHE_LINE_SIZE);
    for (int i = 0; i < NUM_FRAME_BUFS; i++) {
        s_frame_bufs[i] = (uint8_t *)heap_caps_aligned_alloc(CACHE_LINE_SIZE, s_frame_buf_size, MALLOC_CAP_SPIRAM);
        if (!s_frame_bufs[i]) {
            ESP_LOGE(TAG, "Failed to allocate frame buffer %d (%d bytes)", i, (int)s_frame_buf_size);
            return ESP_ERR_NO_MEM;
        }
    }

    jpeg_encode_memory_alloc_cfg_t jpeg_mem_cfg = {};
    jpeg_mem_cfg.buffer_direction = JPEG_ENC_ALLOC_OUTPUT_BUFFER;
    for (int i = 0; i < NUM_FRAME_BUFS; i++) {
        size_t alloc_sz = 0;
        s_jpeg_bufs[i] = (uint8_t *)jpeg_alloc_encoder_mem(s_frame_hres * s_frame_vres, &jpeg_mem_cfg, &alloc_sz);
        if (!s_jpeg_bufs[i]) {
            ESP_LOGE(TAG, "Failed to allocate JPEG buffer %d", i);
            return ESP_ERR_NO_MEM;
        }
        if (i == 0) s_jpeg_buf_alloc = alloc_sz;
    }

    s_send_buf_size = s_jpeg_buf_alloc;
    s_send_buf = (uint8_t *)heap_caps_aligned_alloc(CACHE_LINE_SIZE, s_send_buf_size, MALLOC_CAP_SPIRAM);
    if (!s_send_buf) {
        ESP_LOGE(TAG, "Failed to allocate send buffer");
        return ESP_ERR_NO_MEM;
    }

    jpeg_encode_engine_cfg_t enc_eng_cfg = {};
    enc_eng_cfg.timeout_ms = 500;
    err = jpeg_new_encoder_engine(&enc_eng_cfg, &s_jpeg_enc);
    if (err != ESP_OK) {
        ESP_LOGE(TAG, "JPEG encoder init failed: %s", esp_err_to_name(err));
        return err;
    }

    err = esp_cam_ctlr_enable(s_cam_handle);
    if (err != ESP_OK) {
        ESP_LOGE(TAG, "CSI controller enable failed: %s", esp_err_to_name(err));
        return err;
    }

    err = esp_cam_ctlr_start(s_cam_handle);
    if (err != ESP_OK) {
        ESP_LOGE(TAG, "CSI controller start failed: %s", esp_err_to_name(err));
        return err;
    }

    s_cam_initialized = true;

    s_capture_running = true;
    if (xTaskCreatePinnedToCore(capture_task_fn, "csi_cap", 4096, NULL, 6, &s_capture_task, 1) != pdPASS) {
        ESP_LOGE(TAG, "No memory for the capture task");
        s_capture_running = false;
        return ESP_ERR_NO_MEM;
    }
    startStreamWorker();

    ESP_LOGI(TAG, "MIPI-CSI camera initialized (%dx%d, %d-lane, %d Mbps)", s_frame_hres, s_frame_vres,
             MIPI_CSI_DATA_LANES, MIPI_CSI_LANE_BITRATE_MBPS);
    return ESP_OK;
}

// The capture task's newest JPEG, copied out so it can encode the next while the stream sends this one; no frame for
// 3 s ends the streams.
static bool takeFrame(Frame &frame) {
    if (xSemaphoreTake(s_jpeg_ready, pdMS_TO_TICKS(3000)) != pdTRUE) return false;
    xSemaphoreTake(s_jpeg_lock, portMAX_DELAY);
    const size_t len = s_ready_idx >= 0 ? s_ready_jpeg_len : 0;
    if (len > 0) memcpy(s_send_buf, s_jpeg_bufs[s_ready_idx], len);
    xSemaphoreGive(s_jpeg_lock);
    frame = {s_send_buf, len};
    return true;
}

static void giveFrame() {}

#else

CameraService::CameraService() {}
esp_err_t CameraService::begin() { return ESP_ERR_NOT_SUPPORTED; }
esp_err_t CameraService::cameraStream(httpd_req_t *request) {
    return WebServer::sendError(request, 501, "Camera not supported on this platform");
}

#endif

} // namespace Camera
