runeharlyk/SpotMicroESP32-Leika/esp32/src/filesystem_ws.cpp

#include <filesystem_ws.h>
#include <fs_paths.h>
#include <pb_encode.h>
#include <pb_decode.h>
#include <esp_littlefs.h>
#include <esp_timer.h>
#include <esp_log.h>
#include <dirent.h>
#include <sys/stat.h>
#include <unistd.h>
#include <cstring>
#include <memory>
#include <new>
#include <vector>

static const char* TAG = "FileSystemWS";
static const char* PATH_REFUSED = "Path not allowed";

namespace FileSystemWS {

FileSystemHandler fsHandler;

FileSystemHandler::FileSystemHandler() : transferIdCounter_(0) {}

void FileSystemHandler::setSendCallbacks(SendMetadataCallback sendMetadata, SendCallback sendData,
                                         SendCompleteCallback sendComplete,
                                         SendUploadCompleteCallback sendUploadComplete) {
    sendMetadataCallback_ = sendMetadata;
    sendDataCallback_ = sendData;
    sendCompleteCallback_ = sendComplete;
    sendUploadCompleteCallback_ = sendUploadComplete;
}

void FileSystemHandler::cleanupExpiredTransfers() {
    uint32_t now = esp_timer_get_time() / 1000;

    std::vector<uint32_t> expiredDownloads;
    for (const auto& [transferId, download] : downloads_) {
        if (now - download.lastActivityTime > FS_TRANSFER_TIMEOUT_MS) expiredDownloads.push_back(transferId);
    }
    for (uint32_t transferId : expiredDownloads) failDownload(transferId, "Transfer timed out");

    auto ulIt = uploads_.begin();
    while (ulIt != uploads_.end()) {
        if (now - ulIt->second.lastActivityTime > FS_TRANSFER_TIMEOUT_MS) {
            if (ulIt->second.file) {
                fclose(ulIt->second.file);
            }
            remove(ulIt->second.partPath().c_str());
            ESP_LOGW(TAG, "Upload %u timed out, deleted partial file", ulIt->first);

            if (sendUploadCompleteCallback_) {
                socket_message_FSUploadComplete complete = socket_message_FSUploadComplete_init_zero;
                complete.transfer_id = ulIt->first;
                complete.success = false;
                strncpy(complete.error, "Transfer timed out", sizeof(complete.error) - 1);
                complete.chunks_received = ulIt->second.chunksReceived;
                sendUploadCompleteCallback_(complete, ulIt->second.clientId);
            }

            ulIt = uploads_.erase(ulIt);
        } else {
            ++ulIt;
        }
    }
}

socket_message_FSDeleteResponse FileSystemHandler::handleDelete(const socket_message_FSDeleteRequest& req) {
    socket_message_FSDeleteResponse response = socket_message_FSDeleteResponse_init_zero;
    if (!fsEntryAllowed(req.path)) {
        strncpy(response.error, PATH_REFUSED, sizeof(response.error) - 1);
        return response;
    }

    std::string path = std::string(MOUNT_POINT) + req.path;
    ESP_LOGI(TAG, "Delete request: %s", path.c_str());

    struct stat st;
    if (stat(path.c_str(), &st) != 0) {
        response.success = false;
        strncpy(response.error, "File or directory not found", sizeof(response.error) - 1);
        return response;
    }

    if (deleteRecursive(path)) {
        response.success = true;
    } else {
        response.success = false;
        strncpy(response.error, "Failed to delete", sizeof(response.error) - 1);
    }

    return response;
}

bool FileSystemHandler::deleteRecursive(const std::string& path) {
    struct stat st;
    if (stat(path.c_str(), &st) != 0) return false;

    if (S_ISDIR(st.st_mode)) {
        DIR* dir = opendir(path.c_str());
        if (!dir) return false;

        struct dirent* entry;
        while ((entry = readdir(dir)) != nullptr) {
            if (strcmp(entry->d_name, ".") == 0 || strcmp(entry->d_name, "..") == 0) {
                continue;
            }
            std::string childPath = path + "/" + entry->d_name;
            if (!deleteRecursive(childPath)) {
                closedir(dir);
                return false;
            }
        }
        closedir(dir);
        return rmdir(path.c_str()) == 0;
    } else {
        return remove(path.c_str()) == 0;
    }
}

socket_message_FSMkdirResponse FileSystemHandler::handleMkdir(const socket_message_FSMkdirRequest& req) {
    socket_message_FSMkdirResponse response = socket_message_FSMkdirResponse_init_zero;
    if (!fsEntryAllowed(req.path)) {
        strncpy(response.error, PATH_REFUSED, sizeof(response.error) - 1);
        return response;
    }

    std::string path = std::string(MOUNT_POINT) + req.path;
    ESP_LOGI(TAG, "Mkdir request: %s", path.c_str());

    struct stat st;
    if (stat(path.c_str(), &st) == 0) {
        response.success = false;
        strncpy(response.error, "Path already exists", sizeof(response.error) - 1);
        return response;
    }

    if (FileSystem::mkdirRecursive(path.c_str())) {
        response.success = true;
    } else {
        response.success = false;
        strncpy(response.error, "Failed to create directory", sizeof(response.error) - 1);
    }

    return response;
}

// Entries the file API would refuse, /config among them, are left out, so the app does not offer to open them.
void FileSystemHandler::listDirectory(const std::string& path, const std::string& listed,
                                      socket_message_FSListResponse& response) {
    DIR* dir = opendir(path.c_str());
    if (!dir) {
        return;
    }

    listedFiles_.clear();
    listedDirectories_.clear();
    struct dirent* entry;
    while ((entry = readdir(dir)) != nullptr && listedFiles_.size() < MAX_LISTED &&
           listedDirectories_.size() < MAX_LISTED) {
        const std::string child = (listed.back() == '/' ? listed : listed + "/") + entry->d_name;
        if (!fsPathAllowed(child)) continue;

        std::string fullPath = path + "/" + entry->d_name;
        struct stat st;
        if (stat(fullPath.c_str(), &st) != 0) continue;

        if (S_ISDIR(st.st_mode)) {
            socket_message_Directory directory = socket_message_Directory_init_zero;
            strncpy(directory.name, entry->d_name, sizeof(directory.name) - 1);
            listedDirectories_.push_back(directory);
        } else {
            socket_message_File file = socket_message_File_init_zero;
            strncpy(file.name, entry->d_name, sizeof(file.name) - 1);
            file.size = st.st_size;
            listedFiles_.push_back(file);
        }
    }

    closedir(dir);
    response.files = listedFiles_.data();
    response.files_count = listedFiles_.size();
    response.directories = listedDirectories_.data();
    response.directories_count = listedDirectories_.size();
}

socket_message_FSListResponse FileSystemHandler::handleList(const socket_message_FSListRequest& req) {
    socket_message_FSListResponse response = socket_message_FSListResponse_init_zero;

    const std::string listed = req.path[0] ? req.path : "/";
    if (!fsPathAllowed(listed)) {
        strncpy(response.error, PATH_REFUSED, sizeof(response.error) - 1);
        return response;
    }

    std::string path = std::string(MOUNT_POINT) + listed;
    ESP_LOGI(TAG, "List request: %s", path.c_str());

    struct stat st;
    if (stat(path.c_str(), &st) != 0) {
        response.success = false;
        strncpy(response.error, "Path not found", sizeof(response.error) - 1);
        return response;
    }

    listDirectory(path, listed, response);
    response.success = true;

    return response;
}

namespace {
class FileSource : public DownloadSource {
  public:
    explicit FileSource(FILE* file) : file_(file) {}
    ~FileSource() override { fclose(file_); }
    size_t read(uint8_t* into, size_t size) override { return fread(into, 1, size, file_); }

  private:
    FILE* file_;
};
} // namespace

void FileSystemHandler::handleDownloadRequest(const socket_message_FSDownloadRequest& req, int clientId) {
    cleanupExpiredTransfers();
    if (!fsEntryAllowed(req.path)) {
        if (sendMetadataCallback_) {
            socket_message_FSDownloadMetadata metadata = socket_message_FSDownloadMetadata_init_zero;
            strncpy(metadata.error, PATH_REFUSED, sizeof(metadata.error) - 1);
            sendMetadataCallback_(metadata, clientId);
        }
        return;
    }
    std::string path = std::string(MOUNT_POINT) + req.path;
    ESP_LOGI(TAG, "Download request: %s", path.c_str());

    struct stat st;
    if (stat(path.c_str(), &st) != 0 || S_ISDIR(st.st_mode)) return refuseDownload("File not found", clientId);

    FILE* file = fopen(path.c_str(), "rb");
    if (!file) return refuseDownload("Cannot open file for reading", clientId);
    std::unique_ptr<DownloadSource> source(new (std::nothrow) FileSource(file));
    if (!source) {
        fclose(file);
        return refuseDownload("Out of memory", clientId);
    }
    startDownload(std::move(source), st.st_size, clientId);
}

void FileSystemHandler::refuseDownload(const char* error, int clientId) {
    if (!sendMetadataCallback_) return;
    socket_message_FSDownloadMetadata metadata = socket_message_FSDownloadMetadata_init_zero;
    metadata.success = false;
    strncpy(metadata.error, error, sizeof(metadata.error) - 1);
    sendMetadataCallback_(metadata, clientId);
}

void FileSystemHandler::startDownload(std::unique_ptr<DownloadSource> source, uint32_t size, int clientId) {
    cleanupExpiredTransfers();
    uint32_t chunkSize = FS_MAX_CHUNK_SIZE;
    uint32_t totalChunks = (size + chunkSize - 1) / chunkSize;
    if (totalChunks == 0) totalChunks = 1;

    uint32_t transferId = generateTransferId();

    if (sendMetadataCallback_) {
        socket_message_FSDownloadMetadata metadata = socket_message_FSDownloadMetadata_init_zero;
        metadata.transfer_id = transferId;
        metadata.success = true;
        metadata.file_size = size;
        metadata.total_chunks = totalChunks;
        sendMetadataCallback_(metadata, clientId);
    }

    DownloadState state;
    state.source = std::move(source);
    state.fileSize = size;
    state.chunkSize = chunkSize;
    state.totalChunks = totalChunks;
    state.chunksSent = 0;
    state.lastActivityTime = esp_timer_get_time() / 1000;
    state.clientId = clientId;

    downloads_[transferId] = std::move(state);

    ESP_LOGI(TAG, "Download started: size=%u, chunks=%u, id=%u", size, totalChunks, transferId);

    pumpDownload(transferId);
}

// At most one chunk per turn of the socket's task, and only once the socket can take it whole: a send the network
// cannot absorb would hold the task, and every client's frames with it, for as long as the chunk takes to drain.
void FileSystemHandler::pumpDownload(uint32_t transferId) {
    auto it = downloads_.find(transferId);
    if (it == downloads_.end()) return;
    if (waitWritable_(it->second.clientId, 10) && !sendNextDownloadChunk(transferId)) return;
    if (!runLater_([this, transferId] { pumpDownload(transferId); }))
        failDownload(transferId, "Server too busy to continue");
}

void FileSystemHandler::failDownload(uint32_t transferId, const char* error) {
    auto it = downloads_.find(transferId);
    if (it == downloads_.end()) return;
    DownloadState& state = it->second;
    if (sendCompleteCallback_) {
        socket_message_FSDownloadComplete complete = socket_message_FSDownloadComplete_init_zero;
        complete.transfer_id = transferId;
        complete.success = false;
        strncpy(complete.error, error, sizeof(complete.error) - 1);
        complete.total_chunks = state.chunksSent;
        complete.file_size = state.fileSize;
        sendCompleteCallback_(complete, state.clientId);
    }
    downloads_.erase(it);
    ESP_LOGW(TAG, "Download %u failed: %s", transferId, error);
}

void FileSystemHandler::dropClient(int clientId) {
    for (auto it = downloads_.begin(); it != downloads_.end();) {
        if (it->second.clientId != clientId) {
            ++it;
            continue;
        }
        ESP_LOGI(TAG, "Download %u ended with its client", it->first);
        it = downloads_.erase(it);
    }
    for (auto it = uploads_.begin(); it != uploads_.end();) {
        if (it->second.clientId != clientId) {
            ++it;
            continue;
        }
        if (it->second.file) fclose(it->second.file);
        remove(it->second.partPath().c_str());
        ESP_LOGI(TAG, "Upload %u ended with its client", it->first);
        it = uploads_.erase(it);
    }
}

bool FileSystemHandler::sendNextDownloadChunk(uint32_t transferId) {
    auto it = downloads_.find(transferId);
    if (it == downloads_.end()) {
        return false;
    }

    DownloadState& state = it->second;
    state.lastActivityTime = esp_timer_get_time() / 1000;

    if (state.chunksSent >= state.totalChunks) {
        if (sendCompleteCallback_) {
            socket_message_FSDownloadComplete complete = socket_message_FSDownloadComplete_init_zero;
            complete.transfer_id = transferId;
            complete.success = true;
            complete.total_chunks = state.totalChunks;
            complete.file_size = state.fileSize;
            sendCompleteCallback_(complete, state.clientId);
        }

        downloads_.erase(it);
        ESP_LOGI(TAG, "Download completed: %u", transferId);
        return false;
    }

    std::unique_ptr<uint8_t[]> storage(new (std::nothrow) uint8_t[PB_BYTES_ARRAY_T_ALLOCSIZE(state.chunkSize)]);
    if (!storage) {
        failDownload(transferId, "Out of memory for a chunk");
        return false;
    }
    auto* chunk = reinterpret_cast<pb_bytes_array_t*>(storage.get());
    socket_message_FSDownloadData data = socket_message_FSDownloadData_init_zero;
    data.transfer_id = transferId;
    data.chunk_index = state.chunksSent;
    data.data = chunk;

    uint32_t bytesToRead = state.chunkSize;
    uint32_t position = state.chunksSent * state.chunkSize;
    if (position + bytesToRead > state.fileSize) {
        bytesToRead = state.fileSize - position;
    }

    size_t bytesRead = state.source->read(chunk->bytes, bytesToRead);
    if (bytesRead == 0 && bytesToRead > 0) {
        failDownload(transferId, "Failed to read");
        return false;
    }
    chunk->size = bytesRead;

    if (sendDataCallback_) {
        sendDataCallback_(data, state.clientId);
    }

    state.chunksSent++;
    ESP_LOGD(TAG, "Download chunk %u/%u sent: %u bytes", state.chunksSent, state.totalChunks, bytesRead);

    return true;
}

socket_message_FSUploadStartResponse FileSystemHandler::handleUploadStart(const socket_message_FSUploadStart& req,
                                                                          int clientId) {
    cleanupExpiredTransfers();
    socket_message_FSUploadStartResponse response = socket_message_FSUploadStartResponse_init_zero;
    if (!fsEntryAllowed(req.path)) {
        strncpy(response.error, PATH_REFUSED, sizeof(response.error) - 1);
        return response;
    }

    std::string path = std::string(MOUNT_POINT) + req.path;
    ESP_LOGI(TAG, "Upload start request: %s, size=%u, chunks=%u", path.c_str(), req.file_size, req.total_chunks);

    size_t fs_total = 0, fs_used = 0;
    esp_littlefs_info("spiffs", &fs_total, &fs_used);
    size_t freeSpace = fs_total - fs_used;
    if (freeSpace < req.file_size + 4096) {
        response.success = false;
        strncpy(response.error, "Insufficient storage space", sizeof(response.error) - 1);
        return response;
    }

    size_t lastSlash = path.find_last_of('/');
    if (lastSlash != std::string::npos && lastSlash > 0) {
        std::string parentDir = path.substr(0, lastSlash);
        struct stat st;
        if (stat(parentDir.c_str(), &st) != 0) {
            response.success = false;
            strncpy(response.error, "Parent directory does not exist", sizeof(response.error) - 1);
            return response;
        }
    }

    FILE* file = fopen((path + ".part").c_str(), "wb");
    if (!file) {
        response.success = false;
        strncpy(response.error, "Cannot open file for writing", sizeof(response.error) - 1);
        return response;
    }

    uint32_t transferId = generateTransferId();

    UploadState state;
    state.path = path;
    state.file = file;
    state.fileSize = req.file_size;
    state.totalChunks = req.total_chunks;
    state.chunksReceived = 0;
    state.bytesReceived = 0;
    state.lastActivityTime = esp_timer_get_time() / 1000;
    state.clientId = clientId;
    state.hasError = false;

    uploads_[transferId] = state;

    response.success = true;
    response.transfer_id = transferId;

    ESP_LOGI(TAG, "Upload started: %s, id=%u", path.c_str(), transferId);

    return response;
}

void FileSystemHandler::handleUploadData(const socket_message_FSUploadData& req) {
    uint32_t transferId = req.transfer_id;

    auto it = uploads_.find(transferId);
    if (it == uploads_.end()) {
        ESP_LOGW(TAG, "Upload data for unknown transfer: %u", transferId);
        return;
    }

    UploadState& state = it->second;
    state.lastActivityTime = esp_timer_get_time() / 1000;

    if (state.hasError) {
        return;
    }

    if (req.chunk_index != state.chunksReceived) {
        ESP_LOGW(TAG, "Upload chunk out of order: expected %u, got %u", state.chunksReceived, req.chunk_index);
        state.hasError = true;
        state.errorMessage = "A chunk arrived out of order";
        finalizeUpload(transferId, false, state.errorMessage);
        return;
    }

    const size_t size = req.data ? req.data->size : 0;
    size_t bytesWritten = size ? fwrite(req.data->bytes, 1, size, state.file) : 0;
    if (bytesWritten != size) {
        state.hasError = true;
        state.errorMessage = "Failed to write chunk";
        finalizeUpload(transferId, false, state.errorMessage);
        return;
    }

    state.chunksReceived++;
    state.bytesReceived += bytesWritten;

    if (state.chunksReceived > 0 && state.chunksReceived % 64 == 0) {
        ESP_LOGD(TAG, "Flushing file at chunk %u", state.chunksReceived);
        fflush(state.file);
    }

    ESP_LOGD(TAG, "Upload chunk %u/%u: %u bytes", state.chunksReceived, state.totalChunks, bytesWritten);

    if (state.chunksReceived >= state.totalChunks) {
        finalizeUpload(transferId, true);
    }
}

void FileSystemHandler::finalizeUpload(uint32_t transferId, bool success, const std::string& error) {
    auto it = uploads_.find(transferId);
    if (it == uploads_.end()) {
        return;
    }

    UploadState& state = it->second;
    std::string failure = error;

    bool closed = !state.file || fclose(state.file) == 0;
    state.file = nullptr;
    if (success && (!closed || state.bytesReceived != state.fileSize)) {
        success = false;
        failure = closed ? "The file arrived at a different size than announced" : "Failed to write the file";
    }
    if (success && rename(state.partPath().c_str(), state.path.c_str()) != 0) {
        success = false;
        failure = "Failed to replace the file";
    }

    if (!success) {
        remove(state.partPath().c_str());
        ESP_LOGW(TAG, "Upload of %s failed (%s); the previous file is untouched", state.path.c_str(), failure.c_str());
    } else {
        ESP_LOGI(TAG, "Upload completed: %s (%u bytes)", state.path.c_str(), state.bytesReceived);
    }

    if (sendUploadCompleteCallback_) {
        socket_message_FSUploadComplete complete = socket_message_FSUploadComplete_init_zero;
        complete.transfer_id = transferId;
        complete.success = success;
        if (!failure.empty()) {
            strncpy(complete.error, failure.c_str(), sizeof(complete.error) - 1);
        }
        complete.chunks_received = state.chunksReceived;
        sendUploadCompleteCallback_(complete, state.clientId);
    }

    uploads_.erase(it);
}

socket_message_FSCancelTransferResponse FileSystemHandler::handleCancelTransfer(
    const socket_message_FSCancelTransfer& req) {
    socket_message_FSCancelTransferResponse response = socket_message_FSCancelTransferResponse_init_zero;
    uint32_t transferId = req.transfer_id;
    response.transfer_id = transferId;

    auto dlIt = downloads_.find(transferId);
    if (dlIt != downloads_.end()) {
        downloads_.erase(dlIt);
        response.success = true;
        ESP_LOGI(TAG, "Download cancelled: %u", transferId);
        return response;
    }

    auto ulIt = uploads_.find(transferId);
    if (ulIt != uploads_.end()) {
        if (ulIt->second.file) {
            fclose(ulIt->second.file);
        }
        remove(ulIt->second.partPath().c_str());
        uploads_.erase(ulIt);
        response.success = true;
        ESP_LOGI(TAG, "Upload cancelled: %u", transferId);
        return response;
    }

    response.success = false;
    return response;
}

} // namespace FileSystemWS
