runeharlyk/SpotMicroESP32-Leika/esp32/src/event_socket.cpp

#include <event_socket.h>
#include <string>

SemaphoreHandle_t clientSubscriptionsMutex = xSemaphoreCreateMutex();

EventSocket::EventSocket(PsychicHttpServer &server, const char *route) : _server(server), _route(route) {
    _socket.onOpen((std::bind(&EventSocket::onWSOpen, this, std::placeholders::_1)));
    _socket.onClose(std::bind(&EventSocket::onWSClose, this, std::placeholders::_1));
    _socket.onFrame(std::bind(&EventSocket::onFrame, this, std::placeholders::_1, std::placeholders::_2));
}

void EventSocket::begin() { _server.on(_route, &_socket); }

void EventSocket::onWSOpen(PsychicWebSocketClient *client) {
    ESP_LOGI("EventSocket", "ws[%s][%u] connect", client->remoteIP().toString().c_str(), client->socket());
}

void EventSocket::onWSClose(PsychicWebSocketClient *client) {
    xSemaphoreTake(clientSubscriptionsMutex, portMAX_DELAY);
    for (auto &event_subscriptions : client_subscriptions) {
        event_subscriptions.second.remove(client->socket());
    }
    xSemaphoreGive(clientSubscriptionsMutex);
    ESP_LOGI("EventSocket", "ws[%s][%u] disconnect", client->remoteIP().toString().c_str(), client->socket());
}

esp_err_t EventSocket::onFrame(PsychicWebSocketRequest *request, httpd_ws_frame *frame) {
    ESP_LOGV("EventSocket", "ws[%s][%u] opcode[%d]", request->client()->remoteIP().toString().c_str(),
             request->client()->socket(), frame->type);

    JsonDocument doc;

#if USE_MSGPACK
    if (frame->type != HTTPD_WS_TYPE_BINARY) {
        ESP_LOGE("EventSocket", "Unsupported frame type: %d", frame->type);
        return ESP_OK;
    }
    if (deserializeMsgPack(doc, frame->payload, frame->len)) {
        ESP_LOGE("EventSocket", "Could not deserialize msgpack");
        return ESP_OK;
    };
#else
    if (frame->type != HTTPD_WS_TYPE_TEXT) {
        ESP_LOGE("EventSocket", "Unsupported frame type: %d", frame->type);
        return ESP_OK;
    }
    if (deserializeJson(doc, frame->payload, frame->len)) {
        ESP_LOGE("EventSocket", "Could not deserialize json");
        return ESP_OK;
    };
#endif

    auto msg = doc.as<JsonArray>();

    message_type_t message_type = static_cast<message_type_t>(msg[0].as<uint8_t>());

    if (message_type == PONG) {
        ESP_LOGV("EventSocket", "Pong");
        return ESP_OK;
    } else if (message_type == PING) {
        ESP_LOGV("EventSocket", "Ping");
#if USE_MSGPACK
        const uint8_t out[] = {0x91, 0x04};
        send(request->client(), reinterpret_cast<const char *>(out), sizeof(out));
#else
        const char *out = "[4]";
        send(request->client(), out, strlen(out));
#endif
        return ESP_OK;
    }

    const char *event = msg[1].as<const char *>();

    if (!event) {
        ESP_LOGE("EventSocket", "Invalid event name");
        return ESP_OK;
    }

    if (message_type == CONNECT) {
        ESP_LOGV("EventSocket", "Connect: %s", event);
        client_subscriptions[event].push_back(request->client()->socket());
        handleSubscribeCallbacks(event, std::to_string(request->client()->socket()));
    } else if (message_type == DISCONNECT) {
        ESP_LOGV("EventSocket", "Disconnect: %s", event);
        client_subscriptions[event].remove(request->client()->socket());
    } else if (message_type == EVENT) {
        JsonVariant payload = msg[2].as<JsonVariant>();
        handleEventCallbacks(event, payload, request->client()->socket());
        return ESP_OK;
    }
    return ESP_OK;
}

bool EventSocket::hasSubscribers(const char *event) { return !client_subscriptions[event].empty(); }

void EventSocket::emit(const char *event, JsonVariant &payload, const char *originId, bool onlyToSameOrigin) {
    int originSubscriptionId = originId[0] ? atoi(originId) : -1;
    xSemaphoreTake(clientSubscriptionsMutex, portMAX_DELAY);
    auto &subscriptions = client_subscriptions[event];
    if (subscriptions.empty()) {
        xSemaphoreGive(clientSubscriptionsMutex);
        return;
    }

    JsonDocument doc;
    auto a = doc.to<JsonArray>();
    a.add(static_cast<uint8_t>(message_type_t::EVENT));
    a.add(event);
    a.add(payload);

#if USE_MSGPACK
    static char out[512];
    size_t len = serializeMsgPack(doc, out, sizeof(out));
    if (len == 0 || len >= sizeof(out)) {
        xSemaphoreGive(clientSubscriptionsMutex);
        ESP_LOGE("EventSocket", "Message payload bigger than buffer (%d <= %d)", sizeof(out), len);
        return;
    }
    const char *data = out;
#else
    static char out[1024];
    size_t len = serializeJson(doc, out, sizeof(out));
    if (len == 0 || len >= sizeof(out)) {
        xSemaphoreGive(clientSubscriptionsMutex);
        ESP_LOGE("EventSocket", "Message payload bigger than buffer (%d <= %d)", sizeof(out), len);
        return;
    }
    const char *data = out;
#endif

    auto sendTo = [&](int id) {
        if (auto *c = _socket.getClient(id)) {
            send(c, data, len);
        } else {
            subscriptions.remove(id);
        }
    };

    if (onlyToSameOrigin && originSubscriptionId > 0) {
        sendTo(originSubscriptionId);
    } else {
        for (int id : subscriptions) {
            if (id != originSubscriptionId) sendTo(id);
        }
    }
    xSemaphoreGive(clientSubscriptionsMutex);
}

void EventSocket::send(PsychicWebSocketClient *client, const char *data, size_t len) {
    if (!client) return;

#if USE_MSGPACK
    client->sendMessage(HTTPD_WS_TYPE_BINARY, data, len);
#else
    client->sendMessage(HTTPD_WS_TYPE_TEXT, data, len);
#endif
}

void EventSocket::handleEventCallbacks(std::string event, JsonVariant &jsonObject, int originId) {
    for (auto &callback : event_callbacks[event]) {
        callback(jsonObject, originId);
    }
}

void EventSocket::handleSubscribeCallbacks(std::string event, const std::string &originId) {
    for (auto &callback : subscribe_callbacks[event]) {
        callback(originId, true);
    }
}

void EventSocket::onEvent(std::string event, EventCallback callback) {
    event_callbacks[event].push_back(std::move(callback));
}

void EventSocket::onSubscribe(std::string event, SubscribeCallback callback) {
    subscribe_callbacks[event].push_back(std::move(callback));
}
