runeharlyk/SpotMicroESP32-Leika/esp32/src/ap_service.cpp

#include <ap_service.h>

static const char *TAG = "APService";

APService::APService()
    : protoHandler(APSettings_readForApp, APSettings_updateFromApp, this, api_APSettings_fields),
      _persistence(APSettings_read, APSettings_update, this, AP_SETTINGS_FILE, api_APSettings_fields,
                   api_APSettings_size, APSettings_defaults()),
      _dnsServer(nullptr),
      _lastManaged(0),
      _reconfigureAp(false) {
    addUpdateHandler([&](const std::string &originId) { reconfigureAP(); }, false);
}

APService::~APService() = default;

void APService::begin() { _persistence.readFromFS(); }

void APService::statusProto(api_APStatus &proto) {
    proto.status = getAPNetworkStatus();
    proto.ip_address = static_cast<uint32_t>(WiFi.softAPIP());
    std::string mac = WiFi.softAPmacAddress();
    strncpy(proto.mac_address, mac.c_str(), sizeof(proto.mac_address) - 1);
    proto.mac_address[sizeof(proto.mac_address) - 1] = '\0';
    proto.station_num = WiFi.softAPgetStationNum();
}

APNetworkStatus APService::getAPNetworkStatus() {
    wifi_mode_t currentWiFiMode = WiFi.getMode();
    bool apActive = currentWiFiMode == WIFI_MODE_AP || currentWiFiMode == WIFI_MODE_APSTA;
    if (apActive && snapshot().provision_mode != AP_MODE_ALWAYS && WiFi.status() == WL_CONNECTED) {
        return LINGERING;
    }
    return apActive ? ACTIVE : INACTIVE;
}

void APService::reconfigureAP() {
    _lastManaged = esp_timer_get_time() / 1000 - MANAGE_NETWORK_DELAY;
    _reconfigureAp = true;
}

void APService::loop() {
    EXECUTE_EVERY_N_MS(MANAGE_NETWORK_DELAY, manageAP());
}

void APService::manageAP() {
    wifi_mode_t currentWiFiMode = WiFi.getMode();
    const auto provisionMode = snapshot().provision_mode;
    if (provisionMode == AP_MODE_ALWAYS || (provisionMode == AP_MODE_DISCONNECTED && WiFi.status() != WL_CONNECTED)) {
        if (_reconfigureAp || currentWiFiMode == WIFI_MODE_NULL || currentWiFiMode == WIFI_MODE_STA) {
            startAP();
        }
    } else if ((currentWiFiMode == WIFI_MODE_AP || currentWiFiMode == WIFI_MODE_APSTA) &&
               (_reconfigureAp || !WiFi.softAPgetStationNum())) {
        stopAP();
    }
    _reconfigureAp = false;
}

void APService::startAP() {
    // A save from the app rewrites the settings on the socket's task: start with one whole copy.
    APSettings settings;
    read([&](const APSettings &stored) { settings = stored; });
    ESP_LOGI(TAG, "Starting software access point: %s", settings.ssid);
    WiFi.softAPConfig(IPAddress(settings.local_ip), IPAddress(settings.gateway_ip), IPAddress(settings.subnet_mask));
    WiFi.softAP(settings.ssid, settings.password, settings.channel, settings.ssid_hidden, settings.max_clients);
#if CONFIG_IDF_TARGET_ESP32C3
    WiFi.setTxPower(8);
#endif
    if (!_dnsServer) {
        IPAddress apIp = WiFi.softAPIP();
        ESP_LOGI(TAG, "Starting captive portal on %s", apIp.toString().c_str());
        _dnsServer = std::make_unique<DNSServer>();
        _dnsServer->start(DNS_PORT, apIp);
    }
}

void APService::stopAP() {
    if (_dnsServer) {
        ESP_LOGI(TAG, "Stopping captive portal");
        _dnsServer->stop();
        _dnsServer.reset();
    }
    ESP_LOGI(TAG, "Stopping AP");
    WiFi.softAPdisconnect(true);
}
