runeharlyk/SpotMicroESP32-Leika/esp32/include/features.h

#pragma once

#include <peripherals/peripherals.h>
#include <variant.h>
#include "platform_shared/message.pb.h"

// The camera is the board's, not the robot's: its pins and driver come with the build env.
#ifndef USE_CAMERA
#define USE_CAMERA 0
#endif

// The robot's own download of an update (ota_http.h): TLS, the HTTP client and the certificate bundle take ~165 KB of
// flash, more than the classic ESP32 envs' 1.9 MB app slots have left.
#ifndef USE_OTA_DOWNLOAD
#define USE_OTA_DOWNLOAD 1
#endif

namespace feature_service {

/** What this boot runs with, as the robot reports it to the app. */
struct RuntimeFeatures {
    const char *robotName;
    const char *hostname;
    KinematicsVariant variant;
    SensorStatus sensors;
    bool servoDetected;
    bool servosCalibrated;
    bool cameraDetected;
    bool cameraActive;
    bool ws2812;
    bool walkNN;
};

/** The PlatformIO env this firmware was built for. */
const char *buildTarget();

void printFeatureConfiguration();

void features_request(const RuntimeFeatures &features, socket_message_FeaturesDataResponse &fd_res);

} // namespace feature_service
