runeharlyk/SpotMicroESP32-Leika/esp32/include/wifi_service.h

#pragma once

#include <wifi/wifi_idf.h>
#include <wifi/link_watchdog.h>
#include <string>
#include <atomic>

#include <filesystem.h>
#include <utils/timing.h>
#include <template/stateful_service.h>
#include <template/stateful_persistence.h>
#include <template/stateful_proto_handler.h>
#include <settings/wifi_settings.h>
#include <settings/app_network_settings.h>
#include <settings/factory_network.h>
#include <settings/network_order.h>
#include <secrets.h>

#define WIFI_EVENT_STA_DISCONNECTED_IDF WIFI_EVENT_STA_DISCONNECTED
#define IP_EVENT_STA_GOT_IP_IDF 1000

class WiFiService : public StatefulService<WiFiSettings> {
  public:
    WiFiService();
    ~WiFiService();

    void begin();
    void loop();

    std::string getHostname() const {
        std::string hostname;
        read([&hostname](const WiFiSettings &settings) { hostname = settings.hostname; });
        return hostname;
    }

    /** Starts a scan unless one is running. */
    static void startScan();
    /** The last scan's networks; false while a scan is still running. */
    static bool scanResults(api_WifiNetworkList &list);
    static void status(api_WifiStatus &status);

    /** Whether the station got an address or lost the network since the last call. */
    bool takeStatusChanged() { return _statusChanged.exchange(false); }

    StatefulProtoHandler<WiFiSettings, api_WifiSettings> protoHandler;

  private:
    void onStationModeDisconnected(int32_t event, void *event_data);
    void onStationModeGotIP(int32_t event, void *event_data);

    FSPersistencePB<WiFiSettings> _persistence;

    void mergeFactoryNetwork();
    void reconfigureWiFiConnection();
    void manageSTA();
    void configureNetwork(const WiFiNetwork &network, const char *hostname);
    void watchLink(uint32_t nowMs);
    void probeGateway();

    // Set from the socket's task when settings change; the service task applies it.
    std::atomic<uint32_t> _reconfigureAt {0};
    // Set on the event loop's task, whose stack is too small to report the status from there.
    std::atomic<bool> _statusChanged {false};
    uint32_t _nextAttemptAt {0};
    uint32_t _nextNetwork {0};
    uint32_t _connectingTo {0};
    // The saved networks in the order the last scan ranked them, and the next to try; used when the strongest is preferred.
    uint32_t _order[sizeof(WiFiSettings::wifi_networks) / sizeof(WiFiNetwork)] {};
    size_t _orderCount {0};
    size_t _orderPos {0};
    bool _rankingScan {false};
    LinkWatchdog _linkWatchdog;
    // The last probe's answer, set on the ping task: -1 while none has ended since the service task took it.
    std::atomic<int> _probeAnswered {-1};
    // Set on the event loop's task when the station joins or drops, so the watchdog counts afresh.
    std::atomic<bool> _linkChanged {false};

    constexpr static uint32_t reconnectDelay {10000};
    // Leaves time for the reply to the save that caused the change.
    constexpr static uint32_t reconfigureDelay {500};
};
