runeharlyk/SpotMicroESP32-Leika/esp32/src/communication/websocket.cpp

#include <communication/websocket.h>
#include <esp_log.h>
#include <esp_timer.h>

static const char* TAG = "Websocket";

Websocket::Websocket(WebServer& server, const char* route)
    : server_(server), route_(route), sessionsMutex_(xSemaphoreCreateMutex()) {}

void Websocket::begin() {
    server_.onWsOpen([this](httpd_req_t* req) { onWsOpen(req); });
    server_.onWsClose([this](int sockfd) { onWsClose(sockfd); });
    server_.onWsFrame([this](httpd_req_t* req, httpd_ws_frame_t* frame) { return onFrame(req, frame); });
    server_.registerWebsocket(route_);
}

void Websocket::onWsOpen(httpd_req_t* req) {
    int sockfd = httpd_req_to_sockfd(req);
    xSemaphoreTake(sessionsMutex_, portMAX_DELAY);
    sessions_[sockfd] = nextSession_++;
    xSemaphoreGive(sessionsMutex_);
    // A new session starts with no subscriptions, whatever the descriptor's last session left.
    removeClient(sockfd);
    ESP_LOGI(TAG, "Client connected: %d", sockfd);
    sendPong(sockfd);
    if (openListener_) openListener_(sockfd);
}

void Websocket::onWsClose(int sockfd) {
    xSemaphoreTake(sessionsMutex_, portMAX_DELAY);
    sessions_.erase(sockfd);
    xSemaphoreGive(sessionsMutex_);
    ESP_LOGI(TAG, "Client disconnected: %d", sockfd);
    removeClient(sockfd);
    stalls_.forget(sockfd);
    if (closeListener_) closeListener_(sockfd);
}

uint32_t Websocket::session(int cid) {
    xSemaphoreTake(sessionsMutex_, portMAX_DELAY);
    auto it = sessions_.find(cid);
    uint32_t session = it == sessions_.end() ? 0 : it->second;
    xSemaphoreGive(sessionsMutex_);
    return session;
}

bool Websocket::isSession(int cid, uint32_t session) {
    return session != 0 && this->session(cid) == session;
}

esp_err_t Websocket::onFrame(httpd_req_t* req, httpd_ws_frame_t* frame) {
    if (frame->type != HTTPD_WS_TYPE_BINARY) {
        ESP_LOGW(TAG, "Expected binary frame, got type %d", frame->type);
        return ESP_OK;
    }

    int sockfd = httpd_req_to_sockfd(req);
    handleIncoming(frame->payload, frame->len, sockfd);
    return ESP_OK;
}

bool Websocket::ready(int cid) {
    const bool writable = WebServer::waitWritable(cid, 0);
    if (stalls_.gone(cid, writable, esp_timer_get_time() / 1000)) {
        ESP_LOGW(TAG, "Closing client %d: it has taken nothing for %u ms", cid, (unsigned)STALL_LIMIT_MS);
        server_.endSession(cid);
    }
    return writable;
}

bool Websocket::send(const uint8_t* data, size_t len, int cid) {
    esp_err_t err = server_.wsSend(cid, data, len);
    if (err != ESP_OK) {
        ESP_LOGE(TAG, "Failed to send message to client %d: %s (len=%u)", cid, esp_err_to_name(err), len);
    }
    return err == ESP_OK;
}
