runeharlyk/SpotMicroESP32-Leika/esp32/include/peripherals/barometer.h

#pragma once

#include <utils/math_utils.h>
#include <peripherals/sensor.hpp>
#include <peripherals/drivers/bmp180.h>

struct BarometerMsg {
    float pressure {-1};
    float altitude {-1};
    float temperature {-1};
    bool success {false};
};

class Barometer : public SensorBase<BarometerMsg> {
  public:
    bool initialize() override {
        _msg.success = _bmp.begin();
        return _msg.success;
    }

    bool identify() { return _bmp.identify(); }

    void stop() { _msg.success = false; }

    bool update() override {
        if (!_msg.success) return false;
        if (!_bmp.update()) return false;
        _msg.temperature = _bmp.getTemperature();
        _msg.pressure = _bmp.getPressure();
        _msg.altitude = _bmp.getAltitude();
        return true;
    }

    float getPressure() { return _msg.pressure; }
    float getAltitude() { return _msg.altitude; }
    float getTemperature() { return _msg.temperature; }
    bool active() { return _msg.success; }

  private:
    BMP180Driver _bmp;
};
