runeharlyk/SpotMicroESP32-Leika/esp32/include/message_types.h

#pragma once

#include <platform_shared/message.pb.h>
#include <utils/finite.h>

/** Controller input as the motion states use it: sticks in [-1, 1], height, speed and s1 in [0, 1]. */
struct CommandMsg {
    float lx, ly, rx, ry, h, s, s1;

    void fromProto(const socket_message_ControllerData& data) {
        lx = data.has_left ? bounded(data.left.x, -1, 1) : 0;
        ly = data.has_left ? bounded(data.left.y, -1, 1) : 0;
        rx = data.has_right ? bounded(data.right.x, -1, 1) : 0;
        ry = data.has_right ? bounded(data.right.y, -1, 1) : 0;
        h = bounded(data.height, 0, 1);
        s = bounded(data.speed, 0, 1);
        s1 = bounded(data.s1, 0, 1);
    }

    /** Whether a stick is off centre, i.e. the robot is being driven. */
    bool steering() const { return lx != 0 || ly != 0 || rx != 0 || ry != 0; }
};
