runeharlyk/SpotMicroESP32-Leika/esp32/test/host/gait_speed_test.cpp

// Host test of the walk's reach and joint speeds, built and run by test_host_programs.py: no gait, at any full stick,
// speed, step height or body height, puts a foot where its leg cannot reach or commands a joint faster than
// WalkState::MAX_JOINT_SPEED_DEG_S, or its cap at a lower servo supply.
// With the argument "report" it prints each gait's peak commanded joint speed, how often the servos' speed limit
// (SERVO_MAX_SPEED_DEG_S) holds a joint back, its forward speed at the app's settings and the commands out of reach.
#include <cmath>
#include <cstdio>
#include <cstring>
#include <variant.h>
#include <motion_states/walk_state.h>
#include <peripherals/servo_output.h>

static int failures = 0;

#define CHECK(condition)                                                         \
    do {                                                                         \
        if (!(condition)) {                                                      \
            std::printf("FAIL %s:%d: %s\n", __FILE__, __LINE__, #condition);     \
            failures++;                                                          \
        }                                                                        \
    } while (0)

namespace {

// The motion task's tick (esp32/src/main.cpp).
constexpr float DT = 0.01f;
// A knee the walk holds at its bound measures a little past it: the bound checks the swing at only some phases.
constexpr float BEND_SAMPLING_DEG = 0.1f;

enum Gait { TROT, CRAWL };

struct Speeds {
    float peak_deg_s = 0;
    int clipped_ticks = 0;
    int ticks = 0;
    // When the front left foot lifted off, first and last, and how often: the cycles walked.
    int lifts = 0, first_lift = 0, last_lift = 0;

    // How far the body walked forward: each tick, by as much as its stance feet moved back.
    float forward_m = 0;

    float cyclesPerSecond(float dt) const { return lifts > 1 ? (lifts - 1) / ((last_lift - first_lift) * dt) : 0; }
    float forwardSpeed(float dt) const { return forward_m / (ticks * dt); }
    // Every foot stayed where its leg can put it, with the knee between the bends the walk keeps it in. A straight knee
    // is where the kinematics clamp a foot beyond reach; a knee folded further, or a hip turned past 90, has the foot at
    // the hip, where the hip turns without bound and a joint jumps however slowly the walk goes.
    bool reached = true;
};
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
