runeharlyk/SpotMicroESP32-Leika/(commit log)

2023-04-30 🥳 Initial platformio project
2023-04-30 ❄️ Adds simple camera server and I2C connections
2023-04-30 🐧 Adds MIT license
2023-05-04 🦷 Adds simple controller / stream viewer
2023-05-04 🐆 Adds MJPEG and websocket support
2023-05-04 👏 Adds config file to store user defined values
2023-05-05 🔪 Removes unused library code
2023-05-05 🎉 Replace standard webserver with async
    [main.cpp]
2023-05-16 🪒 Cleans up main and assembles all configurations
2023-05-16 📯 Adds captive portal handler
2023-05-16 🔬 Moves script to own file
2023-05-16 🔮 Adds THREEjs MPU visualization
2023-05-16 📂 Moves camera setup to own
2023-05-16 💯 Adds initial IK and servo functionality
2023-05-16 📡 Adds standard OAT
2023-05-16 🕳 Disables brownouts
2023-05-16 🔬 Sets debug level
2023-05-16 🩺 Fixed MDNS
2023-05-16 📓 Adds logs and Ws data syncing
2023-05-16 📲 Adds initial svelte app with tailwind and typescript
2023-05-16 🙏 Adds mis components and services
2023-05-16 📡 Adds reactive data from socket connection
2023-05-16 ☂️ Adds dynamic location service
2023-05-16 🦺 Moves server handlers to lib
2023-05-16 🌊 Moves all logic to new Spot class
2023-05-16 🧼 Removes unused static website
2023-05-16 📡 Adds broadcasting data by ws
2023-05-16 🖼 Makes stream background a blured copy
2023-05-16 🎛 Adds topbar information drawer
2023-05-16 🕹 Adds controller functionality
2023-05-16 🚪 Adds sidebar skeleton
2023-07-12 🧹 Simplifies websocket messages
2023-07-12 🪛 Makes topbar fully responsive
2023-07-12 🪄 Adds vscode setting
2023-07-12 ⚙️ Adds config page
2023-07-12 🕹 Adds controller page
2023-07-12 💉 Adds systemhealth page
2023-07-12 🖇 Adds navigation for routes
2023-07-12 🔭 Adds meta tag for disallowing scaling
2023-07-18 🤖 Adds 3D model view
    [spot_micro.urdf.xacro]
2023-07-18 🫴 Modes steamView to views
2023-07-18 🎃 Adds darktheme
2023-07-18 🪺 Adds multible generic components
2023-07-18 🪸 Cleans up dead code from configView
2023-07-18 🐿 Renames store same
2023-07-18 🦅 Adds dependecies for 3D model loading
2023-07-18 🪲 Switches to use pnpm for package management
2023-07-18 🐼 Removes old code reference
2023-07-19 💠 Add initial kinematics modeling
2023-07-26 🦿 Adds kinematic library
2023-07-28 🎮 Adds shadows, dynamic sliders and livestream to emulation
2023-08-01 📼 Updates reponse cache to use indexedDB
2023-08-01 🔬 Decimates stl files -> 2,59mb to 559kb
2023-08-01 📲 Adds custom board partitions allowing for bigger app
    [no_oat.csv]
2023-08-02 🧼 Adds vite-plugin-compression
2023-08-02 🧬 Adds raw decimated stl files
    [backpart.stl, foot.stl, frontpart.stl, larm.stl, larm_cover.stl, lfoot.stl, lshoulder.stl, mainbody.stl]
2023-08-02 📐 Moves depth of topbar component
2023-08-07 🪄 Major refactoring to use ESP32 template
    This includes the change to use https://github.com/runeharlyk/ESP32-rapid-development-template.git as a freeRTos template
2023-08-07 🎓 Expand servo buffers to Int16
2023-08-07 👟 Moves render functionality to own functions
2023-08-14 🏓 Adds scene builder to simplify three scene creation
2023-08-14 💄 Adds SPI dependency
2023-08-14 👣 Adds example configuration settings and updates readme
2024-02-02 🫵 Adds drag controller for joints
2024-02-02 ✨ Updates all packages
2024-02-02 👽 Adds conditional access in builder
2024-02-02 🐺 Adds forward kinematics and keep robot grounded
2024-02-02 🔦 Updates the scene ligthnings
2024-02-03 🚡 Adds more stores for different data
2024-02-03 🎿 Adds initial controller data
2024-02-03 🦜 Adds new topbar inspired by real spot controller
2024-02-03 🏃‍♀️ Adds mock spot server to develop of API
2024-02-03 🤓 Renames folder to docs
2024-02-03 🐲 Simplifies modelview by having mock server
2024-02-03 🌃 Adds sky to scene
2024-02-03 👇 Adds touch for drag controls
2024-02-03 🌃 Adds use of sky
2024-02-03 🔝 Adds styling and function to topbar select
2024-02-03 🌐 Adds new build for web option
2024-02-03 🎮 Makes each socket connection control different model
2024-02-03 🌐 Make server also host files, for when building for web
2024-02-04 🐕‍🦺 Removes singlefile plugin for embedded
2024-02-04 🦧 Adds new scripts
2024-02-04 🦋 Adds location for socket connection
2024-02-04 🐨 Removes sidebar
2024-02-05 💀 Removes files serving from mock server
2024-02-05 🦉 Makes use of unique model per socket connection
2024-02-05 💩 Makes topbar setting remove canvas
2024-02-05 🚫 Adds stop function
2024-02-05 📜 Makes websocket send logs
2024-02-05 ℹ️ Makes mock server send more information
2024-02-05 📐 Adds more settings pages
2024-02-05 💀 Removes dead imports
2024-02-05 🏪 Adds a persistent svelte store
2024-02-05 🪓 Moves model loading to own file
2024-02-05 🧮 Adds simple calibration ui
2024-02-06 🐅 Adds alias for common paths
2024-02-06 🐨 Removes unused components
2024-02-08 🌴 Removes more unused code
2024-02-22 🧮 Adds results type
2024-02-22 🐨 Adds result types - Result, Error & Ok
2024-02-22 🪖 Moves throttle to utilities folder
2024-02-22 🪖 Moves humanFileSize to string utilities
2024-02-22 🪖 Moves filecache to own service
2024-02-22 🪖 Moves lerp to math utilities
2024-02-22 🪖 Moves persistent store to svelte-utilities
2024-02-22 🪖 Moves modelloader to model-utilities
2024-02-22 🧪 Adds test for the result type
2024-02-22 🪖 Moves location to utilities
2024-02-22 📐 Adds socket-service
2024-02-23 🌋 Adds exception to error type to help debugging
2024-02-23 🐽 Makes model-loading use result type for error handling
2024-02-23 🏪 Updates port for server
2024-02-23 📏 Formats app code
2024-02-23 🦴 Adds result service
2024-02-23 🏪 Adds more types to scenebuilder
2024-02-23 🌍 Split socket service from stores
2024-02-23 🌀 Makes mock server use generict property for messages
2024-02-23 📐 Adds test for string byte formatting
2024-02-23 🧪 Adds test for throttle class
2024-02-23 💀 Removes the lerp function in farvor of three
2024-02-23 🔢 Adds math function to convert to uint8
2024-02-23 🧹 Formats
2024-02-23 📜 Makes data sync more seamless
2024-02-23 ⛽ Create app-unit-test.yml
2024-02-26 ✨ Refactors and adds new mode concept
2024-02-26 🎭 Adds environment variables for modes
2024-02-26 🫁 Adds rest mode
2024-02-26 📫 Adds function to get the model toe positions
2024-02-26 🐾 Adds foot tracing and gui panel
    [spot_micro.urdf.xacro]
2024-02-26 🛝Adds slider for height and speed controls
2024-03-04 🧟‍♀️ Update vite config to use env variables
2024-03-04 🤖 Moves esp32 project to own project folder
    [no_oat.csv]
2024-03-04 💂‍♀️ Updates the build action
2024-03-04 👍 Updates app unit test suite
2024-03-17 🤌 Update naming of frontend test gate
2024-03-17 📨 Updates the moved gitignores
2024-03-17 🤏 Add gated check for embedded app build
2024-03-17 🖖 Updates import of topbar
2024-03-17 🛝 Removes comment from action
2024-03-17 🐾 Updates readme
2024-03-17 🧪 Makes test only run if relevant code is touched
2024-03-17 🧪 Adds platformio build gate
2024-03-17 ⚡ Adds overall connection diagram
2024-03-17 🐩 Adds favicon
2024-03-17 🍎 Makes app installable
2024-04-30 🪶 Adds monitor flags
2024-05-03 🚀 Initial sveltekit app
    [backpart.stl, foot.stl, frontpart.stl, larm.stl, larm_cover.stl, lfoot.stl, lshoulder.stl, mainbody.stl]
2024-05-03 🚀 Builds with new ESP32-Sveltekit template
    [backpart.stl, foot.stl, frontpart.stl, larm.stl, larm_cover.stl, lfoot.stl, lshoulder.stl, mainbody.stl]
2024-05-03 📜 Simplifies buildapp step
2024-05-03 Adds almost complete use of ESP32-sveltekit template
2024-05-03 Adds actuator service to sync angles
2024-05-03 Updates shadows and conditional ground plane
2024-05-03 update actuator state service
2024-05-03 Adds simple display, uss and imu service
2024-05-03 Cleans up ESP32Sveltekit header
2024-05-03 Updates the esp32 template to use eventsocket
2024-05-03 Adds monitor flags for esp32cam
2024-05-03 Deletes old project
    [backpart.stl, foot.stl, frontpart.stl, larm.stl, larm_cover.stl, lfoot.stl, lshoulder.stl, mainbody.stl]
2024-05-03 📂 Adds filesystem service
2024-05-03 📈 Updates cpu chart scale
2024-05-03 🧹 Removes unused svelte properties
2024-05-03 ⚡Handles svelte warnings
2024-05-03 🔔 Fixes notification bug
2024-05-03 🥣 Updates types and depedencies
2024-05-03 🔦 Reduces flash size by making analytic synchronous
2024-05-03 🏍️ Adds motionservice with data sync
2024-05-03 🧹 Removes notification event service
2024-05-03 📜 Updates readme to reflect ongoing refactoring
2024-05-03 🏍️ Updates build file
2024-05-03 👽 Configures frontend tests suit
2024-05-07 Upgrades ArduinoJson from version 6 to 7
2024-05-08 🪄 Adds api service with updates
2024-05-17 📷 Adds camera service
2024-05-17 🌬️ Updates logging level
2024-05-17 🌋 Moves defines to header
2024-05-17 📹 Adds camera services
2024-05-22 📂 Adds pre build step to ensure project structure
2024-05-25 📂 Updates app build output destination
2024-05-25 ✂️ Removes old filesystem config
    [no_oat.csv]
2024-05-25 🗿 Updates factory ap password
2024-05-25 🦾 Updates wwwData with newest build
2024-05-25 🗿 Removes unused features
2024-05-25 🗿 Remove comments
2024-05-25 🌬️ Moves website to progmem
2024-05-25 ⛱️ Removes phycic stream
2024-05-25 ✂️ Cleans up back files
2024-05-25 ✂️ Removes cors preflight from sleep service
2024-05-25 🪔 Unregistres build flags
2024-05-25 🪄 Updates app data
2024-05-25 📶 Disables OAT until flash requirements are met
2024-05-25 🪄 Updates readme to reflect new template
2024-05-28 📜 Adds the initial docs
2024-05-28 👾 Adds the recommended extensions
2024-05-28 ⛱️ Updates dev proxy to used factory mdns
2024-05-28 💫 Adds a getting started guide
2024-05-28 📃 Adds starting documentation
2024-05-28 📃 Updates documentation with a guide
2024-05-29 ✒️ Rename Spot.md to spot.md
2024-06-02 💫 Initial plans for device configuration service
2024-06-02 ✈️ Adds barometer to imu service
2024-06-02 🪰 Adds angle, heading, altitude, pressure and temperature
2024-06-04 🦾 Adds kinematics
2024-06-04 ✂️ Removes unused events
2024-06-04 🔦 Adds min spiffs config
    [min_spiffs.csv]
2024-06-04 🪄 Simplifies kin code
2024-06-04 🌬️ Optimized kinematric.ts with pre computation
2024-06-04 🦾 Makes embedded kinematics kinda work
2024-06-04 🥣 Adds setting for playing with the kinematics
2024-06-04 🏍️ Adds position event for updating kinematics
2024-06-04 ✂️ Removes min spiffs config
    [min_spiffs.csv]
2024-06-04 🦾 Fixes kinematic leg orientation
2024-06-04 ♣️ Simplifices angle updating
2024-06-04 🪄 Update kinematic interface
2024-06-04 🥣 Updates filesystem partition
2024-06-04 🛸 Adds tranformcontroller for body
2024-06-04 🪠 Adds GaitPlanner interface
2024-06-04 🗿 Hides position target
2024-06-04 🪠 Removes feature code
2024-06-04 ⛱️ Removes kinematics notebook
2024-06-04 🛸 Gitignores build and launch.json
2024-06-04 🔮 Reduces flash size
2024-06-04 📏 Adds more precision to shared angles
2024-06-10 🍒 Makes feature toggles work independent
2024-06-10 ⌨️ Adds KDE
2024-06-10 🦼 Adds servo calibration UI
2024-06-10 🦼 Updates servoController
2024-06-10 🌗 Make more service feature togglable
2024-06-10 🛸 Adds servo config
2024-06-10 🤖 Adds small fixes to psychic
2024-06-10 🔮 Refactors platformio configuration
2024-06-10 ⚠️ Removes redefines warning
2024-06-10 ⛱️ Removes std warnings
2024-06-10 🔮 Restructes platformio.ini
2024-06-10 🧹 Removes duplicated file
2024-06-10 🎩 Elevates ui components
2024-06-10 🛸 Adds embedded build workflow
2024-06-10 ⛱️ Updates wwwdata
2024-06-10 🎮 Updates embedded build workflow
2024-06-10 ⛱️ Updates logging to use ESP_LOG in favor Serial
2024-06-10 🕸️ Enables servo config endpoint and persistence
2024-06-10 🪵 Removes serial logging
2024-06-10 📂 Adds file selection
2024-06-10 🎩 Adds lots of magic
2024-06-10 🦔 Update embedded-build.yml
2024-06-10 🐝 Update embedded-build.yml
2024-06-10 🦕 Update embedded-build.yml
2024-06-10 🍡 Adds sweeping for servo
2024-06-10 🚚 Adds function to delete files
2024-06-10 👑 Updates internal kinematics params
2024-06-10 🧹 Makes sweeping faster
2024-06-17 💣 Removes mqtt support
2024-06-17 📷 Adds support for esp32-wroom-camera
2024-06-18 🖥️ Removes event registration
2024-06-18 💣 Removes websocketServer
2024-06-18 💣 Cleans up event socket interface
2024-06-18 🛸 Use char* in favour of String
2024-06-18 🪄 Adds servo angles
2024-06-18 🪄 Updates eventsocket protocol
2024-06-18 📜 Adds changelog
2024-06-18 🔭 Adds platformio build badge status
2024-06-18 🏮 Updates readme
2024-06-25 🧭 Hides charts base on sensors available
2024-06-25 🔋 Updates battery service with voltage and current
2024-06-25 🪰 Adds orientation store
2024-06-25 🔋 Adds battery event interval
2024-06-28 🪰 Fixes payload offset bug
2024-06-28 🛜 Removes leftover mqtt
2024-06-29 🍦 Adds software_description.md
2024-06-29 ✨ Cleans up documentation
2024-06-29 🎍 Updates readme.md
2024-06-29 ✒️ Updates readme.md
2024-06-30 🦕 Fixes links in readme.md
2024-06-30 🐢 Fixes links in readme.md
2024-07-01 💡 Adds led service
2024-07-05 🎥 Moves camera stream to component
2024-07-05 🪮 Add c_str() to origin id
2024-07-08 🪇 Adds early return for kinematics to reduce calc
2024-07-08 🖱️ Combines deviceConfig and IMU service to peripherals
2024-07-08 🗿 Adds i2c scanner and page
2024-07-08 🐍 Adds python version
2024-07-08 🎚️ Updates logging level for onSubcribe
2024-07-09 🎏 Adds project directory description
2024-07-09 🪮 Adds clang format
2024-07-09 🪄 Formats main
2024-07-09 🪄 Formats wifiStatus
2024-07-09 🪄 Formats WiFiSettingsService
2024-07-09 🪄 Formats WiFiScanner
2024-07-09 🪄 Formats UploadFirmwareService
2024-07-09 🪄 Formats TaskManager
2024-07-09 🪄 Formats SystemStatus
2024-07-09 🪄 Formats SleepService
2024-07-09 🪄 Formats StatefulService
2024-07-09 🪄 Formats Analytics service
2024-07-09 🪄 Formats APSettingsService
2024-07-09 🪄 Formats APStatus
2024-07-09 🪄 Formats ArduinoJsonJWT
2024-07-09 🪄 Formats AuthenticationService
2024-07-09 🪄 Formats BatteryService
2024-07-09 🪄 Formats CameraService
2024-07-09 🪄 Formats DownloadFirmwareService
2024-07-09 🪄 Formats EventEndpoint
2024-07-09 🪄 Formats EventSocket
2024-07-09 🪄 Formats FactoryResetService
2024-07-09 🪄 Formats FeatureService
2024-07-09 🪄 Formats FSPersistence
2024-07-09 🪄 Formats SecuritySettingsService
2024-07-09 🪄 Formats SecurityManager
2024-07-09 🪄 Formats RestartService
2024-07-09 🪄 Formats NTP related service
2024-07-09 🪄 Formats display service
2024-07-09 🪄 Formats FileExplorer
2024-07-09 🪄 Formats HttpEndpoint
2024-07-09 🪄 Formats IPUtils
2024-07-09 🪄 Formats JsonUtils
2024-07-09 🪄 Formats Kinematics
2024-07-09 🪄 Formats LEDService
2024-07-09 🪄 Formats MotionService
2024-07-09 🪄 Formats Peripherals
2024-07-09 🪄 Formats ESP32SvelteKit
2024-07-09 🐇 Adds clang as a software requirement
2024-07-09 🎏 Updates logging level in PsychicWebSocket.cpp
2024-07-09 📶 Makes WiFiIcon tooltip be the RSSI value
2024-07-11 💊 Updates camera task priority
2024-07-11 🪇 Updates task manager to accurate task cpu usage
2024-07-11 🐍 Makes sveltekit run arduino task loop
2024-07-12 ➕ Moves common math functions to own file
2024-07-14 🔋 Adds battery model
2024-07-14 ⌚ Adds timing macro
2024-07-14 🍬 Renames servo event config
2024-07-14 👨‍🔬 Adds math macros
2024-07-17 ⬅️ Fixes direction for the kinematic result
2024-07-17 🐍 Restricts angular movement
2024-07-17 🎮 Adds demo of controller and kinematics
2024-07-17 🎮 Adds controller demo to readme.md
2024-07-17 ☀️ Adds sun elevation calculator
2024-07-18 ✂️ Removes mock server
2024-07-22 ⏱️ Adds time it macro
2024-07-22 📷 Returns camera sensor after sending frame
2024-07-22 🛜 Updates wifi RSSI buffer size
2024-07-22 🐏 Adds support for esp32s3 psram
2024-07-22 🧵 Takes semaphore onWSClose
2024-07-24 📃 Update 6_developing.md
2024-08-01 🐏 Adds gait structures
2024-08-01 🦋 Adds phase controller
2024-08-01 🐎 Adds four phase gait
2024-08-01 🪅 Adds motion smoothing option for debug
2024-08-01 🧹 Cleans up gait code
2024-08-01 🪅 Adds 8 phase gait with body shift
2024-08-01 🎲 Adds all gait planners for internal kinematics
2024-08-01 🦘 Cleans gait source
2024-08-01 🪘 Adds translated c++ Gait code
2024-08-01 🦘 Adds gait comment in changelog
2024-08-01 🦘 Formats gait code
2024-08-01 👨‍💻 Updates c++ version to 23
2024-08-02 🚇 Adds hasSubcribers to event socket for early return
2024-08-02 ⏱️ Updates timing macro
2024-08-02 📈 Updates system metric charts
2024-08-02 🫀 Adds task to analytics
2024-08-02 📈 Updates the metric graph scales
2024-08-02 🎓 Updates task manager
2024-08-02 🐾 Updates the default feet positions
2024-08-03 🌆 Removes log for onSubscribe event
2024-08-03 🙊 Adds sonar support
2024-08-03 🐋 Adds sonar functionality
2024-08-03 🚦 Removes cone visulization
2024-08-03 🧄 Updates gait members to use body_state refference
2024-08-03 ⚖️ Adds equality functions
2024-08-03 🏎️ Updates servo controller to reflect rl angles
2024-08-03 🎉 Connects motion service with servo controller
2024-08-03 🐕 Makes gaits speed variable
2024-08-03 🪝 Removes user selection in controller view
2024-08-03 📏 Adds step length slider
2024-08-03 🚨 Updates led service to show isConnected
2024-08-03 🌍 Makes dev server available network wide
2024-08-17 🎚️ Adds a vertical slider component
2024-08-17 🪞 Adds mirror effect on groundplane
2024-08-17 〰️ Updates controller layout
2024-08-17 🪴 Updates dark theme primary color
2024-08-17 🧣 Adds minimum and maximum viewport scale
2024-08-17 🎚️ Simplifies vertical slider
2024-08-17 🕯️Updates scene ligthing
2024-08-17 🧹 Clean up components
2024-08-17 🎯 Hides position target by default
2024-08-17 🖼️ Updates controller demo gif
2024-08-17 🚫 Adds big red stop button
2024-08-17 🎬 Adds fullscreen button
2024-08-17 🎨 Updates joystick colors to be darker
2024-08-17 🎨 Updates themes colors
2024-08-18 👱‍♂️ Adds layout manager
2024-08-18 📱 Adds wrap mode for phones
2024-08-18 🎚️ Expands layout manager with widget sizing
2024-08-18 ⛹️‍♂️ Simplifies layout handling
2024-08-18 📦 Moves all model loading to model-utilities
2024-08-18 🌀 Adds uzip types
2024-08-18 🧹 Renames layout to page
2024-08-18 🌀 Adds mathutils module types
2024-08-18 🦾 Updates default state to deactivated
2024-08-18 🎬 Adds missing state in UI
2024-08-18 🤖 Adds tensorflow lite micro lib
2024-08-18 🍇 Adds tensorflow sin example
2024-08-18 🦘 Adds test script to train sin and convert model to tf lite
2024-08-18 🦼 Adds test for convert status
2024-08-18 🤖 Fixes model input type
2024-08-18 📦 Moves NN
2024-08-18 🧼 Removes NN from main
2024-08-18 📦 Moves notebook to dedicated folder
2024-08-18 🧼 Clean up esp32Sveltekit
2024-08-19 🏕️ Updates cache for embedded-build.yml
2024-08-19 📦 Moves statusbar to own component
2024-08-19 🪇 Implements major structure and service refactors
2024-08-19 🪇 Refactors file-service to handle non-browser context
2024-08-19 ⛹️‍♂️ Makes feature flag store only run once
2024-08-19 📦 Moves models to /types
2024-08-19 🧼 Updates password input component
2024-08-19 🧼 Makes fullscreen button a button
2024-08-19 🛸 Makes menu reactive to features
2024-08-19 🧼 Moves adafruit libs to platform
2024-08-19 🏕️ Renames the feature flag
2024-08-19 📦 Moves camera to own namespace
2024-08-19 🆚 Updates psychic version to 1.2.1
2024-08-19 🛸 Moves PhychicHTTP lib from /libs
2024-08-19 🧞‍♂️ Adds logging of the AP name
2024-08-19 🥀 Adds listener for feature flags
2024-08-19 🧼 Simplifies the menu structure
2024-08-19 🍧 Collects all icons
2024-08-19 🍧 Updates imports to use barrel exports
2024-08-19 🥫 Updates prettier config
2024-08-22 🦋 Adorns readme.md
2024-08-26 🛹 Adds a persistentStore for location
2024-08-26 🔮 Adds environment caster dependency
2024-08-26 🍁 Updates location store
2024-08-26 🎥 Updates stream location to be dynamic
2024-08-26 🧼 Removes embedded build flag
2024-08-26 🍭 Updates the persistent store to save onload
2024-08-26 🚿 Adds api function to ensure a host
2024-08-26 🦄 Adds route for changing robot connection
2024-08-26 🍭 Updates the event socket url to be dynamic
2024-08-26 🚿 Adds connection route to menu
2024-08-26 🐙 Adds types for the env
2024-08-26 🐙 Makes connection route conditional
2024-08-26 🦄 Adds build command with env
2024-08-26 🃏 Makes layout connect to event socket correctly
2024-08-26 🚝 Adds gap between hamburger and view selector
2024-08-26 🗽 Makes selector sm by default
2024-08-26 🦄 Updates prettier config with spaces over tabs
2024-08-26 🃏 Adds mobile capable meta tag
2024-09-03 ❌ Redo workflow cache changes
2024-09-03 🍎 Update partion scheme
2024-09-03 🏫 Collects all config file paths in espfs
2024-09-03 🍎 Adds cross-env
2024-09-03 🛜 Simplify wifi services
2024-09-03 🛜 Simplifies ap service
2024-09-03 🍎 Updates ui
2024-09-03 🍎 Update import casing
2024-09-03 🪕 Adds string utilities
2024-09-03 🍎 Adds cross env in build script
2024-09-09 📏 Updates umbrella class structure
2024-09-12 🏮 Adds servo config table
2024-09-12 🤖 Updates gait params
2024-09-12 🗃️ Update servoController file save
2024-09-12 🧼 Formats components
2024-10-27 🐹 Fixes crawl gait body shift order
2024-11-04 🧟‍♀️ Updates import for the github firmware manager
2024-11-04 ✨ Updates pnpm version for frontend-tests.yml
2024-11-04 💐 Updates tailwind config to import daisyui
2024-11-04 🧍‍♂️ Adds stl files for robot stand
    [2x_stand_bottom.stl, 2x_stand_brace.stl, 2x_stand_top.stl, 4x_stand_feet.stl]
2024-11-04 🔐 Removes auth from backend
2024-11-04 🔐 Removes auth from frontend
2024-11-04 🧼 Removes unused factory setting
2024-11-04 🎛️ Adds system service
2024-11-04 🪈 Updates pai path for ap and sta
2024-11-04 ✨ Updates Leika cover image
2024-11-07 ⏰ Refactors ntp service
2024-11-07 ✨ Refactors filesystem service
2024-11-07 ✨ Refactors event socket
2024-11-08 🕊️ Renames define
2024-11-08 ☔ Adds typing to joint name store
2024-11-08 🕊️ Makes task manager global
2024-11-08 📦 Moves setting to folder
2024-11-08 ✨ Updates stateful service
2024-11-08 ✨ Refactors feature service
2024-11-08 📦 Update firmware service
2024-11-08 🐹 Renames member
2024-11-08 🎛️ Renames timing
2024-11-11 🫚 Adds bezier gait
2024-11-11 🧼 Refactors bezier gait
2024-11-11 👟 Implementes bezier gait in c++
2024-11-11 🥽 Makes use of Atan2 to calculate lateral fraction
2024-11-11 🥽 Adds rotation to the native implementation
2024-11-11 🫚 Makes combinatorial a constant expression
2024-11-11 🐳 Makes phase power JIT
2024-11-11 🎍 Moves static definitions of bezier steps and height
2024-11-11 🎐 Updates body shift amount
2024-11-11 🏏 Updates gait to use leg phase time instead of contact phase
2024-11-11 🗺️ Makes visualizer use s1 slider for step height
2024-11-11 ♨️ Implements more use of std for gait
2024-11-11 ♨️ Adds test for gait performance
2024-11-12 🔦 Turn on ring led firstly at boot
2024-11-12 🧼 Removes server dependencies from service
2024-11-12 🎐 Makes Analytics service use system service for metrics
2024-11-12 🧼 Removes the need to pass reference to fs
2024-11-12 🧼 Removes HttpEndpoint
2024-11-12 🦠 Ignores pycache
2024-11-12 🧼 Splits motions state to own files
2024-11-12 ♨️ Udate performance test
2024-11-12 🕊️ Renames gait folder
2024-11-13 🪛 Revert gait body shift update
2024-11-13 🚨 Adds feature check for led service
2024-11-14 🧼 Renames stateful service
2024-11-14 🪮 Moves imu definition to own service
2024-11-14 🌹 Switches to an explicit sense plan act flow
2024-11-14 🎐 Makes analytics a part of system service
2024-11-14 🎮 Makes controller sub for imu updates
2024-11-14 🛢️ Makes mdns use class member
2024-11-14 🗨️ Updates comment casing
2024-11-14 🚒 Updates firmware download service interface
2024-11-14 🧼 Only write angles once
2024-11-14 📷 Merges camera setting service and camera service
2024-11-14 📦 Moves utilities to own folder
2024-11-14 🧼 Removes battery service
2024-11-14 🧼 Removes extern adc
2024-11-14 📦 Moves all i2c servo control to controller
2024-11-14 🧼 Makes appname be a const char*
2024-11-14 🧼 Moves led and servo controller
2024-11-14 📦 Moves math utils
2024-11-14 🧼 Removes display service
2024-11-14 🧼 Renames stateful socket service
2024-11-14 🧼 Moves camera to peripherals
2024-11-14 📦 Moves templates
2024-11-14 🧼 Removes ntp
2024-11-14 🧼 Makes magnometer own class
2024-11-14 ☁️ Makes barometer facade
2024-11-14 🧼 Renames service
2024-11-14 🧼 Renames kinematics
2024-11-15 🌹 Updates kinematic L3 parameter
2024-11-15 🪵 Adds log for use of default settings
2024-11-15 🪡 Moves server on robot facade
2024-11-15 🪡 Makes control loop frequency const value
2024-11-15 📃 Adds more docs
2024-11-19 🌊 Adds control flow, kinematic and motion controller docs
2024-11-23 🫏 Adds getter for state
2024-11-23 🆘 Adds helper function
2024-11-23 📛 Renames cb to callback
2024-11-23 📛 Renames members
2024-11-23 🧽 Refactors stateful service
2024-11-23 🧼 Removes WWWData.h
2024-11-26 🧽 Makes servo testing and calibration easier
2025-01-06 📃 Adds initial calibration guiding
2025-01-07 🦠 Fixes the servo switch actions
2025-01-07 💐 Updates @playwright/test
2025-01-17 🐛 Fixes undefined I2C behavior
2025-01-17 🧮 Updates min pwm value
2025-01-17 🛜 Faster connection for one network
2025-02-04 📃 Adds board config for seeed xiao esp32 s3
2025-02-04 🎈 Updates action upload artifact to v4
2025-02-05 🕊️ Adds import after install
2025-02-05 💐 Updates package manager order - default npm
2025-02-05 🪵 Adds logging to gait performance test
2025-02-06 🧼 Removes unnecessary config for xiao esp32s3
2025-02-26 🐛 Makes menu items stay open
2025-02-26 🌌 Migrate app to svelte-5
2025-03-01 🐛 Updates svelte-modals
2025-03-01 🧼 Updates inputs after svelte migration
2025-03-01 🧼 Updates menu list
2025-03-01 🧼 Migrates svelte-modals to 2.0
2025-03-07 💫 Migrate to TailwindCSS 4 and DaisyUI 5
2025-03-07 💅 Updates prettier config
2025-03-07 🕹️ Fixes vertical range input
2025-03-07 🧼 Removes battery indicator
2025-03-07 🍇 Bumps vite version
2025-03-07 🕹️ Updates keyboard controls
2025-03-07 💅 Updates status bare page store
2025-03-07 📂 Updates filessystem view
2025-03-08 💅 Refactors system status view
2025-03-08 🌌 Adds svelte adaptor back
2025-03-08 🌌 Makes front page simplere
2025-03-08 🧼 Refactors wifi and ap to use StatusItem
2025-03-08 📂 Fixes file system view
2025-03-20 🌌 Adds edit icons
2025-03-20 🧼 Simplifies and updates color scheme for confirm
2025-03-20 🧼 Cleans up setting card
2025-03-20 🎋 Makes icon optional for status item
2025-03-20 🎋 Adds i2c configuration type
2025-03-20 🥷 Adds i2c configurator
2025-03-21 Add Servo Motor Designations
    PCA9685 Servo PWM numbers to joint:
    PWM_0: Front Left Shoulder
    PWM_1: Front Left Upper-Limb
    PWM_2: Front Left Leg (Lower-Limb)
    PWM_3: Front Right Shoulder
    PWM_4: Front Right Upper-Limb
    PWM_5: Front Right Leg (Lower-Limb)
    PWM_6: Rear Left Shoulder
    PWM_7: Rear Left Upper-Limb
    PWM_8: Rear Left Leg (Lower-Limb)
    PWM_9: Rear Right Shoulder
    PWM_10: Rear Right Upper-Limb
    PWM_11: Rear Right Leg (Lower-limb)
2025-03-23 💫 Update menu styling
2025-03-23 📦 Moves platform ini to root
2025-03-23 ⚒️ Updates build workflow file
2025-03-23 🎋 Updates kinematics with modifiers
2025-03-23 📦 Use std:move for callback
2025-03-23 ⚒️ Enables bigger range of motion for servo controller
2025-03-23 🖨️ Adds printing of feature flags
2025-03-23 🚇 Enables metrics in ui
2025-03-23 🖥️ Adds mDNS service
2025-03-23 🧼 Removes unused imports
2025-03-23 🧼 Clean up MDNS UI
2025-03-29 ✍️ Adds bulk writing of pwm values to PCA9685
2025-03-29 ✍️ Updates I2C freq to Fast Mode Plus
2025-03-29 🫅 Updates spot control task priority 3 -> 5
2025-03-29 ⏱️ Updates the frequency of main control loop from 100 hz to 200
2025-03-29 🎋 Updates adafruit pwm lib to own fork until pr merged
2025-04-03 🪻 Hides menu overflow-x
2025-04-18 🎮 Adds gamepad api control
2025-04-20 🏎️ Simplifies kinematics by removing matrix muls
2025-04-21 🎍 Updates reset reason mapping
2025-05-05 👆 Fixes on click for system status view
2025-05-15 🤹 Adds option for direct control of multiple servos
2025-05-17 🎍 Updates feature flags and adds BNO055
2025-05-17 🧃 Adds IMU orientations indicator
2025-05-24 🗃️ Improves UI filesystem interface
2025-06-27 💄 Simplify calibration UX
2025-06-27 🔧 Adds support for Yertle legs
    https://github.com/Jerome-Graves/yertle/
2025-06-30 🚸 Update default feet positions
2025-06-30 🐛 Expand allowed _numberEndpoints
2025-07-02 👔 Calculate default feet positions from kinematics
2025-07-02 👔 Update visualization to better align with robot
2025-07-02 👔 Update model utils to be able to load both urdf and xacro
2025-07-10 ✨ Adds msgPack and update message protocol
2025-07-10 ♻️ Centralizes socket serialization
2025-07-10 ⚡️ Adds O3 build flag
2025-07-10 🔥 Removes debug logging
2025-07-10 ♻️ Replaces JsonObject with JsonVariant
2025-07-10 🐛 Maps frontend gait params same as backend
2025-07-10 🐛 Fixes some linting errors
2025-07-10 ➖ Changes mgspack dependency
2025-07-10 🐛 Fixes event socket binary serialization buffer length
2025-07-10 ✅ Fixes build warning and errors
2025-07-10 💄 Updates colors for metrics chart
2025-07-10 🔧 Adds env with default variables
2025-07-10 ✅ Fixes more linter errors
2025-07-10 🚀 Deploys app
2025-07-10 🔧 Makes default visualization be spot micro
2025-07-10 🚀 Makes deploy action run
2025-07-11 🚚 Moves firmware to src and include
2025-07-11 🚩 Expands feature flag handling with persistence
2025-07-11 ✨ Adds yertle model visulization
    [femur.obj, femur.stl, frame.obj, frame.stl, lb shoulder.obj, lb shoulder.stl, lf shoulder.obj, lf shoulder.stl]
2025-07-11 ✨ Makes socket messages event typed
2025-07-12 🐛 Excludes models files for other variants when building
2025-07-16 ⚡️ Adds build flags for speed and gc
2025-07-16 🔥 Removes certs
2025-07-16 🔥 Cleans up peripherals service
2025-07-16 ⚡️ Removes unnecessary lerp
2025-07-16 🎨 Inlines cors wildcard
2025-07-16 📝 Updates readme
2025-07-16 🎨 Formats extensions.json
2025-07-16 🎨 Replace magic number for stand_frac
    [bezier_state.h]
2025-07-16 🎨 Matches command mapping in frontend
2025-07-16 ✅ Simplifies frontend test
2025-08-02 🐛 Fixes the relative paths
2025-08-03 🐛 Removes camera endpoint using feature flag
2025-08-11 ✨ Adds gif of short walk
2025-08-21 ✨ Enables better zoom for viz
2025-08-22 ✨ Adds kinematics for spot pico
2025-09-01 🎨 Updates and simplifies command handling
2025-09-01 🚩 Add feature flag for spot pico
2025-09-01 🐛 Expands number of endpoints
2025-09-01 🎨 Renames topics
2025-09-01 🎨 Update the rotation command handling
2025-09-04 🎨 Cleans up gait handling code
2025-09-04 🎨 Adds defaults to notification service
2025-09-04 🎨 Renames kinematics config
2025-09-04 🎨 Cleanup crawl
2025-09-04 🎨 Adds speed factor between gaits
2025-09-04 🐛 Try to handle body shifting
2025-09-04 🎨 Simplifies gait
2025-09-04 🎨 Better base walking speed
2025-09-04 🎨 Adds speed factor to frontend
2025-09-04 🎨 Correct behavoir
2025-09-04 🎨 Smoother crawl body shift
2025-09-04 ✨ Fixes gait into bezier
    [walk_state.h]
2025-09-04 ✨ Introduces kinmatics config to sync mapping between variants
2025-09-04 ✨ Makes kinematics params be based on config
2025-09-04 ✨ Makes motion use target position for body state
2025-09-04 ✨ Makes robot stand compensate imu
2025-09-04 ✨ Makes body rotation controllable
2025-09-04 🐛 Makes step height dynamic
2025-09-04 ✨ Introduces motion as a state machine
2025-09-04 🎨 Renames states folder
2025-09-05 🎨 Moves kinematics config to kinematics file
2025-09-05 🎨 Lerp gait params to target
2025-09-06 🐛 Fixes imu handling
    [imu.h]
2025-09-06 ✨ Makes stand imu compensating
2025-09-08 ⚡️ Improves imu speed by making it non blocking and run faster
2025-09-08 ✨ Makes fsm states by time aware
2025-09-10 🎨 Makes use of msg type for sensors
2025-09-10 ✨ Adds gesture controls
2025-09-10 🎨 Makes gesture sensor more readable and motion take last gesture
2025-09-14 ♻️ Major clean up of project structure
2025-09-14 ♻️ Moves motion implementation to source file
2025-09-14 ♻️ Moves peripherals to source file, add sensor base
2025-09-14 ✨ Adds partion tables
    [default_16MB.csv, default_8MB.csv, huge_app.csv, min_spiffs.csv]
2025-09-14 🚨 Fixes build error for esp-idf
    [camera_service.cpp, gesture.h, mdns_service.cpp, mdns_service.h, motion.cpp, peripherals.cpp, peripherals.h]
2025-09-14 ⬇️ Downgrades fastled version
2025-09-14 ✨ Moves servo event to main
2025-09-14 🎨 Makes file system service use define var
2025-09-14 🐛 Fixes table linking
2025-09-18 🎨 Replaces delay with vTaskDelay
    [gesture.h, peripherals.cpp, system_service.cpp, wifi_service.cpp]
2025-09-18 🎨 Replace Arduino String with std::string
    [ap_service.cpp, camera_service.cpp, event_socket.cpp, filesystem.cpp, filesystem.h, mdns_service.cpp, peripherals.cpp]
2025-09-18 🔥 Removes unused functions and constants
2025-09-18 ⚡️ Removes task manager dependency
2025-09-18 🔥 Removes unused libs
2025-09-18 🔥 Removes firmware rename script
2025-09-18 🔥 Removes unused feature flags
2025-09-18 🔥 Cleans up build flags
2025-09-18 🐛 Adds servo config over http
2025-09-18 🎨 Renames event socket to websocket adapter
2025-09-18 🎨 Pull subscribe logic out from websocket
2025-09-18 🐛 Adds missing function definitions in socket adapter
2025-10-09 Replace millis with esp timer
    [ap_service.cpp, motion.cpp, motion.h, system_service.cpp, timing.h]
2025-10-09 🔥 Clean up arduino libs
2025-10-09 ✨ Adds option to rotate gesture sensor
2025-10-09 🎨 Clamp servo pwm
2025-10-10 🤖 Adds initial sim structure
    [backpart.stl, foot.stl, frontpart.stl, larm.stl, larm_cover.stl, lfoot.stl, lshoulder.stl, mainbody.stl]
2025-10-10 🤖 Adds plane
2025-10-10 🧹 Formats urdf
    [spot.urdf]
2025-10-10 📏 Tries to rebuild kinematics in python
2025-10-10 🪴 Adds gitignore for python
2025-10-10 🍒 Saves the initial state for faster reload
2025-10-10 🛹 Adds static gui to env
2025-10-10 🎯 Updates number of solve iterations
2025-10-10 🪇 Adds git input function to GUI
2025-10-10 🧼 Removes print
2025-10-10 🧁 Simplifies backpart stl
    [backpart.stl]
2025-10-10 🫐 Updates foot color for urdf
    [spot.urdf]
2025-10-10 ♻️ Update sim structure
    [backpart.stl, foot.stl, frontpart.stl, larm.stl, larm_cover.stl, lfoot.stl, lshoulder.stl, mainbody.stl]
2025-10-10 Fixes body kin rot
    [kinematics.py]
2025-10-10 🐛 Fixes many smaller simulation pains
    [gait.py, kinematics.py, play.py]
2025-10-10 ✨ Adds script to play with kinematics
2025-10-10 🎨 Fixes gait in sim
    [gait.py, kinematics.py, play.py]
2025-10-10 🔥 Remove simple play kinematics
2025-10-10 🎨 Use real variables
2025-10-10 ✨ Updates training script with stablebaseline
2025-10-10 🔥 Clean up gitignore
2025-10-10 ⚡️ Makes training parallelized
2025-10-10 ✨ Adds option to control sim using web app
2025-10-10 🎨 Updates readme
2025-10-10 🎨 Adds kinematics config to readme
2025-10-11 🎨 format
2025-10-11 🎨 Lint project
2025-10-11 ⬆️ Upgrade frontend dependencies
2025-10-11 🎨 Improves mode handling
2025-10-11 🎨 Updates duty and fixes direction angle
    [walk_state.h]
2025-10-11 🎨 Updates defaults motion smoothing
2025-10-14 🎮 Maps controller buttons to modes
2025-10-14 🎨 Fix different typing problems
2025-10-20 🎨 Removes deprecated base
2025-10-20 ✨ Adds cumulative displacement of the robot
2025-10-20 🎨 Adds rotation keyboard controls
2025-10-20 🐛 Fix stl relative model path
2025-10-20 🎨 Improve rotation handling
2025-10-20 🎨 Reduce stand offset
2025-10-20 🎨 Set 3D representation as default view
2025-10-20 🐛 Fix model loading on github pages
2025-10-20 🐛 Fix relative path in app
2025-10-20 🎨 Remove sky in favor of static background color
2025-10-20 🐛 Fixes drag angles handling
2025-10-23 🎨 Update observation space to match real world
2025-11-04 🐛 Fixes barometer
2025-11-27 Fixed esp32 prebuild FS directory location
2025-11-27 🐛 Call begin on camera service
2025-11-27 🐛 Fix system metric emit
    [main.cpp, system_service.cpp, system_service.h]
2025-11-27 ✨ Emit imu, mag and bmp data
2025-11-27 🐛 Fix socket deadlock
2025-11-27 🐛 Imu temp in message
2025-11-27 🐛 Fix imu and magnotometer
    [imu.h, main.cpp]
2025-11-27 ✨ Adds system metrics endpoints
2025-12-08 🐛 Update base step height in visualizer
2025-12-20 🎨 Adds endpoints for wifi and ap
2025-12-23 Adds rest of missing api endpoints
    [main.cpp]
2025-12-24 🚨 Fix warnings
2025-12-24 ✨ Adds imu calibration
2025-12-24 ♻️ Change kinematics units to SI
2025-12-25 ♻️ Adds filesystems endpoints back
2025-12-25 🐛 Map rotation bound correct in rad
    [kinematics.h]
2025-12-25 🐛 Secure sub and unsub with mutex
2025-12-25 ♻️ Remove duplicate ping pong handling
2025-12-25 ✨ Make read imu and mag be timing based
2025-12-25 🎨 Handle static config files
2025-12-25 🎨 Update connection url
2025-12-25 🎨 Improve ui of servo calibration tool
2025-12-25 🎨 Fix camera on robot
2025-12-25 🎨 Improve controller bar ui
2025-12-29 🐛 Expands the number of allowed endpoints
2026-01-02 🚨 Fix linting errors
    [pnpm-lock.yaml]
2026-01-02 ♻️ Moves throttling to socket out
2026-01-02 ♻️ Makes smoothing be a const
2026-01-03 ⚡ Set Svelte bundleStrategy single
2026-01-03 ♻️ Fix pitch and roll units
    [kinematics.h]
2026-01-03 Revert "Added protobufs for TS"
    This reverts commit 37b9baf7c8d9bf33c3ac29063f8ee697b20ef497.
    [pnpm-lock.yaml]
2026-01-03 Attempt at implementing PB sending for ESP32
2026-01-03 Start of svelte socket rewrite
2026-01-03 Generation of type translation for socket (claude assisted)
2026-01-03 Socket on, off, decodemsg and onmsg updated
2026-01-03 Added protoMetadata and trying to fix sub and unsub
    [pnpm-lock.yaml]
2026-01-03 All errors gone from socket.ts (logic errors might still be present)
2026-01-03 Updated servo angles and kinematic data
2026-01-03 📈 Fixed TargetAngles, Gaits and more angles
2026-01-03 Fix imu data among other things, start at wifi fix
2026-01-03 🦉Updated protoc to include reference to other protos
2026-01-03 🛜 Fixed wifi with protobuf, added rest message proto
2026-01-03 🏌️‍♀️First iteration of proto building workflow
2026-01-03 Fixed up IMU properly this time
2026-01-03 🔧 Fixed i2c settings
2026-01-03 Fix i2c svelte
2026-01-03 🏍️ Fixed servos svelte
2026-01-03 Updated socket test to use up to date structures
2026-01-03 Updated proto and embedded build for nanopb + esp fix
    [main.cpp]
2026-01-03 🎨 Format and simplify controls
2026-01-03 🐛 Subscribe to socket event
2026-01-03 ♻️ Makes messages use static array and sizes
2026-01-03 ♻️ Cleanup socket
2026-01-03 🐛 Resubscribe to events after reconnect
2026-01-03 BIG mistake in socket causing no messages to be delivered
2026-01-03 Protobufs to esp: broken endpoints to make protobuf work
    [main.cpp, system_service.cpp, system_service.h]
2026-01-03 ♻️ Updates combase to use protobufs
2026-01-03 ♻️ Handle incomming messages
2026-01-03 🔥 Remove json from sensor implementations
2026-01-03 🔥 Removes http system metrics
2026-01-03 ♻️ Replace arduino math function with cmath
    [kinematics.h]
2026-01-03 ⚡ Removes msgpack and json build flags
2026-01-03 🔥 Removes stateful socket
2026-01-03 🐸 Sending and receiving a correlated request (WIP)
2026-01-03 Updated socket test to pass
2026-01-03 ♻️ Const cast strings in feature
2026-01-03 🔨 Adds build script for ts proto
2026-01-03 ✨ Adds promise based request reponse system
2026-01-03 ♻️ Makes imu calibration use request reponse
2026-01-03 🙈 Ignore auto generated proto files
2026-01-03 ✨ Quest socket request when connection down
2026-01-03 ♻️ Makes feature flags be fetched over socket
2026-01-03 🔥 Removes example project
2026-01-03 🔨 makes proto generation be part of build script
2026-01-03 👷 Update proto build system
2026-01-03 👷 Remove $type keys
2026-01-03 ♻️ Adds requirements
2026-01-03 🚚 Rename websocket_message to messages
2026-01-03 🔥 Removes test route
2026-01-03 🚚 Moves system metrics out of main
2026-01-03 ♻️ Moves analytics subscription handling to store
2026-01-03 ♻️ Makes IMU store handle data subscription
2026-01-03 💥 Update change log
2026-01-03 📝 Updates api documentation
2026-01-03 🚚 Renames controller data
2026-01-03 📝 Adds websocket docs
2026-01-03 🚚 Rename sendEvent to emit
2026-01-03 ♻️ Adds ws back for testing
2026-01-03 ⚡ Make ip be uint32 instead of strings
2026-01-03 🔥 Cleanup factory settings
2026-01-22 Claude: Fixing esp side (and stupid amount of .md)
    [main.cpp]
2026-01-22 Increased socket size to fix fs chunking
2026-01-22 Added error logging for ws send, and naming for fs ws
    [filesystem_ws.cpp]
2026-01-22 Upped chunk size to 16kb (down not working)
    [filesystem_ws.cpp, filesystem_ws.h]
2026-01-22 Dynamic allocation of protobuf encoder on huge messages
2026-01-22 Fixed comments and useless function declarations
    [filesystem_ws.cpp]
2026-01-22 ⚡ Makes TransferId uint32
2026-01-22 ♻️ Makes use of tailwind for styling
2026-01-22 ♻️ Update the typing for chunkedTranfer
2026-01-22 ♻️ Clean up
2026-01-24 ✨ Adds native http wrapper to replace psychic
    [native_server.cpp, native_websocket.cpp]
2026-01-24 ⚡ Removes PsychicHttp dependency
2026-01-24 ⚡ Removes max file upload and secure getWsClients
2026-01-24 ♻️ Removes PsychicHttp package from software desc
2026-01-24 🎨 Renames webserver and websocket
2026-01-29 🐛 Fix walking condition
    [kinematics.h, walk_state.h]
2026-01-29 🐛 Fix visualization world rotation
2026-01-29 🐛 Fix the visualization world coordinate frame
2026-01-29 🐛 Clamps imu compensation to max roll and pitch
2026-01-30 ⚡ Replace third party libs with i2c bus drivers
    [barometer.h, bmp180.h, bno055.h, gesture.h, hmc5883l.h, i2c_bus.h, imu.h, main.cpp]
2026-01-30 🐛 Fixes mpu6050 dmp
    [mpu6050.h]
2026-01-30 🎨 Adds fallback heading to be z axis
2026-01-30 ♻️ Only collect messages when there subscribers
2026-01-30 ✨ Adds heading chart
2026-01-30 ♻️ Changes timing logging to only warn
2026-01-30 ♻️ Replace more arduino functions with native
    [filesystem_ws.cpp, filesystem_ws.h, main.cpp, peripherals.h]
2026-01-31 Removed JSON from ap settings and service -> preparing to remake servo
2026-01-31 Converted servocontroller to protobufs + persistance defaults
2026-01-31 Updating servo table data for Svelte
2026-01-31 Revert filesystem as it makes more sense to do over socket
2026-01-31 UNTESTED: fix for sending proper content type on config endpoint
    [filesystem.cpp]
2026-01-31 Fixed custom url matcher
    [webserver.cpp]
2026-01-31 Camera api to protobuf - still and stream not tested
2026-01-31 Default center angle of servos to 2
2026-01-31 ⚡ Full migration to esp-idf
2026-01-31 ♻️ Handle merging
2026-01-31 ♻️ Moves sdkconfig.defaults
2026-01-31 🎨 Update monitor filters
2026-01-31 🐛 Handle spa
2026-01-31 ⚡ Sets cpu freq to 240
2026-01-31 ⚡ Makes wifi try to connect to latest
2026-01-31 🔥 Removes old stateful persistence
2026-02-09 ✨ Adds support for esp32 P4
    [default_32MB.csv]
2026-02-09 🙏 Working camera stream with p4
2026-02-09 ✨ Adds working camera stream for p4 with correct colors and good perf
    [camera_service.cpp]
2026-02-09 ⚡ Clean up macros
2026-03-06 🐛 ESP P4 i2c pull up
2026-03-20 🐛 Use mpu.heading for heading calculations
2026-05-11 🔥 Removes unused sim test script
2026-05-11 ✨ Switch to UV
2026-06-28 🎨 Fixes svelte build warning
2026-06-28 🎨 Improve memory safety
2026-06-28 🎨 Rename vars
2026-06-28 ⚡ Adds safefail function for controller disconnect
2026-08-26 🎨 Widens body pose limits and caps body height
2026-08-26 🐛 Uses a dedicated yaw step length for rotation arcs
2026-08-26 ✨ Scales gait duty factor with commanded velocity
2026-08-26 🐛 Clamps gait phase advance to a minimum velocity
2026-08-26 🐛 Fixes swapped y and z offsets in yawArc
2026-08-26 🎨 Updates yertle coxa and body length dimensions
2026-08-26 🐛 Strips variant version suffixes when resolving a variant
2026-08-26 ✨ Adds a websocket latency readout to the status bar
2026-08-26 ✅ Adds history store unit tests
2026-08-26 🎨 Removes unused imports
2026-08-26 🎨 Uses const for the decoded protobuf response
2026-08-26 🎨 Adds keys to keyed-each blocks
2026-08-26 🎨 Replaces any with typed message assertions in socket tests
2026-08-26 🎨 Applies prettier formatting to unformatted app files
2026-08-26 ✨ Adds a connection status indicator to the status bar
2026-08-26 💄 Rewrites the landing empty state layout and copy
2026-08-26 🐛 Removes misspelled base-content theme overrides
2026-08-26 🔥 Deletes the unused FileManager component
2026-08-26 🔥 Deletes the unused TopBar component
2026-08-26 🐛 Replaces hardcoded palette colors with theme tokens
2026-08-26 🐛 Makes prettier accept native line endings
2026-08-26 💄 Drops the emoji from the gamepad toast
2026-08-26 🎨 Shortens the widget-components comment
2026-08-26 🎨 Removes the duplicate daisyui plugin declaration
2026-08-26 🔥 Removes unused autoprefixer and adapter-auto dependencies
2026-08-26 🔥 Removes the inert husky pre-commit hook
2026-08-26 🔥 Removes the stray medium.zip artifact
2026-08-26 🐛 Fixes the sleep endpoint path on the system status page
2026-08-26 🐛 Surfaces system status request failures instead of swallowing them
2026-08-26 ✅ Adds kinematics invariance and NaN-guard tests
2026-08-26 🐛 Completes the body state fixture in the kinematics tests
2026-08-26 🔥 Removes unused utility and store exports
2026-08-26 🐛 Times out websocket requests queued while disconnected
2026-08-26 ✅ Adds tests for disconnected request timeout and supersede
2026-08-26 🔥 Removes the commented-out settings placeholder route
2026-08-26 ✅ Adds SvelteKit module stubs so lib code is unit testable
2026-08-26 🐛 Names the gait step delta as milliseconds to match its callers
2026-08-26 ♻️ Replaces the yaw arc with rigid-body velocity composition
2026-08-26 ✅ Adds gait stroke direction and swing height tests
2026-08-26 🎨 Guards the vertical stroke per foot rather than per command
2026-08-26 ♻️ Replaces the firmware yaw arc with rigid-body velocity composition
    [walk_state.h]
2026-08-26 ♻️ Replaces the sim yaw arc with rigid-body velocity composition
    [firmware_gait.py]
2026-08-26 ✅ Adds gait stroke geometry tests for the sim baseline
2026-08-26 📝 Updates the gait module docstring for the new stroke composition
2026-08-26 🔥 Deletes the unused Collapsible and OrientationIndicator components
2026-08-26 🔥 Deletes the unregistered service worker
2026-08-26 ✨ Sends a neutral command when the controller tab is backgrounded
2026-08-26 ✅ Adds tests for the neutralised controller command
2026-08-26 ✨ Adds haptic feedback for stop and mode transitions
2026-08-26 ⚡ Observes the canvas for resize and pauses rendering when offscreen
2026-08-26 ♻️ Moves the socket onto a pluggable transport
2026-08-26 ✨ Adds a Web Bluetooth transport matching robot_comm_ble framing
2026-08-26 ✅ Pins the BLE wire contract against robot_comm_ble
2026-08-26 ✨ Adds a Bluetooth pairing card to the connection page
2026-08-26 ✨ Labels the status indicator with the active transport
2026-08-26 ✨ Adds robot discovery by websocket probe and a saved robot list
2026-08-26 ✨ Replaces the connection and latency badges with a link dropdown
2026-08-26 💄 Rebuilds the landing page around finding and connecting to a robot
2026-08-27 ♻️ Extracts the shared Bluetooth pairing flow
2026-08-27 🔥 Removes the unused result service and error log store
2026-08-27 ✅ Adds tests for the Bluetooth pairing flow
2026-09-07 🐛 Drops the app dependency on the unbuildable robot_core bindings
2026-09-28 🔥 Removes the unused tfmicro library and the stale gait test
2026-09-28 🐛 Stops forcing PSRAM on boards without it and commits per-target sdkconfig defaults
2026-09-28 🐛 Returns 404 instead of 405 for unknown web routes and logs failed route registrations
    [main.cpp, webserver.cpp, www_mount.cpp]
2026-09-28 🐛 Fails the firmware build when the web app or the protos fail to build
2026-09-28 🔥 Removes the GitHub firmware download path, which had no firmware endpoint behind it
2026-09-28 💚 Fixes the hanging frontend CI and gates it on lint, type check and simulation tests
    [pnpm-lock.yaml]
2026-09-28 🎨 Enforces LF line endings and fixes the remaining lint errors
2026-09-28 ✨ Adds an ESP Web Tools flasher, tagged firmware releases and a CI build of every board
2026-09-28 🐛 Removes the tolerant IK cache that held joint commands until the pose moved 1 mm
2026-09-28 📝 Updates the readme and software docs for the MuJoCo simulation and the build toolchain
2026-09-28 🙈 Commits env.d.ts in the format its generator writes so builds leave the tree clean
2026-09-28 📌 Pins the XIAO build to platform 6.8.1 and the P4 build to pioarduino 55.03.39
2026-09-28 💚 Gives the XIAO its 8 MB partition table and pins PlatformIO Core 6.1.19 for the P4 platform
2026-09-28 📌 Pins esp_hosted to 2.x so the P4 build avoids the 3.x -include that pioarduino splits
2026-09-29 ✅ Lets unit tests mount Svelte components
2026-09-29 🐛 Fixes load, error and offline states, robot URLs and accessibility across the app
2026-09-29 🐛 Stops a replaced or dropped connection from closing its successor or recursing on close
2026-09-29 🐛 Waits for the local network prompt before discovery probes time out
2026-09-29 ✨ Identifies robots by factory MAC and keeps one named entry per robot
2026-09-29 🐛 Adds the Mini variant and matches Yertle's dimensions to the firmware
2026-09-29 ✨ Remembers each robot's own mDNS name so it is found after its IP changes
2026-09-29 🎨 Formats the variant kinematics test
2026-09-29 🔥 Removes the firmware update page, which no firmware endpoint serves
2026-09-29 🐛 Makes throttled commands always deliver the latest value, so releasing a joystick stops the robot
2026-09-29 🐛 Clamps gamepad height, tolerates pads without a d-pad and lets deactivate win
2026-09-29 📱 Gives portrait phones both joysticks, fits the controls to the screen and stops controller leaks
2026-09-29 🐛 Sets the embedded-build flag only in build:embedded, so the hosted app remembers the robot address
2026-09-29 ⚡ Leaves three.js and the robot models out of the app built into the firmware
2026-09-29 ✨ Shows the Pico with its own model, generated from the simulation, in its CAD stance
2026-09-29 📝 Adds the design for a MuJoCo simulation view in the web app
2026-09-29 📝 Adds the implementation plan for the MuJoCo simulation view
2026-09-29 ✅ Exports a golden trace of the Pico gait for the web app's port
2026-09-29 ✨ Ports the Pico gait and IK to TypeScript, pinned to the Python simulation
2026-09-29 🔧 Publishes the Pico scene and gait tuning for the browser simulation
2026-09-29 ✨ Simulates the Pico in MuJoCo's WASM build with the ported controller
2026-09-29 ✨ Maps the app's joystick and mode to the simulated Pico's command
2026-09-29 ✨ Adds a Simulation view where a MuJoCo Pico follows the app's controls
2026-09-29 🐛 Frees the simulation when its view is left before the engine finished loading
2026-09-29 📝 Adds the design for choosing the robot and controller in the simulation
2026-09-29 📝 Adds the implementation plan for robot selection in the simulation
2026-09-29 ✅ Traces the firmware motion code on the host for each kinematics variant
2026-09-29 ✨ Ports the firmware motion code to TypeScript, pinned to the headers per variant
2026-09-29 ✨ Generates MuJoCo scenes for Spot Micro and Yertle from their URDFs
2026-09-29 ✨ Simulates any robot through one simulation fed by robot definitions
2026-09-29 ✨ Lets the Simulation view switch between the Pico, Spot Micro and Yertle
2026-09-29 ✅ Pins the port's gait stop and IK to longer firmware traces, checked in CI
2026-09-29 🐛 Spawns each robot on the floor from its own collision geometry
2026-09-29 🐛 Frees the previous robot's model when the simulated robot changes
2026-09-29 ✨ Drives the simulated Pico with the firmware's motion code too
2026-09-30 ✨ Adds settings, status and device actions to the socket protocol
2026-09-30 ♻️ Serves settings, status and device actions over the socket instead of REST
2026-09-30 ✨ Moves the settings pages onto the socket
2026-09-30 🔥 Removes the REST settings API and the messages only it used
2026-09-30 🐛 Fixes the review findings for settings over the socket
    [camera_service.cpp, filesystem.cpp, main.cpp, mdns_service.cpp, websocket.cpp, wifi_service.cpp]
2026-09-30 ✨ Keeps WiFi and access point credentials in an untracked secrets.h
2026-09-30 ✨ Shows the simulation on the controller when no robot is set up
2026-09-30 ⬆️ Upgrades to ESP-IDF 5.5.3 so the camera no longer boot-loops beside I2C
2026-09-30 🐛 Starts mDNS again and advertises the robot as _spotmicro._tcp
2026-09-30 🐛 Revalidates the embedded app on every load so firmware updates show
2026-09-30 🐛 Rejoins WiFi after every drop and replies to a WiFi save before reconnecting
2026-09-30 ♻️ Rebuilds the WiFi and access point forms on shared, tested network rules
2026-09-30 🚑 Stops walking when the controller falls silent, and bounds controller input
2026-09-30 🚑 Keeps a held stick alive and stops on every kind of lost link
2026-09-30 🚑 Clamps servo output as a float so a negative angle cannot wrap to the far end stop
2026-09-30 🐛 Reports BNO055 attitude in radians like every other IMU
2026-09-30 🔧 Keeps a core dump of every crash and checks for smashed stacks
2026-09-30 🐛 Locks the I2C bus and keeps one device handle per address
2026-09-30 ⚡ Reads the sensors in their own task and rounds driver waits up to whole ticks
2026-09-30 🐛 Keeps unloadable settings files as backups and skips saves that change nothing
    [ap_service.cpp, camera_service.cpp, peripherals.cpp, servo_controller.h, settings_persistence_test.cpp]
2026-09-30 🔒 Refuses sockets opened by other pages and drops the open CORS headers
2026-09-30 🐛 Keeps the network draft alive while the WiFi editor closes
2026-09-30 🔒 Shows the app a mask instead of stored network passwords
2026-09-30 🐛 Stops the portal DNS only after its task leaves and parses queries instead of overrunning the reply
2026-09-30 🐛 Registers every route before the server starts and refuses any added after
2026-09-30 🐛 Hands out copies of the scan results the WiFi event task replaces
    [wifi_service.cpp]
2026-09-30 🐛 Sweeps abandoned file transfers on the socket task that owns them
2026-09-30 🐛 Reads servo, WiFi and AP settings whole under their lock on the tasks that do not own them
2026-09-30 🐛 Ends a client's subscriptions with its session however the session ends
2026-09-30 🐛 Drops a message it has no memory to encode instead of writing through a null buffer
2026-09-30 🐛 Times out unanswered requests and fails them when their link drops
    [main.cpp]
2026-09-30 🐛 Replaces a file only once its whole upload arrived in order
    [filesystem_ws.cpp, filesystem_ws.h]
2026-09-30 🏷️ Reserves the retired message tags and lets the app skip message kinds it does not know
2026-09-30 ✨ Reports the robot's mode and gait to the app, which shows them without echoing them back
2026-09-30 🐛 Starts a stored setting from its default when the saved value does not parse
2026-09-30 🔥 Removes the unused recovery mode, hook handlers, step length, NTP settings and duplicate camera pins
2026-09-30 🔥 Retires the top-level messages no side sends or handles and reserves their tags
2026-09-30 🔥 Builds Yertle's 3D view meshes from the STLs its URDF names and drops the unused OBJ set
    [femur.obj, frame.obj, lb shoulder.obj, lf shoulder.obj, rb shoulder.obj, rf shoulder.obj, shell.obj, tibia.obj]
2026-09-30 💚 Names the host test step for everything it runs
2026-09-30 🔧 Checks printf formats in the firmware and drops the Arduino-only debug level
2026-09-30 🔧 Rebuilds the embedded app when its protos or build configuration change
2026-09-30 🐛 Lets the fleet's other robots, LAN pages and the hosted app open the socket
2026-09-30 🐛 Sweeps for robots by HTTP first so Chromium's socket throttle cannot hide them
2026-10-01 🔥 Removes sensor getters nothing reads
2026-10-01 🐛 Stops the control loop reading the sensors beside their own task
2026-10-01 ⚡ Runs I2C scans and IMU calibration on the sensor task and replies from there
2026-10-01 🐛 Gives the I2C driver its timeout in milliseconds and writes registers without a stack array
2026-10-01 ⚡ Sends to subscribers without holding the subscription lock
2026-10-01 ⚡ Sends socket frames without waiting on Nagle's algorithm
2026-10-01 ⚡ Keeps the radio awake so steering is not held for the next beacon
2026-10-01 🔥 Drops the Arduino version the IDF firmware always sent empty
2026-10-01 ⚡ Streams downloads a chunk at a time, only into sockets with room, between other clients' frames
2026-10-01 🚨 Builds the temperature sensor config from the driver's default
2026-10-01 🐛 Reads service state under its lock on every task, and copies names into the features reply
2026-10-01 🐛 Refuses robot names too long for the robot to decode instead of waiting out the request
2026-10-01 ✨ Adds the telemetry messages and IMU settings to the protocol
2026-10-01 ✨ Adds the IMU sample and its frame math in the simulation's conventions
2026-10-01 ✨ Adds Madgwick orientation fusion for the IMU
2026-10-01 ♻️ Reads the MPU6050's raw accelerometer and gyro in SI units instead of its DMP
2026-10-01 ♻️ Reports the HMC5883L in microtesla and the BNO055's raw readings beside its own fusion
2026-10-01 ✨ Supports the ICM-20948 and its compass
2026-10-01 ✨ Fuses the IMU in the body frame with gyro bias, mounting and compass calibration
2026-10-01 ♻️ Reads the IMU at 200 Hz through the fused body-frame sample and hands it to the motion state
2026-10-01 ✨ Adds a lock-free ring for handing samples between two tasks
2026-10-01 ✨ Adds the telemetry recorder that batches control ticks for sending
2026-10-01 ✨ Streams every control tick with its timing, IMU sample and servo command to telemetry subscribers
2026-10-01 ✨ Loads robot telemetry recordings into NumPy, pinned to a fixture the firmware's encoder wrote
    [gen_protos.py, recording.py, telemetry_fixture.cpp, test_recording.py]
2026-10-01 💚 Generates the protocol classes before the simulation tests
2026-10-01 ✨ Adds a recorder that streams the robot's telemetry to a file
2026-10-01 ✨ Reports a recording's latencies and IMU noise beside the simulation's assumed ranges
    [domain_rand.py, report_recording.py, telemetry_stats.py, test_report.py]
2026-10-01 🐛 Empties the telemetry ring between recordings so one never starts with the last one's ticks
2026-10-01 🐛 Restarts the control loop's schedule after an overrun instead of replaying every missed tick
    [main.cpp]
2026-10-01 🐛 Finds the ICM-20948 at either address and keeps it as an IMU when its compass does not answer
2026-10-01 🐛 Keeps the orientation through a recalibration and drops a silent compass from the fusion
2026-10-01 🐛 Feeds the stand posture roll into roll and pitch into pitch, with the kinematics' sign
2026-10-01 🐛 Treats three silent seconds as a lost link in the recorder, so it reconnects and marks the gap
2026-10-01 🐛 Waits out the gyro's start-up before the first reading, so the boot calibration sees a still robot as still
2026-10-01 🐛 Reduces a typed robot address to its host and port, so a pasted URL connects
2026-10-01 🐛 Confirms a robot by its greeting with a patient socket probe, so a printer is not listed and a slow socket is not missed
2026-10-01 ✨ Draws each leg's expected pose on the servo calibration page, so a reversed or off-centre servo shows
2026-10-01 🐛 Reverses the stand's roll compensation, measured on the Pico, so it levels the body instead of tipping it to its limit
    [stand_compensation_test.cpp, state.h]
2026-10-01 ♻️ Takes each joint's direction, centre angle and PWM per degree from the variant's joint model
2026-10-01 ✨ Keeps only each joint's centre PWM and channel in the servo settings, and reports the variant's joint model
2026-10-01 ✨ Calibrates each joint by its channel and centre PWM against its drawn reference pose
2026-10-01 🐛 Records the variant's joint model in the telemetry header, so a log's PWM still maps back to angles
2026-10-01 🐛 Starts the servo board asleep with every channel off, so a reset no longer throws the legs to their last pose
    [pca9685.h, pca9685_test.cpp, servo_controller.h]
2026-10-01 ⚡ Limits each joint to the servos' own speed instead of smoothing it, so the gait reaches the servos undistorted
2026-10-01 ✨ Smooths body and gait commands with a critically damped filter that settles in a third of a second at any loop rate
2026-10-01 ✨ Levels the IMU from the calibrate button, folding a lying robot's measured tilt into the mounting
2026-10-01 ✨ Models the firmware gait's body velocity from its sticks, pinned against the firmware's traces
2026-10-01 ✨ Puts the MuJoCo gait loop behind a backend that speaks REP-103 velocities and state
2026-10-01 ✨ Drives the simulation through one Robot facade with distance and turn motions
2026-10-01 ✨ Drives the real robot from Python over its WebSocket, with a keep-alive and a safe exit
2026-10-01 🐛 Accepts the firmware's 200 replies, leaves a stopped robot stopped, and reports a move the dead-man cut short
    [base.py, fake_robot.py, motions.py, real.py, robot.py, scripted_backend.py, sim.py, test_real_backend.py]
2026-10-02 📝 Brings the docs up to date with the firmware, protocol and simulation
2026-10-02 📝 Adds the 0.3.0 changelog
2026-10-02 🔖 Bumps the firmware to 0.3.0
2026-10-02 💚 Searches the firmware headers after the system ones in the host tests so its features.h stops shadowing glibc's
2026-10-02 💚 Syncs SvelteKit before the port tests so vitest finds its generated tsconfig
2026-10-02 💚 Pins the firmware builds to Python 3.13 because ESP-IDF's pydantic-core has no 3.14 wheel
2026-10-03 ✨ Switches to runtime feature flags so one firmware serves every variant and sensor set
2026-10-03 ⚡ Switches the variant live while deactivated instead of restarting
2026-10-03 📝 Adds the runtime feature flags to the 0.3.0 changelog
2026-10-04 ✨ Adds setup over USB with the app's protocol on the serial port beside the log
2026-10-04 🐛 Broadcasts the WiFi status on every change so the page follows the robot joining a network
2026-10-04 🐛 Registers the api types in the socket's message map
2026-10-04 🔥 Deletes log file
2026-10-04 🐛 Points the file chunks and listings at their buffers so a board without PSRAM keeps enough heap to answer the app
2026-10-05 🐛 Joins the network at 20 MHz, since 40 MHz on a crowded 2.4 GHz band stalled the link until the heap ran out
2026-10-05 ⚡ Sends each small socket frame as one TCP segment instead of a header and a payload
2026-10-05 🐛 Skips stream frames a client cannot take yet and closes clients that stop taking any, so a slow link cannot fill the heap
    [comm_base_test.cpp, stall_tracker_test.cpp, webserver.cpp, websocket.cpp]
2026-10-05 🔧 Caps the WiFi driver at 16 dynamic buffers each way so a slow link cannot take the heap of a board without PSRAM
2026-10-05 🐛 Leaves a request unanswered instead of aborting the robot when the heap cannot hold its reply
2026-10-05 📝 Adds the heap and WiFi stall fixes to the changelog
2026-10-05 ✨ Updates the firmware over the socket into the free app slot, with rollback when the new one does not come up
2026-10-05 ✨ Adds a firmware update page that sends a chosen file or the latest release and tells a rollback from success
2026-10-05 👷 Publishes each board's app image for updates over the air and gives the AI-Thinker a second app slot
2026-10-05 🐛 Answers WebSocket pings and close frames, so clients keep a healthy link and close it cleanly
2026-10-05 📝 Merges the changelog's two Changed lists
2026-10-05 🐛 Clocks the I2C bus at 400 kHz at most, the rating of its slowest sensors, also on robots that stored 1 MHz
2026-10-05 📝 Adds the WebSocket control frame fix to the changelog
2026-10-05 ✨ Adds the esp32-s3-n8r2 build, so S3 boards with quad PSRAM like the Spot Pico's get their 2 MB
2026-10-05 🐛 Keeps the whole ELF hash in the app description, so the update page no longer reports every update as a rollback
2026-10-05 ✨ Shapes both sticks with a round dead zone and an axis snap, so a forward push no longer crabs sideways
2026-10-05 ✨ Adds a Configuration page that saves a robot's calibration and peripheral settings to a file and loads them back
2026-10-05 ✨ Shows each saved robot's firmware version and build on the start page
2026-10-05 ✨ Eases the feet into stand and rest with a minimum-jerk move instead of snapping a foot down from mid-stride
    [motion_service_test.cpp, rest_state.h, stand_state.h, state.h]
2026-10-05 ✨ Ports the Hexapod's animation clips, evaluator and player to four legs, with REP-103 offsets pinned to Leika's body
2026-10-05 ✨ Adds the animation file format, embedded built-in clips (sit, bow, wave) and a reachability sweep that checks them on every variant
2026-10-05 ✨ Plays animation clips as a motion state that starts from the live legs and hands back to the mode it came from
2026-10-05 ✨ Lists, validates, plays and stops animation clips over the socket and streams their status
2026-10-05 ✅ Pins the app's clip validator to the firmware's with fixtures both test suites read
2026-10-05 ✨ Adds an Animations page that lists, inspects, plays, stops, uploads and deletes clips on the robot
2026-10-05 ✨ Reports unreachable feet from the app's port of the firmware IK
2026-10-05 ✅ Exports traces of the firmware's animation player for the app's port to follow
2026-10-05 ✨ Ports the animation evaluator and player to the app, pinned to the firmware's traces
2026-10-05 ✨ Adds the animation editor's document store with a preview the firmware would play
2026-10-05 ✨ Previews animation clips on the robot's 3D model, placed from its own toes, with draggable feet
2026-10-05 🚨 Drops an unused import from the animation preview
2026-10-05 ✨ Adds the animation editor: timeline, pose and clip panels and a 3D preview, opened from the library
2026-10-05 🐛 Subscribes a stream again when a view that dropped it mounts again
2026-10-05 🐛 Shows the editor's 3D model, fitted mirrored where it is, and clip values as typed
2026-10-05 📝 Notes the animation editor and the stream fix in the changelog
2026-10-11 📝 Documents animations: playing, the clip format, built-in and uploaded clips and their tests
2026-10-11 ✅ Adds a golden of the proto wire numbers that fails CI on renumbering or removal
2026-10-11 👷 Runs the simulation tests without the CUDA wheels and against freshly traced firmware
2026-10-11 🔒 Refuses file API paths under /config, relative or with dot segments, and hides /config from listings
2026-10-11 ✨ Connects to the strongest saved WiFi first when the setting asks for it
2026-10-11 🐛 Writes settings beside their file and moves them over it, so a reset mid-save keeps the old settings
2026-10-11 🐛 Reports the WiFi mode the firmware started, not the one an earlier firmware left in NVS
2026-10-11 🐛 Raises the socket limit to 16 so the access point's DNS server and seven web sessions fit together
2026-10-11 🐛 Refuses a factory image from its head instead of after the whole upload
2026-10-11 ✅ Pins the simulation's firmware gait port to the firmware's own traces
2026-10-11 ✨ Counts I2C NACKs and timeouts per device and shows them in the system metrics
2026-10-11 🦺 Watches the control and sensor tasks with the task watchdog and restarts the board when one hangs
2026-10-11 ✨ Shows a newer firmware release in the status bar, linking to the firmware page
2026-10-11 🔥 Removes the Playwright smoke test and builds the app in the frontend workflow instead
2026-10-11 🐛 Clocks a device holding SDA low free, at most once a second, and reports the recoveries
2026-10-11 ⚡ Backs off servo writes to a board that stops answering and starts it again when it returns
2026-10-11 🐛 Sinks a stance foot along its stroke, so diagonal and turning strides lift off level
2026-10-11 ✨ Reports each core's CPU usage in the analytics and charts it in the system metrics
2026-10-11 ✨ Carries driving, modes and streams over the USB-Serial-JTAG port, leaving the console UART to requests
2026-10-11 ✨ Tells that a board's native USB port drives and streams, and tests both over the serial link
2026-10-11 ✨ Shows the robot's reported joints in the 3D view instead of a local gait
2026-10-11 ✨ Drives and records the robot over its native USB port from the Python client, opened without a reset
2026-10-11 📝 Documents what each USB port carries and how a serial client that leaves is dropped
2026-10-12 🦺 Stops a clip when the client that started it leaves
2026-10-12 🔥 Removes the app's own gait and the servo angles it sent, which the robot never drove anything with
2026-10-12 ♻️ Reads the whole ELF hash from the app description instead of widening ESP-IDF's retrieve length
2026-10-12 ✨ Ports the stand's IMU levelling into the simulation and measures on a tilted floor which +z side it levels for
2026-10-12 📝 Documents how the app reaches the robot from each origin and which transports exist
2026-10-12 📝 Adds a root CLAUDE.md with the commands, the parts that must stay in sync and the firmware's task layout
2026-10-12 🐛 Counts a reboot mid-recording instead of negative missing ticks, drops only those during the recording, and reports a recording without ticks
2026-10-12 🐛 Retries a refused WebSocket handshake in the recorder instead of ending the recording
2026-10-12 📝 Says in the recorder and the report that gen_protos.py must run first
2026-10-12 🐛 Refuses a slow steady tilt as gyro bias and reads an IMU slower than the sensor task once per sample
2026-10-12 ✅ Traces wave at its defaults, played through to the end, beside the stopped wave
2026-10-12 ✨ Adds the animation physics check: plays the firmware's animation trace on the Pico in MuJoCo and fails on clamps, servo overspeed, knocks, tips and falls
2026-10-12 👷 Traces the firmware animation player in the simulation workflow so the physics check gates the built-in clips
2026-10-12 ♻️ Streams a download from any source, not only from an open file
2026-10-12 🐛 Sleeps through the IMU calibration on the sensor timer instead of busy-waiting, applies IMU settings through a flag the full work queue cannot drop, and saturates the command age
2026-10-12 ✨ Reports the stored core dump's crash summary, streams the dump as a download and erases it
2026-10-12 ✨ Shows the last crash on the status page, with a download of its core dump and an erase
2026-10-12 📝 Documents the core dump requests and how to decode a downloaded dump with esp-coredump
2026-10-12 ✨ Adds integral action to the stand's IMU compensation, in the firmware, the app's port and the simulation, so a slope is levelled fully instead of halfway
2026-10-12 ♻️ Moves JOINT_DIRECTION into the joint model header, so the servo side can turn servo angles back into IK angles
2026-10-12 ✨ Holds each servo target inside its joint's travel, a range per variant in the joint model, and logs the furthest target it held
2026-10-12 ✨ Flags a joint a clip drives past its travel in the animation check, so a crouch folding a leg into the body no longer passes
2026-10-12 🐛 Fixes the swing foot dropping onto its stance spot for a tick at the end of a swing, where (1 - t)^11 underflowed
2026-10-12 🦺 Deactivates a robot that leans past 60 degrees for 300 ms, so a fallen robot's legs go limp instead of stalling against the floor
2026-10-12 🐛 Holds the stand's IMU compensation until the takeover has eased the feet in, in the firmware, the app's port and the simulation, so it does not level against and integrate the tilt the rise from RE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
2026-10-12 ✅ Rises the simulated robot from REST to STAND, which does not tip on a flat floor, and shows with one lagging leg that the held compensation settles in 0.8 s where levelling at once took 2.1 s
2026-10-12 ♻️ Moves the telemetry tick sample out of main.cpp, so a host program records ticks as the control task does
2026-10-12 ✨ Adds a virtual robot built from the firmware's own C++ and served on a local WebSocket, for the app and the Python client to drive without hardware
2026-10-12 ✨ Adds a release smoke check that walks a robot in each gait and fails on overruns, failed servo writes, PWM clamps or a fired dead-man stop
2026-10-12 👷 Builds the virtual robot in the simulation workflow and runs the release smoke check against it
2026-10-12 📝 Documents the virtual robot, pointing the app at it, and the release smoke check
2026-10-12 ✨ Reports whether a robot's servos were calibrated and says so in the start page's robot list
2026-10-12 ✨ Adds kinematic dead reckoning: the body's position, heading and distance from the stance feet, fed each control tick
2026-10-12 🐛 Fixes a diagonal or turning stance ending in the air, so its foot jumped onto the swing
2026-10-12 ✨ Adds the ESP-NOW handheld controller's packet from the Hexapod and its mapping onto the app's input, mode and gait, with host tests
2026-10-12 ✨ Adds the ESP-NOW controller receiver, off by default and switched on in the peripheral settings, with a channel beacon for the controller to find the robot
2026-10-12 ✨ Adds the ESP-NOW controller switch to the Sensors page on boards with a radio for it
2026-10-12 📝 Documents the ESP-NOW handheld controller: its mapping, setting and channel beacon
2026-10-12 ⬆️ Moves the ESP32-P4 to pioarduino 55.03.312-1 and CI to PlatformIO 6.2.0, whose SCons both now share
2026-10-12 ✨ Steps the gestures along rest, sit and stand, with down from stand sitting, and drops a gesture that arrives while a clip moves the legs
2026-10-12 ✨ Exposes the odometry in every telemetry tick and as a request that reads it and resets it
2026-10-12 ✨ Reads the odometry from the Python client, with a simulation port pinned to the firmware's traces and checked against MuJoCo
2026-10-12 📝 Notes the odometry in the changelog
2026-10-12 ✨ Fits the compass's hard-iron offset to a recording of the robot turned through every orientation and stores it on the robot
2026-10-12 ✨ Adds Hexapod's length-prefixed BLE framing to the firmware and the app, pinned by shared vectors
2026-10-12 ✨ Adds a radio-agnostic BLE link on CommAdapterBase that answers framed requests and drops a connection it cut a message on
2026-10-12 ✨ Mounts an SD card at /sdcard on boards with a 1-bit slot, after Niklas Jensen's 8d4ce16, leaving the LittleFS paths alone
2026-10-12 🔒 Obeys only the first handheld controller heard after the receiver starts, so another controller in range cannot drive the robot
2026-10-12 ✨ Slows the walk where a step would turn a joint faster than the servos follow, instead of letting them clip it into shorter, later steps
2026-10-12 ✨ Models the walk's slowing in the Python client's speed model, so the velocity it asks for is the one the robot walks
2026-10-12 ✨ Caps the joint speed of the simulation's gait as the firmware does
2026-10-12 ✨ Hands socket listeners the frame as it arrived beside the decoded message, for a recorder that keeps the robot's bytes
2026-10-12 ✨ Adds the .leika writer, loader and report statistics to the app, checked byte for byte and number for number against the Python loader
2026-10-12 ✨ Adds telemetry recording to the System Metrics page: record, stop and download a .leika file, with the latency and IMU-noise report shown on stop
2026-10-12 📝 Notes telemetry recording from the app in the changelog
2026-10-12 ✨ Serves the app over a NimBLE Nordic UART Service on the S3 boards, with commands, requests and streams but no telemetry, files or firmware
2026-10-12 ✨ Frames the app's Bluetooth messages as the firmware does, so a message may span several writes and notifications
2026-10-12 📝 Describes the Bluetooth link, its boards, framing, messages and memory
2026-10-12 🐛 Lands a raised foot along its swing when the walk stops and then holds the phase, instead of dropping the foot in one tick
2026-10-12 ✨ Gives the simulated servos the MG92B's torque-speed line, so they slow under load and give way past stall, with the supply voltage domain-randomised between its 4.8 and 6.0 V ratings
2026-10-12 ✨ Adds an ESP-IDF driver for two HC-SR04 sonars: set in the peripheral settings, pinged in turn and timed by a GPIO interrupt, reporting no echo and no sensor apart from a distance
2026-10-12 ✨ Adds the sonars to the Sensors page, with their pins checked against I2C, the LEDs and each other, and their readings to the IMU page
2026-10-12 📝 Documents the HC-SR04 sonars: their settings, the echo's 5 V divider and their stream
2026-10-12 ✨ Adds terrain and payload stages to the simulation - a payload with an off-centre centre of mass, bumps, slopes and stairs - and a schedule that advances train_mj.py through them by episode success 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
2026-10-12 📝 Notes the servo torque-speed line and the terrain and payload stages in the changelog
2026-10-12 ✨ Adds a sim-versus-real harness that replays one velocity script on the simulation and on a Pico and reports the joint, cadence, foot-phase and tilt drift per segment against stated thresholds
2026-10-12 👷 Runs the sim-versus-real comparison against the virtual robot in the simulation workflow, also when the app's Pico joint map changes
2026-10-12 📝 Documents the sim-versus-real harness: running it against a Pico, reading its report, and how far the simulation and the firmware are apart today
2026-10-12 ✨ Poses the model by the calibration page's servo angles, the Pico's knees through their four-bar linkage
2026-10-12 ✨ Shows the robot's 3D model on the servo calibration page, posed by the PWM being set and the selected joint highlighted
2026-10-12 ✨ Adds a controller view with the robot's reported pose beside the simulation
2026-10-12 📝 Notes the calibration page's 3D model and the robot beside the simulation in the changelog
2026-10-12 🐛 Moves the XIAO ESP32S3's default LED strip pin to D0, off the camera's Y7 data line on GPIO 12
2026-10-12 🐛 Moves the core dump requests to tags 230-232, clear of the animation requests' 220-223
2026-10-12 🐛 Moves the odometry request to tag 240, clear of the animation requests' 220-223
2026-10-12 💬 Says on the Sensors page that the robot obeys the first controller it hears
2026-10-12 ✨ Adds goal moves to the motion service: a distance or a turn driven on the odometry, ended by a cancel, the app's sticks, a mode, a gait, its client leaving or a timeout
2026-10-12 ✨ Takes goal moves over the socket: goal_move, goal_cancel and goal_status requests, a status broadcast on every change, and a cancel when the client that asked leaves
2026-10-12 ✨ Ports the goal controller to the simulation, pinned to a trace of the firmware's that the host tests keep current
2026-10-12 ✨ Adds Robot.goal_move to the Python client, on the robot and in the simulation, and walks moves and turns as goals where the robot takes them
2026-10-12 📝 Documents goal moves in the motion system, the API and the Python client, and notes them in the changelog
2026-10-12 ✨ Ports walk-nn's spot_pico kinematics and residual gait, the policy exporter and golden vectors that pin them to the simulation
2026-10-12 ✨ Adds the WALK_NN mode: the residual policy on the spot_pico gait, mapped onto the Mini's joint model, refused unless a policy that passed its self-check is built in
2026-10-12 ✨ Offers the learned walk in the mode selector only when the robot reports a policy
2026-10-12 📝 Describes exporting a policy to WALK_NN and what to check on the robot before it walks
2026-10-12 🐛 Reads JOINT_DIRECTION from joint_model.h in the animation check and opens the compass test's robot on either transport
2026-10-12 🐛 Fixes the Python client's strafe and turn signs: the firmware strafes right on a positive lx and turns left on a positive rx
2026-10-12 ♻️ Runs the simulation, its training and the app's Training controller on the firmware's own MINI walk: its stand height, stride, lift, cadence and smoothing, from the client's velocity-to-sticks map
2026-10-12 🐛 Links the console UART host test with the animation protocol it now needs
2026-10-12 ✅ Tightens the sim-versus-real thresholds to the firmware-aligned gait, so a single reversed joint or a trot starting on the other pair breaches, with the simulation holding each segment as long as t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
2026-10-12 🐛 Bounds the walk's stroke, crawl shift and step height to what each variant's legs reach, where a full stick straightened a knee or folded a foot onto its hip
2026-10-12 ♻️ Ports the walk's reach bound to the app's firmware port and the Python client's speed model, pinned by a trace at full stick on a raised body
2026-10-12 ♻️ Ports the walk's reach bound to the simulation's Pico gait and its app port, where a full forward, sideways and turning command folded a knee to 170 degrees
2026-10-12 ✨ Turns a full circle on a circling gesture and walks 10 cm on a forward or backward one, as goal moves, dropping gestures while a goal runs
2026-10-12 🐛 Fixes the telemetry header reading the joint directions from MotionService after they moved to joint_model.h
2026-10-12 ✨ Fuses the gyro into the odometry's heading, learning its bias while the feet keep still, so goals turn on it and the odometry reports the feet's own yaw beside it
2026-10-12 ✨ Ports the fused odometry to the simulation, pinned to the firmware's traces, and checks it against MuJoCo's heading on a biased gyro
2026-10-12 📝 Documents the fused heading, its noise parameters and what it measures in the simulation
2026-10-12 🩺 Pings the router every 5 s while joined and rejoins after three unanswered pings, since a dead link sends no disconnect
2026-10-12 ✅ Pins the release index the firmware page reads to the env images the release workflow publishes
2026-10-12 👷 Publishes each board's ELF with a release, so a core dump from release firmware decodes without rebuilding it
2026-10-12 🐛 Fixes the telemetry fixture export failing to link without the animation protocol
2026-10-12 📝 Updates the simulation's odometry shortfall in the docs to what the aligned gait measures
2026-10-12 ✅ Stubs pointer capture in the animation editor test, which jsdom lacks and a keyframe drag takes
2026-10-12 ✨ Adds system identification to the simulation: identify.py fits the servo supply, strength and actuator lag by replaying a recording's written angles against its IMU, takes the IMU noise from its st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
2026-10-12 📝 Notes system identification from recordings in the changelog
2026-10-12 🐛 Fixes the odometry and goal moves taking the body's +z as right: it is left, so y and yaw are REP-103 and the feet turn as the gyro does, and a goal left or counter-clockwise sends -lx or +rx; odom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
2026-10-12 🐛 Fixes the fused odometry learning a slow stand twist or shift as gyro bias: it learns only once the body's phi, xm and zm have kept still, as the feet must
2026-10-12 🐛 Leans the standing body right and twists it anticlockwise for the sticks that walk it right and turn it anticlockwise, which STAND did mirrored
2026-10-12 🐛 Names legs 0 and 2 the left ones on the calibration page and draws them on the left, as the body's +z is left
2026-10-12 🔧 Regenerates the proto wire golden for today's schemas, dropping the deliberately deleted AnglesData and the reserved Message.angles and SonarData.dummy_field
2026-10-12 ✅ Renumbers WALK to the free 8 in the wire golden's renumbering test, as 6 is now ANIMATE and protoc refused the duplicate
2026-10-12 🐛 Fixes esp32-camera overflowing IRAM by 1896 bytes: the control and service task loops no longer sit in IRAM, where -Ofast inlined 12 KB of their callees, which run from flash like any task
2026-10-12 🐛 Fixes a walk entered from stand, or switched to the other gait while it stands, lifting a foot in one tick at up to 3,700 deg/s: it restarts the cycle at phase 0 with every foot down and no stroke 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
2026-10-12 ✨ Adds an AUTO gait, ported from the Hexapod: the crawl for a short stick and the trot for a long one, with hysteresis, swapped only at a standstill on all four feet
2026-10-12 ✨ Adds Show on robot to the animation editor, ported from the Hexapod: the robot holds the pose being edited from stand, easing back to stance when it is switched off, its client leaves or another mo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
2026-10-12 ✨ Adds firmware updates the robot downloads itself from an https URL through the update session, ported from the Hexapod, offered on the Firmware page as installing the latest release on a robot with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
2026-10-12 ✨ Adds servo_feasibility.py and servo_margin.py, ported from the Hexapod: the firmware's walk and animation traces against the MG92B's speed, slew lag and joint travel, and the servo speed each motio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
2026-10-12 🐛 Fixes esp32-camera and esp32dev overflowing their app slots by building them without the robot's own update download (USE_OTA_DOWNLOAD=0), which features report as ota_download so the Firmware page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
2026-10-12 🐛 Steps the synthetic recording's gait with the controller's step, which replaced advance_phase when the simulation took the firmware's walk
2026-10-12 🐛 Fixes the servo identification settling in a wrong cell of its rugged cost under the firmware's walk: searches the basins at the final lag, and takes the sigmas from how far the cells the data cann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
2026-10-12 ✨ Adds the servo supply voltage to the servo settings, from which the servo controller's slew limit and the walk's joint speed cap follow the MG92B's rating, live and at 6 V unless set
2026-10-12 📈 Reports each task's least free stack in the analytics and on the metrics page, tightest first, so a stack can be trimmed by what it never used
2026-10-12 ✨ Shows and edits the servo supply on the servo calibration page with the speeds it allows, and caps the firmware walk port by it
2026-10-12 ✨ Adds raw servo PWM writes and the servo settings to both backends, and lets the simulation's servos turn at a true PWM per degree other than the firmware's
2026-10-12 ✨ Adds measure_pwm_per_degree.py: fits the servos' PWM counts per degree from the roll a hip step gives, checked against a scale injected into the simulation
2026-10-12 ✨ Runs the Python client's speed model and the simulated walk at a servo supply, read from the robot by the real backend and 6 V otherwise
2026-10-12 📝 Documents the servo supply setting and the speeds it sets
2026-10-12 📝 Quotes the MG92B's 4.8 V rating that servo_output.h now holds in the servo margin tool
2026-10-12 ✨ Adds the INA219 power sensor on the servo rail: voltage and current streamed as PowerData and logged in the telemetry network samples, a low-battery cut-off that deactivates the robot after 2 s und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
2026-10-12 ✨ Loads the servo rail's voltage, lowest voltage and current from the telemetry network samples in the simulation's recordings
2026-10-12 ✨ Shows the servo rail on the IMU page and edits the power sensor's address, shunt, cut-off and stall threshold on the Sensors page
2026-10-12 📝 Documents the INA219 power sensor, its cut-off and stall flag, and the rail in the telemetry
2026-10-12 📝 Notes the power sensor in the changelog
2026-10-12 ✨ Records the goal statuses, and loads each tick's odometry, each goal status and each batch's newest tick from a recording
2026-10-12 🐛 Takes the PWM measurement's baselines with the servos held as its steps are, and refuses a robot without twelve calibrated joints
2026-10-12 ✨ Adds ground_truth.py: tracks an ArUco marker on the robot over a floor homography with the marker's height taken out, checked on rendered video
2026-10-12 ✨ Adds score_track.py and the floor benchmark: aligns a camera track with a recording on the start motion and scores the odometry and each goal move
2026-10-12 🐛 Walks the release smoke check in the trot and the crawl only, as AUTO has no sticks for a velocity and failed the check on every robot
2026-10-15 ⚡ Splits the hosted app's bundle so the simulation and other pages load their code when opened, keeping one bundle for the embedded build
2026-10-22 🐛 Stops the walk on all four feet before a gait chosen mid-stride, and centres the body for every trot
2026-10-22 🐛 Sends the goal status over every link, so a goal started over USB or Bluetooth reports its end at once
2026-10-22 🐛 Wakes the servo boards with every channel off and applies the servo page's switch on the control task
2026-10-22 🐛 Colours the charts with daisyUI 5's theme colours and fades the hex primary into a valid colour
2026-10-22 🐛 Plays the dialogs' exit transitions so a dialog opens again after another closes
2026-10-22 ✨ Answers a request the firmware does not handle with 501, which the app tells apart from a refusal
2026-10-22 🐛 Keeps the Python client's WebSocket keep-alive, so a robot that stopped answering closes the link
2026-10-22 👷 Publishes a release only once the firmware, simulation and frontend tests pass on its tag
2026-10-22 ✨ Reports the internal RAM apart from PSRAM, its largest block, its low mark and the refused allocations
2026-10-22 🐛 Regenerates the Python protocol bindings when a schema is newer than them
2026-10-22 🐛 Sends only the newest stick frame once a slow write completes, so Bluetooth and USB never walk on stale sticks
2026-10-22 🐛 Streams the camera from its own task to up to three viewers, so an open stream no longer holds the web server
2026-10-22 👷 Fails a board's build when its static internal RAM outgrows its budget
2026-10-22 🐛 Loads a settings file of zero bytes, a valid message, instead of replacing it with the defaults on every boot
2026-10-22 🐛 Restarts from a timer made at boot, as a task made at the restart could find no memory and the robot stayed up
2026-10-22 🐛 Gives the download client buffers that hold GitHub's signed redirect URL
2026-10-22 🐛 Releases the camera before the robot's own download, so its task finds internal RAM for its stack
2026-10-22 🐛 Reports a recording that got no frame from the robot instead of claiming it wrote one
2026-10-22 ⚡ Reads the Spot Pico build's flash in quad I/O, measured faster on the robot
2026-10-22 🐛 Gives the Python client's keep-alive 20 s for a pong, which a weak link on the Spot Pico took past 10 s
2026-10-22 🐛 Allocates mbedTLS from PSRAM, as a release download ran out of internal RAM verifying its second host
2026-10-23 🐛 Checks every task the firmware starts: a boot without its service, control or sensor task restarts, and the serial, Bluetooth and P4 camera tasks log and stay off
2026-10-23 🐛 Lets the unit tests read the built-in clips, which Vite 7.3 denies outside the app
2026-10-23 🚨 Seeds the 3D view's background setting with untrack, as Svelte 5.57 warns on the initial prop read
2026-10-23 ⬆️ Upgrades the app's dependencies past their security advisories
2026-10-23 🎨 Formats the app as Prettier 3.9 does
2026-10-23 ✅ Regenerates the app recording fixture, as ts-proto 2.18 omits empty packed repeated fields
2026-10-23 🐛 Eases the walk to a new step height, which a raised foot took in one tick
2026-10-23 🐛 Drops a Bluetooth stream out of step and reconnects the chosen device a bounded number of times after a drop
2026-10-23 ✨ Fails an action at once without a link, holds a settings write for 3 s and a read until its timeout from the call
2026-10-23 🐛 Keeps the feature flags through a link drop and forgets them when the user chooses another robot
2026-10-23 🐛 Asks AUTO's crawl and trot for one speed per stick, as the crawl walked 4.5 times slower and AUTO's swap jumped the speed
2026-10-23 🐛 Fuses the gyro's mean rate between the samples two ticks take, so a yaw rate that ripples with the tick no longer turns the heading
2026-10-23 ♻️ Reads every robot reply through robotRequest, so a refusal or firmware without the request shows instead of an empty answer
2026-10-23 🐛 Names a core dump's firmware by its whole ELF hash, as the dump kept 9 digits and the status page never matched it to the running firmware
2026-10-23 🐛 Measures the controller's silence as a signed difference, so an input posted after the control task read its clock no longer stops the walk
2026-10-23 ⬆️ Upgrades the simulation's advisory-flagged packages: pillow 13, setuptools 84, werkzeug 3.1.9, fsspec and torch 2.14
2026-10-23 🐛 Ends a goal whose client leaves any link or falls silent for 2 s, which a closed USB serial port does not otherwise signal
2026-10-23 🐛 Aims each goal turn at the heading the script's goals meant, and cancels a goal whose reply was lost or interrupted
2026-10-23 ✅ Checks the speed model only against the trace's walks at the client's step height, as the trace now walks a lower one
2026-10-23 ✨ Adds robot_animate.py, which lists, uploads, validates, plays, stops and watches the robot's clips from the command line
2026-10-23 📝 Adds a hardware acceptance record with the checks still waiting for the powered Pico
2026-10-23 📦 Holds daisyui and ts-proto at their previous versions, as their updates overflowed esp32-camera's app slot
2026-10-23 🐛 Takes a new step height at once while every foot is down, as eased from the default it lifted a walk's first steps off the command and toppled the Yertle in the app's simulation
2026-10-23 🐛 Judges a goal on where the walk's stop leaves the robot, holds a straight goal's heading and line, and walks up to three passes, so a fast turn no longer stops past its target reported reached
2026-10-23 📝 Notes the goal move, heading and controller silence fixes in the changelog
2026-10-23 📝 Notes that the app reads the robot's Bluetooth notifications more strictly than the robot reads the app's writes
2026-10-23 🔧 Drops the assertion messages on the classic ESP32, which frees 65 KB of esp32-camera's full app slot
2026-10-26 ✨ Simplifies the controller into one panel with a mode select, Deactivate and folded adjustments
2026-10-26 🐛 Drives only the simulation while the layout shows it, with its own mode and gait
2026-10-26 🐛 Keeps each robot's own sliders when the simulation takes or returns the controls
2026-10-26 ✅ Adds the sign-convention fixture and asserts it on the firmware: legs, body pose, walk and stand sticks, odometry and goals
2026-10-26 ✅ Asserts the sign-convention fixture on the simulation's gait and odometry ports, the client's sticks and its goal moves
2026-10-26 ✅ Asserts the sign-convention fixture on the app's firmware and Pico gait ports from the controller message on
2026-10-26 📝 Documents the body frame, leg numbering and every sign the fixture holds in docs/conventions.md
2026-10-26 ✨ Plays clips from the controller, in the simulation with the firmware's animation player
2026-10-26 🐛 Reads a gamepad's right stick pushed up as the on-screen stick pushed up
2026-10-26 💄 Draws the sticks as labelled white rings that thicken while held
2026-10-26 📝 Notes that the app negates both gamepad sticks' y, now that the right one is
2026-10-26 ✨ Adds the features, the servo settings and output, raw PWMs and telemetry recording to the Robot facade
2026-10-26 ♻️ Runs measure_pwm_per_degree.py on the Robot facade
2026-10-28 📝 Records the Pico's stand run: sensors at 400 kHz, the clips, the gait swaps and AUTO pass, and a moving tick overruns as before
2026-10-28 📝 Records the Pico's floor run: the stand's turn, tilt and heading pass, the rise and the wave roll the body, and the IMU stays asleep after a power cut
2026-10-28 📝 Records the floor reruns: the shifts pass, the IMU's level calibration fixes the lean, and the wave stays up only once it is levelled
2026-10-28 🐛 Reports ESP-NOW as unsupported on the P4 instead of reading a WiFi macro its IDF does not define, which broke its build
2026-10-28 🐛 Logs only warnings in the P4's bootloader, which had grown into the partition table and so got no factory image
2026-10-29 🐛 Refuses a camera setting the fitted sensor rejects, with the reason, and applies the stored settings at boot
2026-10-29 🐛 Shifts the wave's body 20 mm back and 25 mm right before the foot lifts, as 10 mm each tipped the Spot Pico
2026-10-29 ✅ Requires 20 mm of centre-of-mass margin from every built-in clip played to its end
2026-10-29 📝 Tells to prop the body level for the IMU's level calibration, as a limp Pico lies 17.6 degrees off
2026-10-29 ✨ Answers a subscribe to a state topic with its current value and an ack, and resends a state push a client could not take
2026-10-29 ✨ Adds the motion update's parts and the servo write's wait for the I2C bus to each telemetry tick
2026-10-29 ✨ Reports the tick's parts per mode in report_recording.py and on the System Metrics page
2026-10-29 ✨ Adds watch() to the app and follows the mode, gait, WiFi, clip and download status from their state topics
2026-10-29 ⚡ Holds the telemetry tick's PWM values and parts in 16 bits on the robot, so its ring takes less internal RAM than before the parts
2026-10-29 ⚡ Draws the 3D views only on a frame that changed what they show
2026-10-29 🐛 Takes over a mode at the height and sticks the client last sent, which flaked the sim-vs-real cadence test
2026-10-29 ✨ Follows the goal status in the Python client from its state topic, and skips the clip status a subscribe is answered with
2026-10-29 ✨ Serves the servo, peripheral, WiFi and AP settings as state topics pushed on every stored change, and reads them in the Python client
2026-10-29 ✨ Follows the settings topics in the app's forms, keeping an edit apart from a change stored meanwhile
2026-10-29 🔥 Deletes the settings get requests the settings topics replaced, reserving their numbers
2026-10-29 🐛 Starts the servo board before the sensor task probes the IMU, which went undetected on half the boots when both shared the bus
2026-10-29 ✨ Waves the front left paw from the knee, with the hip and femur held, as the side-to-side foot waved from the hip
2026-10-29 🐛 Raises the waving paw and keeps the knee short of straight, as the paw touched the floor on the Spot Pico
2026-11-08 🐛 Greets each new WebSocket on the virtual robot with a pong, as the firmware does, so the app's probe finds it
    The web app's discovery probe (probeAddress) waits for the initial
    pongmsg frame that Websocket::onWsOpen sends on the firmware before
    marking an address online. Forward socket open events ('o') from
    virtual_robot.py to virtual_robot.cpp so PipeLink sends the same
    greeting pong on connect.
2026-11-08 ✨ Probes 127.0.0.1:8765 among the well-known hosts so the app finds a local virtual robot on start
    Adds the default virtual_robot.py address (127.0.0.1:8765) to
    WELL_KNOWN_HOSTS so the start page discovers a locally running virtual
    robot automatically without manual address configuration.
2026-11-08 📝 Adds pack_animations.py to the firmware host test commands in docs/6_developing.md
2026-11-08 🐛 Includes unistd.h in filesystem_ws.cpp for rmdir() when built on Linux
2026-11-08 🐛 Keeps the odometry of a robot standing still at zero where the build fuses multiply-adds, as the firmware and the new CI runner do
